smtzcn81/muhasebe/assets/urunler/png/123456.png

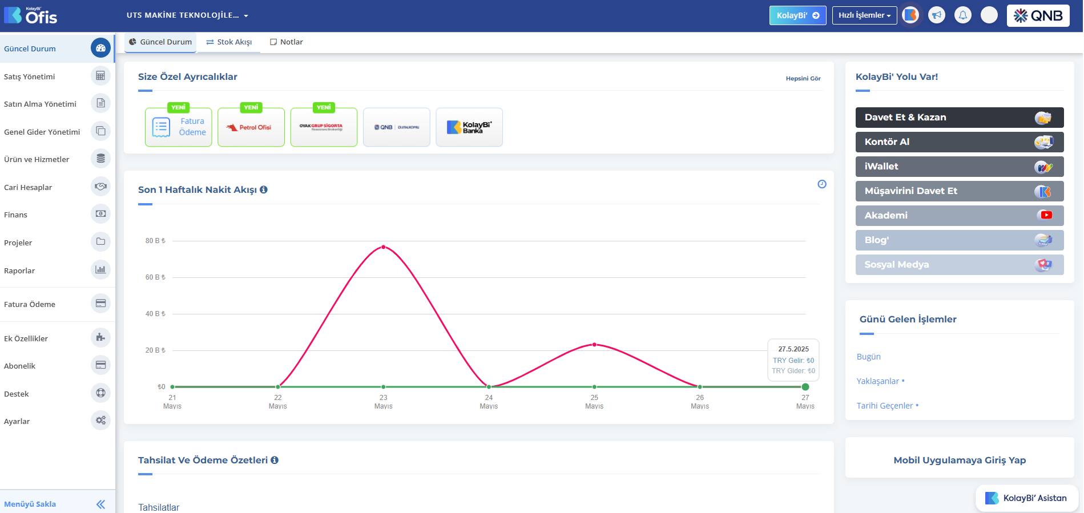
assets/urunler/png/123456.png
