smtzcn81/muhasebe/assets/urunler/xlsx/26092021_Bloklar_isleme.xlsx

KOD | TANIM | ADET | TEDARİKÇİ | BİRİM FİYAT | TOPLAM FİYAT | Termin Tarihi | Termin süresi
1196005001 | DIZME SASE | 1 | alsancak makına
1187003001 | USTTEN DIZME UST SABIT PLAKA | 1 | alsancak makına
1195006001 | FORMLAMA ALT SABİT BLOK | 1 | alsancak makına
1195012001 | FORMLAMA HAREKETLİ BLOK | 1 | alsancak makına
1195004001 | FORMLAMA ÜST SABİT BLOK | 1 | Alsancak makına
1193017001 | KESME ALT SABİT BLOK | 1 | Alsancak makına
1193014001 | KESME HAREKETLİ ALT-ÜST BLOK | 2 | alsancak makına
1193005001 | KESME UST SABİT BLOK | 1 | alsancak makına
