smtzcn81/muhasebe/assets/urunler/dxf/Kesme_2.dxf

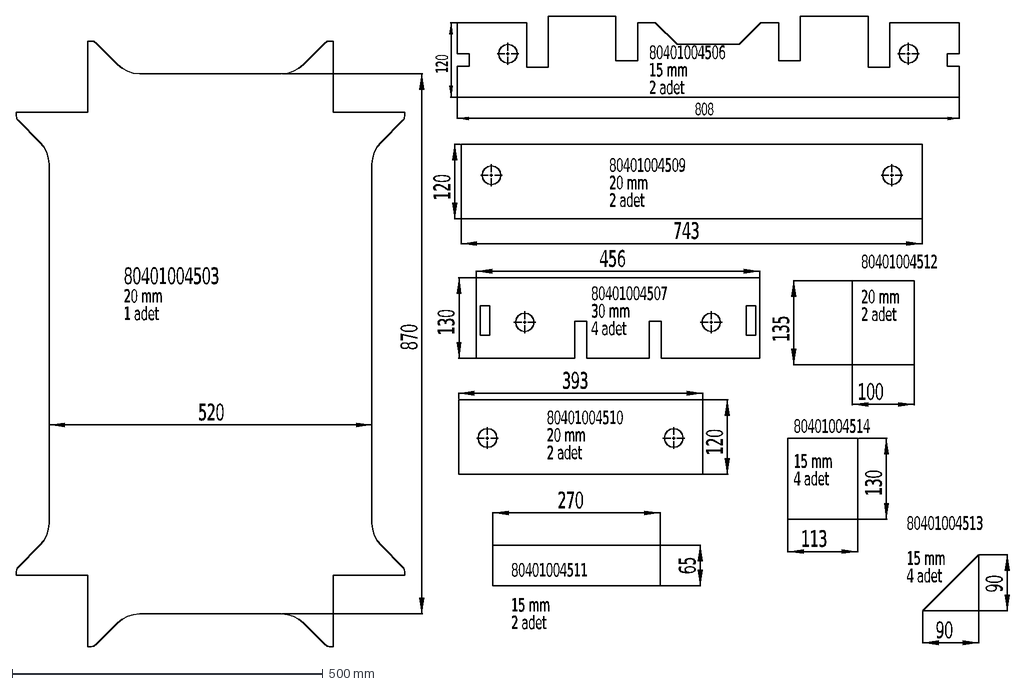
[picture p2: CAD file, 2025-06-05]
assets/urunler/dxf/Kesme_2.dxf
80401004503
20 mm
1 adet
520
870
808
120
80401004506
15 mm
2 adet
130
456
80401004507
30 mm
4 adet
743
80401004509
393
80401004510
65
270
80401004511
135
100
80401004512
90
80401004513
113
80401004514
