smtzcn81/muhasebe/assets/urunler/dxf/U6KA001003A.dxf

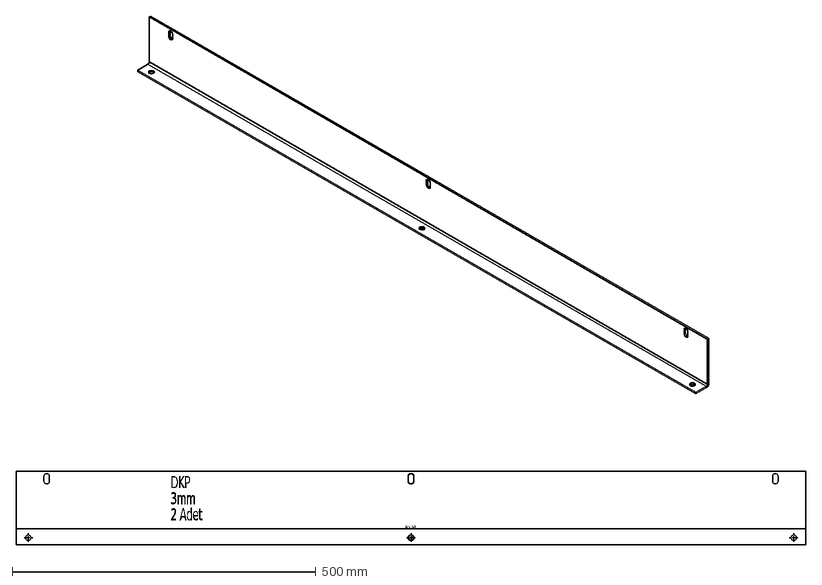
[picture p3: CAD file, 2025-06-05]
assets/urunler/dxf/U6KA001003A.dxf
UP 90° R 3
DKP
3mm
2 Adet
