smtzcn81/muhasebe/assets/urunler/dxf/Konveyor_Braket.dxf

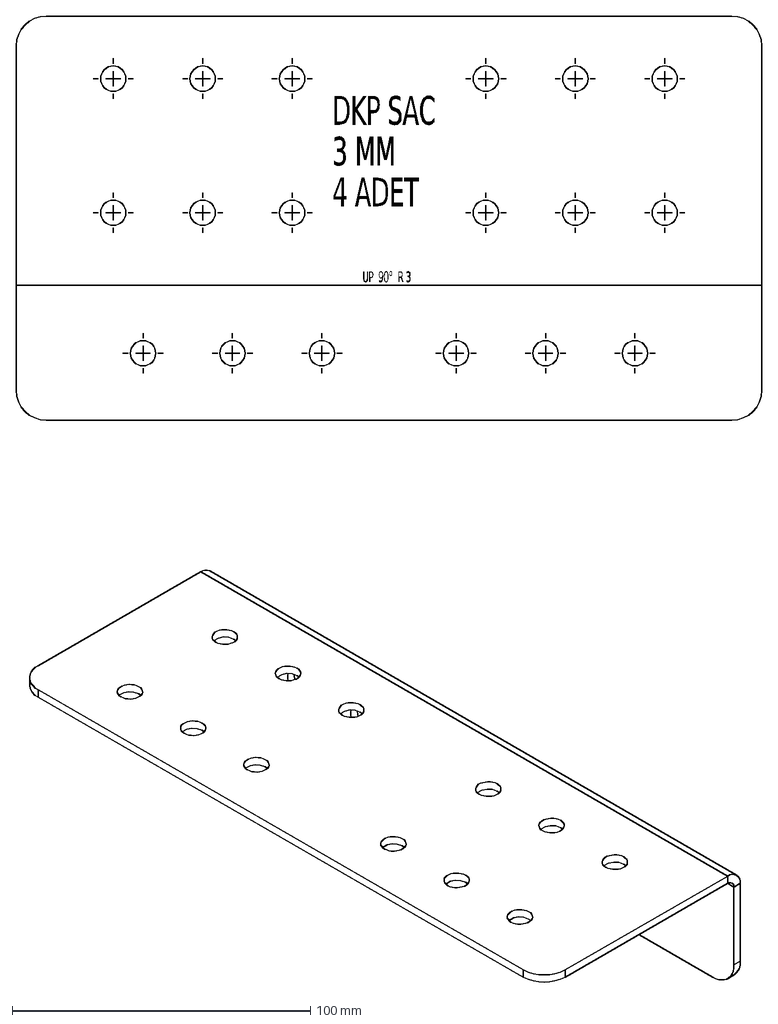
[picture p4: CAD file, 2025-06-05]
assets/urunler/dxf/Konveyor_Braket.dxf
DKP SAC
3 MM
4 ADET
UP 90° R 3
