smtzcn81/muhasebe/assets/urunler/dxf/US94-1104-015002.dxf

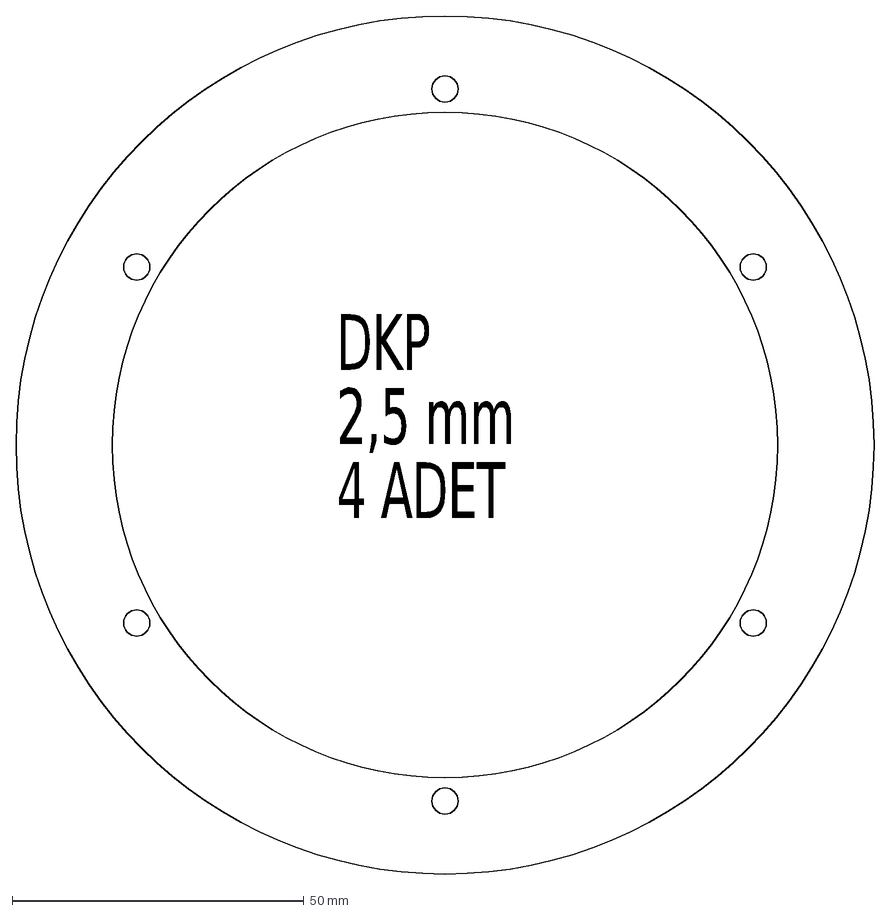
[picture p5: CAD file, 2025-06-05]
assets/urunler/dxf/US94-1104-015002.dxf
DKP
2,5 mm
4 ADET
