smtzcn81/muhasebe/assets/urunler/dxf/Form_3.dxf

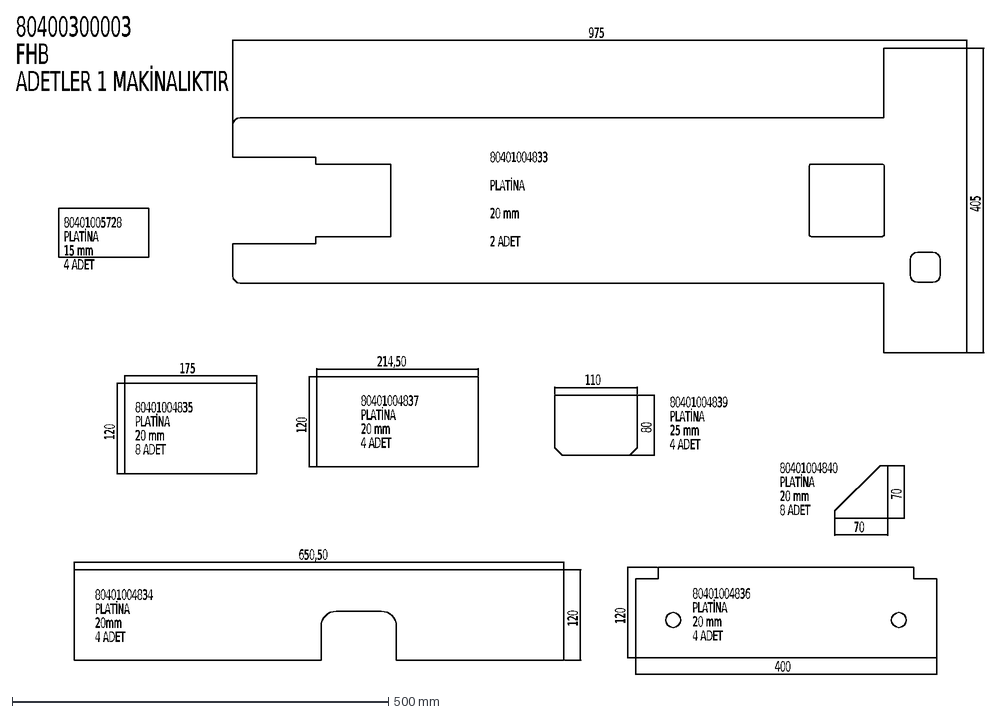
[picture p6: CAD file, 2025-06-05]
assets/urunler/dxf/Form_3.dxf
80401004837
PLATİNA
20 mm
4 ADET
80401004836
80400300003
FHB
ADETLER 1 MAKİNALIKTIR
405
975
80401004833
2 ADET
650,50
120
80401004834
20mm
175
80401004835
8 ADET
400
214,50
110
80
80401004839
25 mm
70
80401004840
80401005728
15 mm
