smtzcn81/muhasebe/assets/urunler/dxf/U6BS001004B.dxf

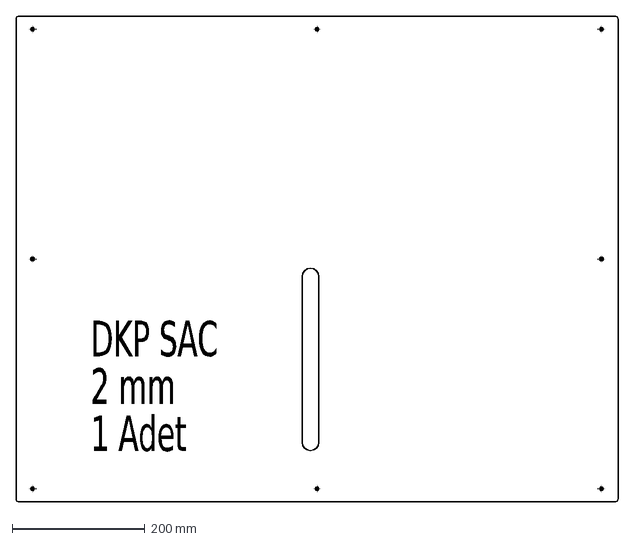
[picture p7: CAD file, 2025-06-05]
assets/urunler/dxf/U6BS001004B.dxf
DKP SAC
2 mm
1 Adet
