smtzcn81/muhasebe/assets/urunler/dxf/Kesme_3.dxf

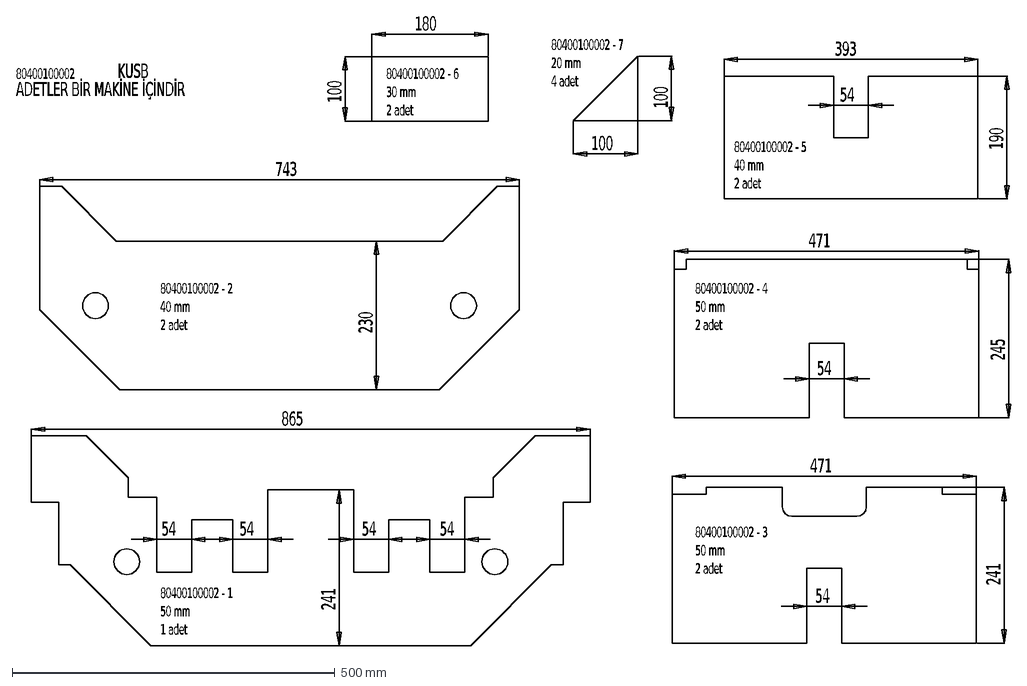
[picture p8: CAD file, 2025-06-05]
assets/urunler/dxf/Kesme_3.dxf
80400100002
KUSB
ADETLER BİR MAKİNE İÇİNDİR
80400100002 - 1
50 mm
1 adet
80400100002 - 2
40 mm
2 adet
80400100002 - 3
80400100002 - 4
80400100002 - 5
80400100002 - 6
30 mm
80400100002 - 7
20 mm
4 adet
230
743
865
241
54
471
245
190
393
180
100
