smtzcn81/muhasebe/assets/urunler/dxf/Panel_On_Sac.dxf

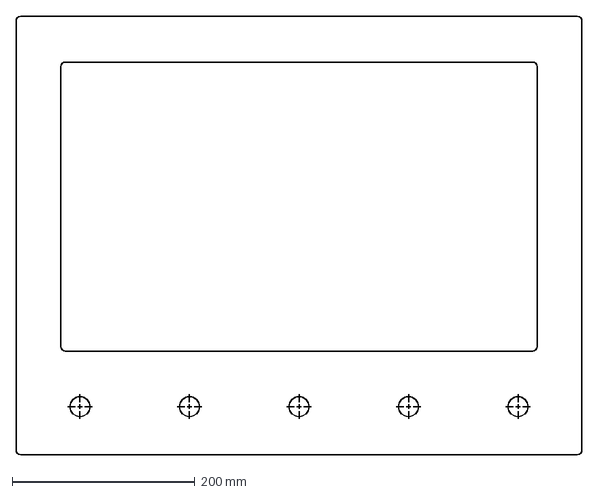
[picture p9: CAD file, 2025-06-05]
assets/urunler/dxf/Panel_On_Sac.dxf
620.0 x 480.0 mm
