smtzcn81/muhasebe/assets/urunler/dxf/Form_1.dxf

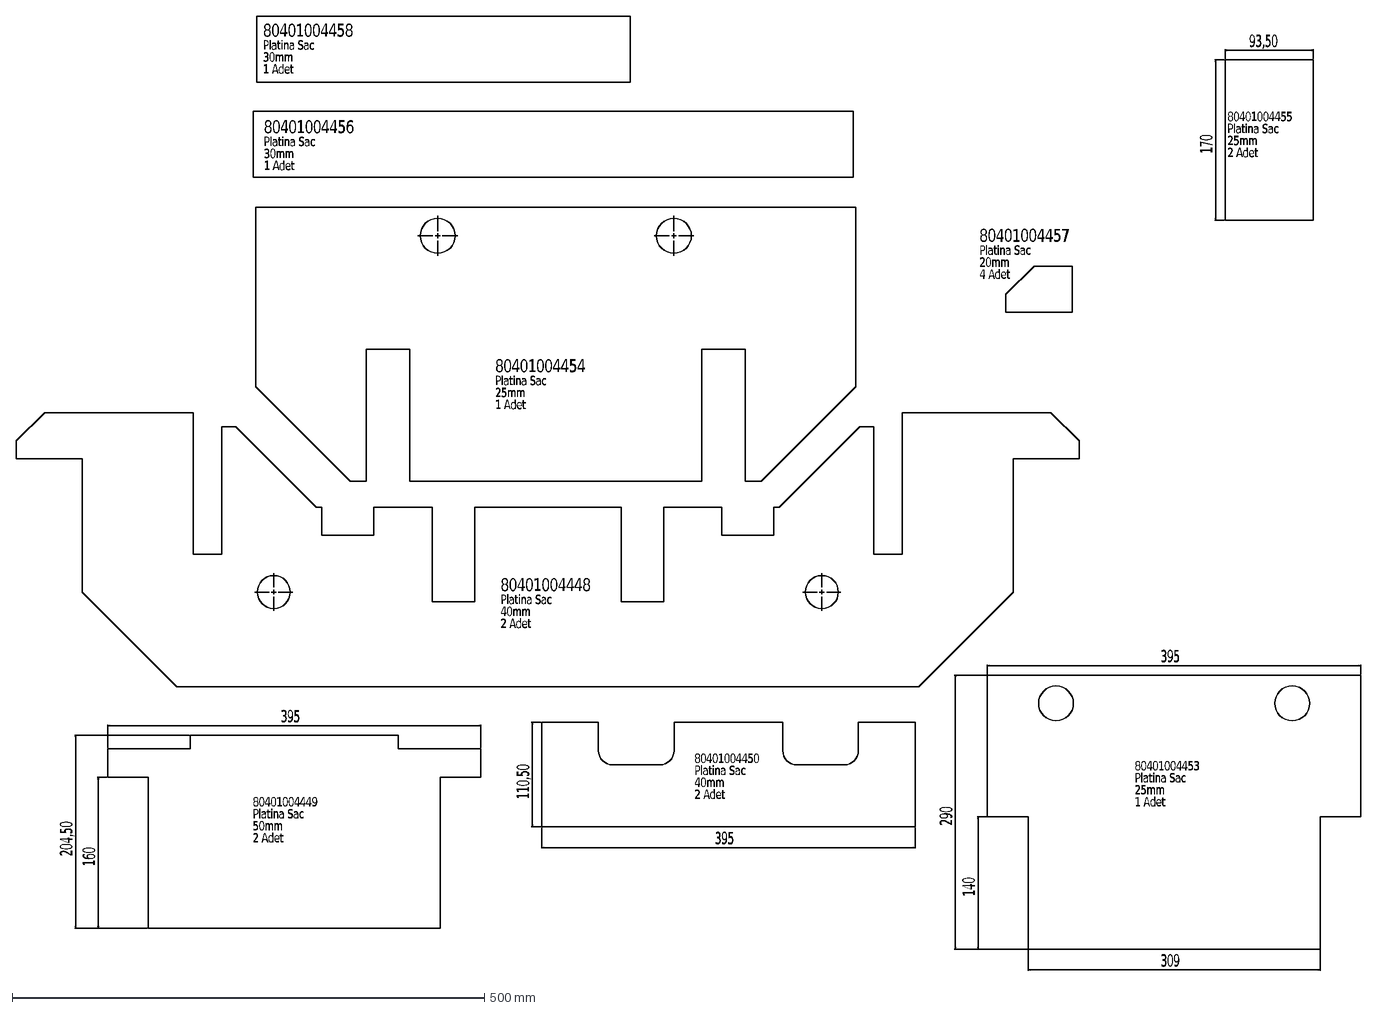
[picture p10: CAD file, 2025-06-05]
assets/urunler/dxf/Form_1.dxf
80401004448
Platina Sac
40mm
2 Adet
395
140
290
309
80401004453
25mm
1 Adet
204,50
160
80401004449
50mm
110,50
80401004450
93,50
170
80401004455
80401004454
80401004456
30mm
80401004457
20mm
4 Adet
80401004458
