smtzcn81/muhasebe/assets/urunler/dxf/Besleme_6545_U6_0105.dxf

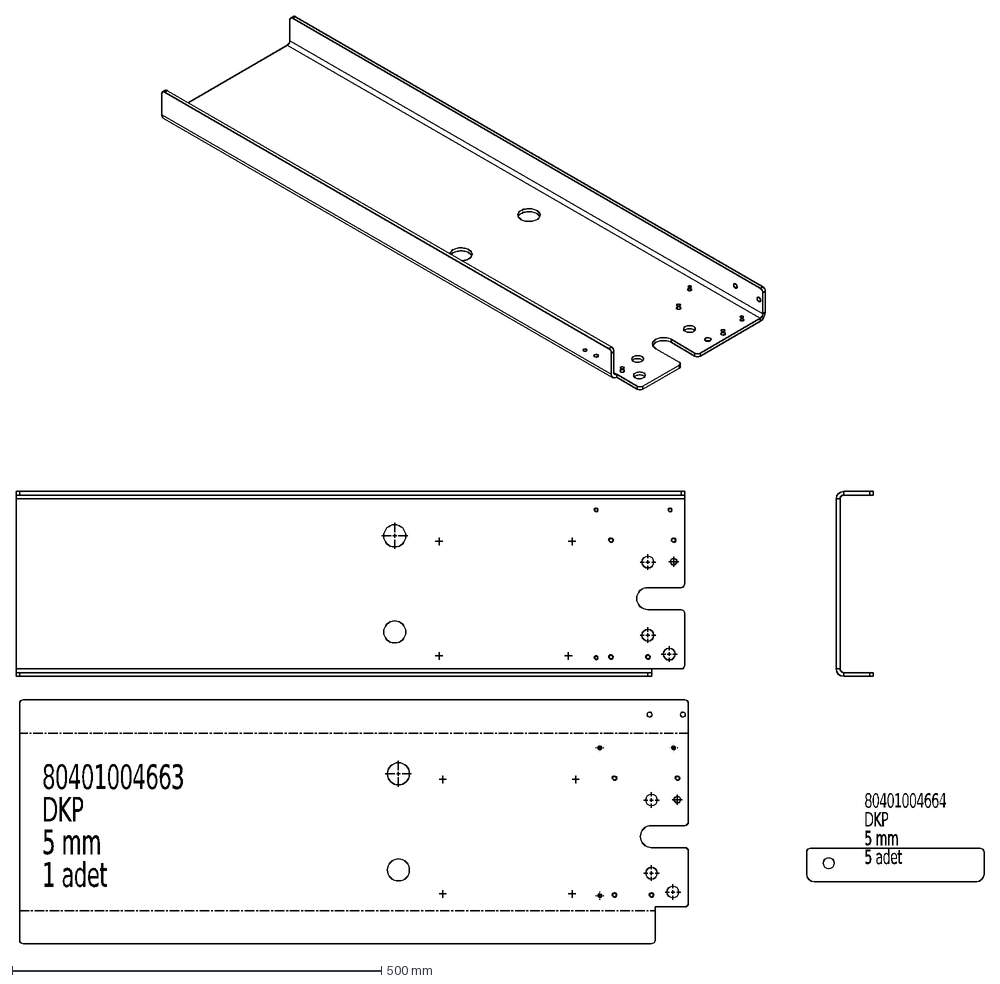
[picture p11: CAD file, 2025-06-05]
assets/urunler/dxf/Besleme_6545_U6_0105.dxf
80401004663
DKP
5 mm
1 adet
80401004664
5 adet
