smtzcn81/muhasebe/assets/urunler/dxf/U6KA004002A.dxf

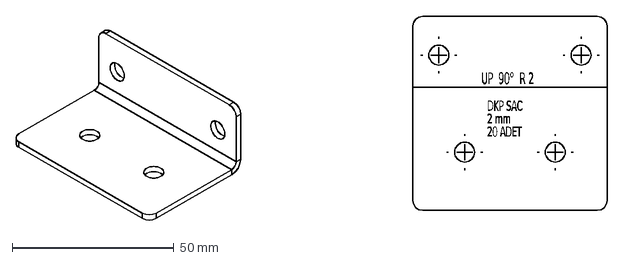
[picture p12: CAD file, 2025-06-05]
assets/urunler/dxf/U6KA004002A.dxf
DKP SAC
2 mm
20 ADET
UP 90° R 2
