smtzcn81/muhasebe/assets/urunler/dxf/U6KA001007A.dxf

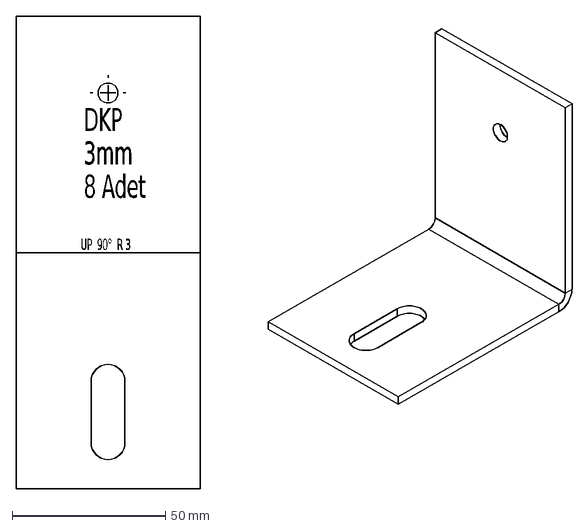
[picture p13: CAD file, 2025-06-05]
assets/urunler/dxf/U6KA001007A.dxf
DKP
3mm
8 Adet
UP 90° R 3
