smtzcn81/muhasebe/assets/urunler/dxf/U6KA001004A.dxf

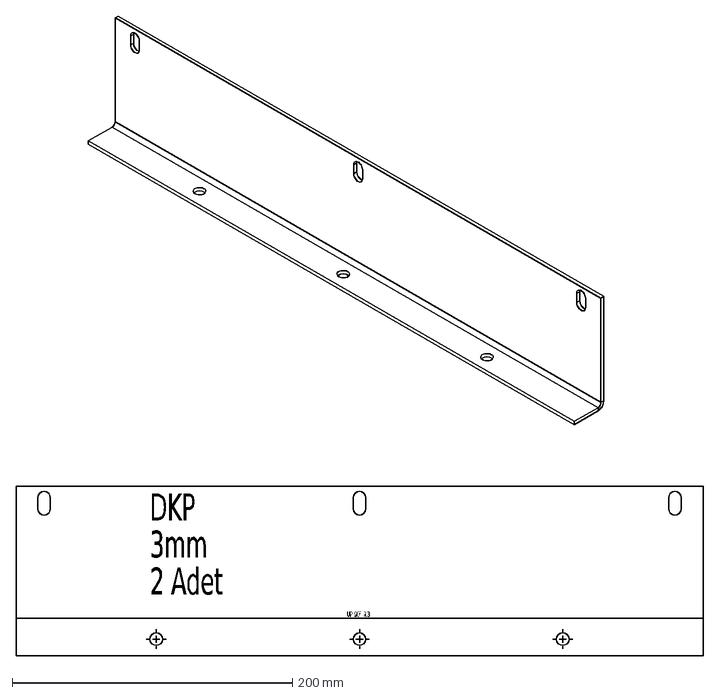
[picture p14: CAD file, 2025-06-05]
assets/urunler/dxf/U6KA001004A.dxf
UP 90° R 3
DKP
3mm
2 Adet
