smtzcn81/muhasebe/assets/urunler/dxf/U6KA001006A.dxf

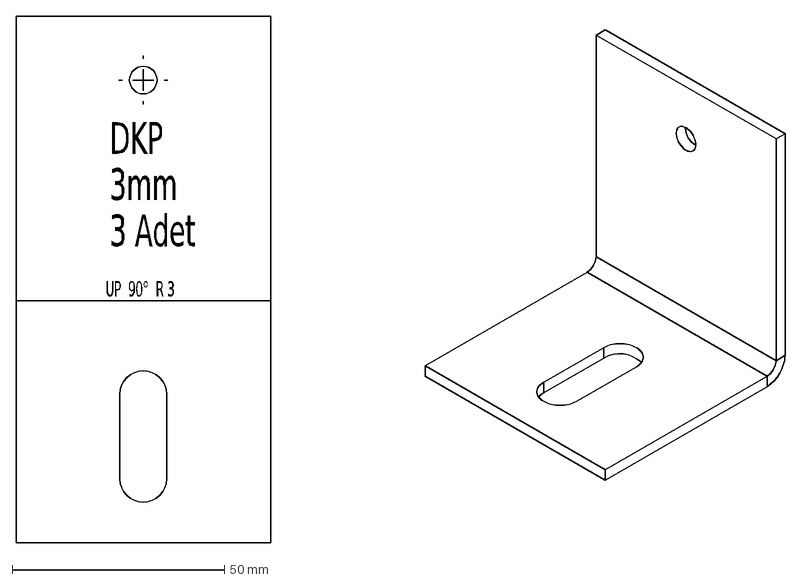
[picture p15: CAD file, 2025-06-05]
assets/urunler/dxf/U6KA001006A.dxf
DKP
3mm
3 Adet
UP 90° R 3
