smtzcn81/muhasebe/assets/urunler/dxf/U6KA001005A.dxf

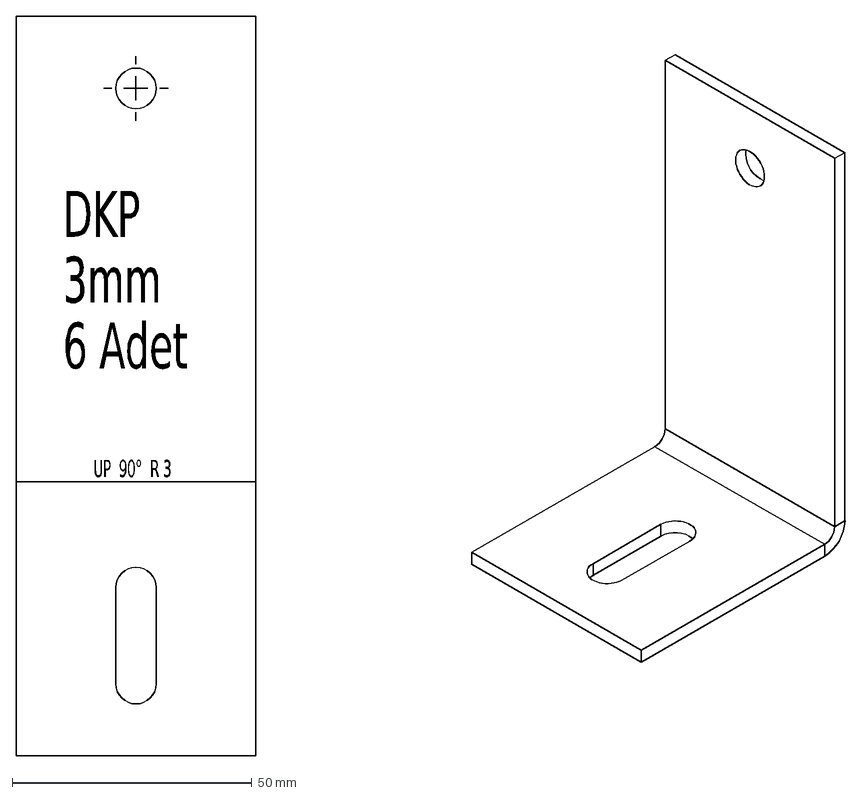
[picture p16: CAD file, 2025-06-05]
assets/urunler/dxf/U6KA001005A.dxf
DKP
3mm
6 Adet
UP 90° R 3
