smtzcn81/muhasebe/assets/urunler/dxf/Delme_Parcasi.dxf

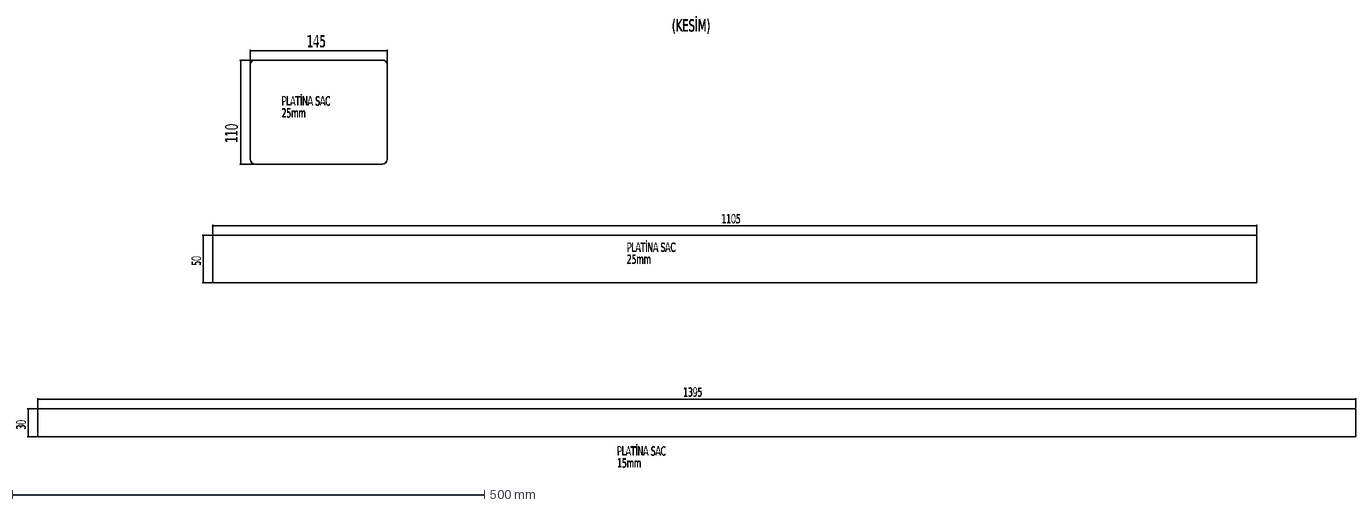
[picture p17: CAD file, 2025-06-05]
assets/urunler/dxf/Delme_Parcasi.dxf
1105
50
PLATİNA SAC
25mm
(KESİM)
30
1395
15mm
145
110
