smtzcn81/muhasebe/assets/urunler/dxf/Tava_Mal_ERidi_002.dxf

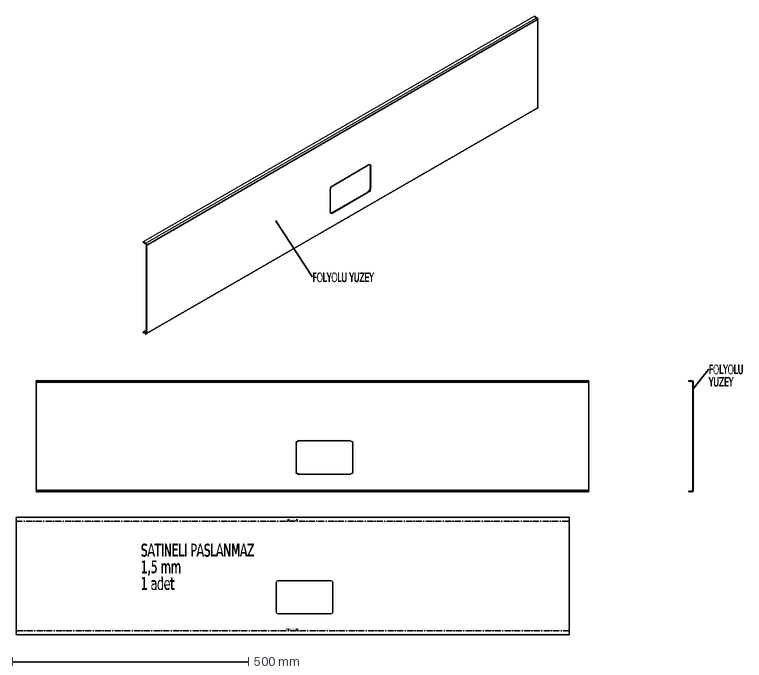
[picture p18: CAD file, 2025-06-05]
assets/urunler/dxf/Tava_Mal_ERidi_002.dxf
SATINELI PASLANMAZ
1,5 mm
1 adet
DOWN 90.00° R 1.50
FOLYOLU
YUZEY
FOLYOLU YUZEY
