smtzcn81/muhasebe/assets/urunler/dxf/U6KA001008A.dxf

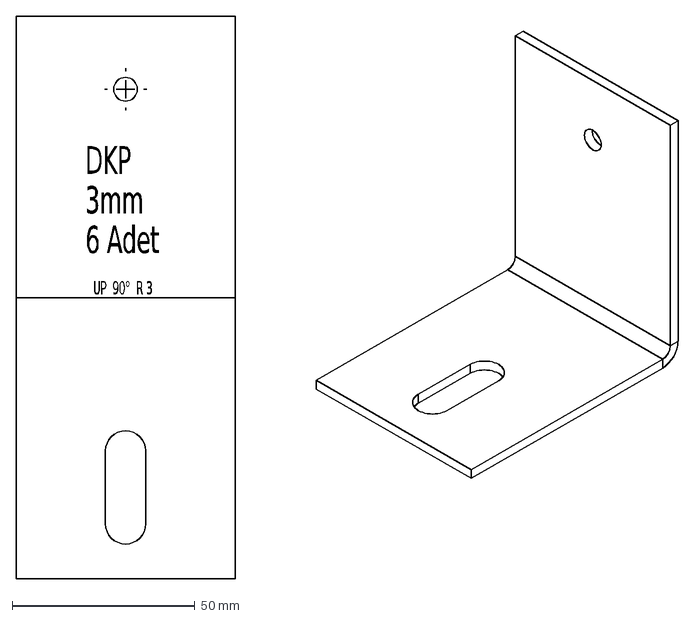
[picture p19: CAD file, 2025-06-05]
assets/urunler/dxf/U6KA001008A.dxf
DKP
3mm
6 Adet
UP 90° R 3
