smtzcn81/muhasebe/assets/urunler/dxf/Kesme_1.dxf

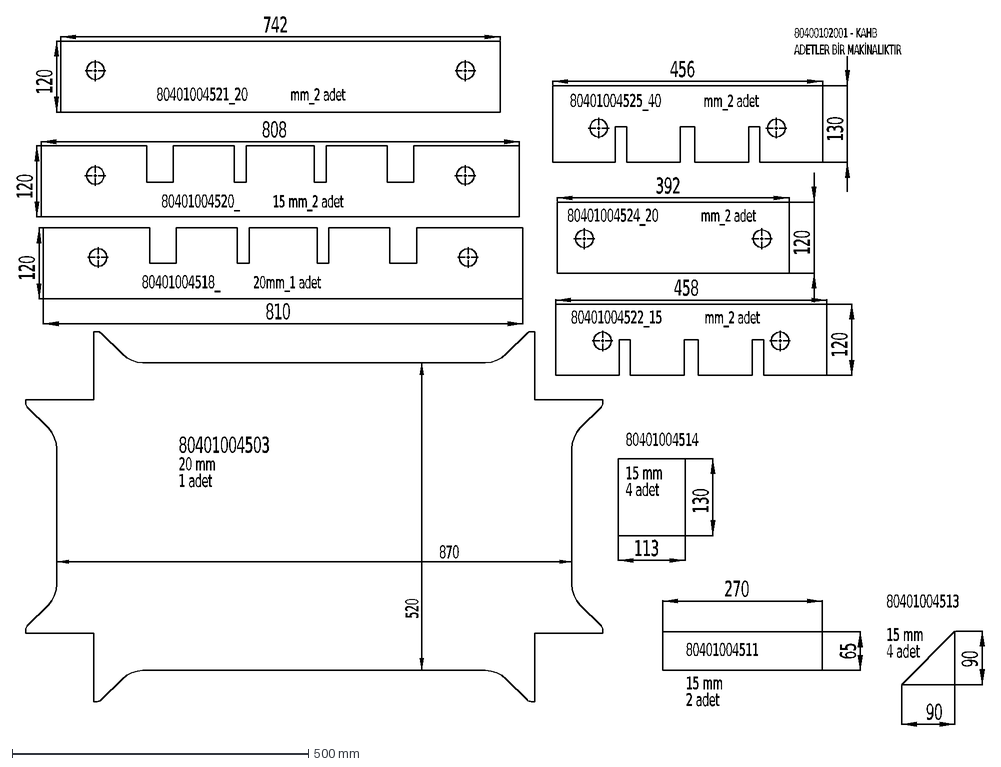
[picture p20: CAD file, 2025-06-05]
assets/urunler/dxf/Kesme_1.dxf
80401004518_
20mm_1 adet
520
870
80400102001 - KAHB
ADETLER BİR MAKİNALIKTIR
80401004503
20 mm
1 adet
90
80401004513
15 mm
4 adet
130
113
80401004514
65
270
80401004511
2 adet
810
120
808
80401004520_
15 mm_2 adet
742
80401004521_20
mm_2 adet
458
80401004522_15
392
80401004524_20
456
80401004525_40
