smtzcn81/muhasebe/assets/urunler/dxf/U6KA001001A.dxf

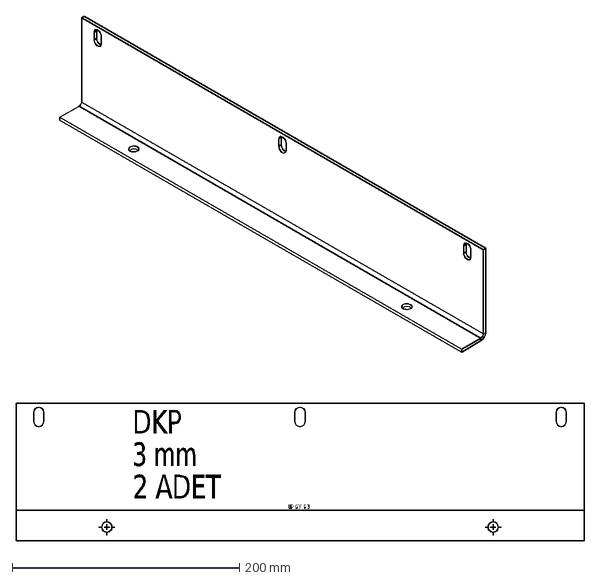
[picture p21: CAD file, 2025-06-05]
assets/urunler/dxf/U6KA001001A.dxf
DKP
3 mm
2 ADET
UP 90° R 3
