smtzcn81/muhasebe/assets/urunler/dxf/Besleme_6545_U6_0104.dxf

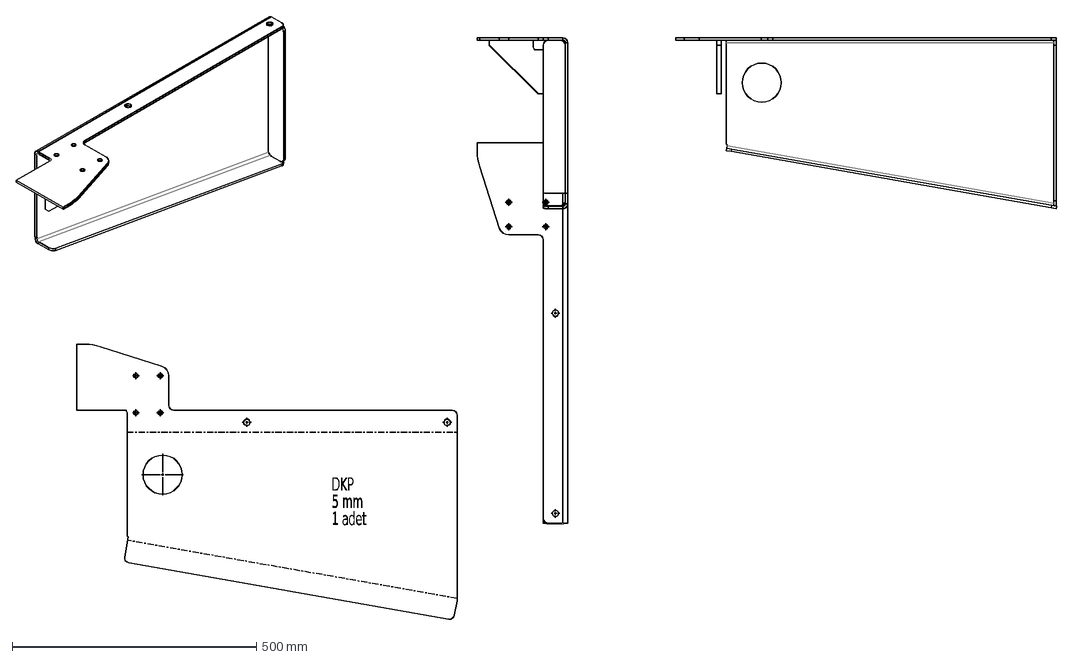
[picture p22: CAD file, 2025-06-05]
assets/urunler/dxf/Besleme_6545_U6_0104.dxf
DKP
5 mm
1 adet
