smtzcn81/muhasebe/assets/urunler/dxf/Kesme_4.dxf

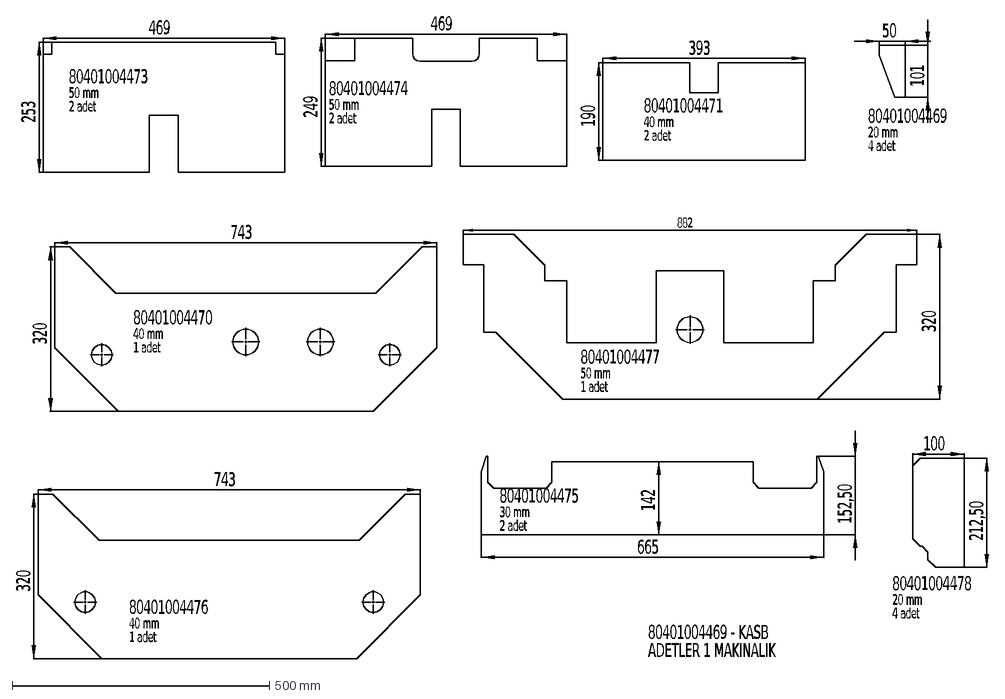
[picture p23: CAD file, 2025-06-05]
assets/urunler/dxf/Kesme_4.dxf
80401004476
40 mm
1 adet
80401004470
80401004473
50 mm
2 adet
80401004469 - KASB
ADETLER 1 MAKINALIK
50
101
80401004469
20 mm
4 adet
743
320
393
190
80401004471
469
253
249
80401004474
882
80401004477
212,50
100
80401004478
142
152,50
665
80401004475
30 mm
