smtzcn81/muhasebe/assets/urunler/dxf/Form_2.dxf

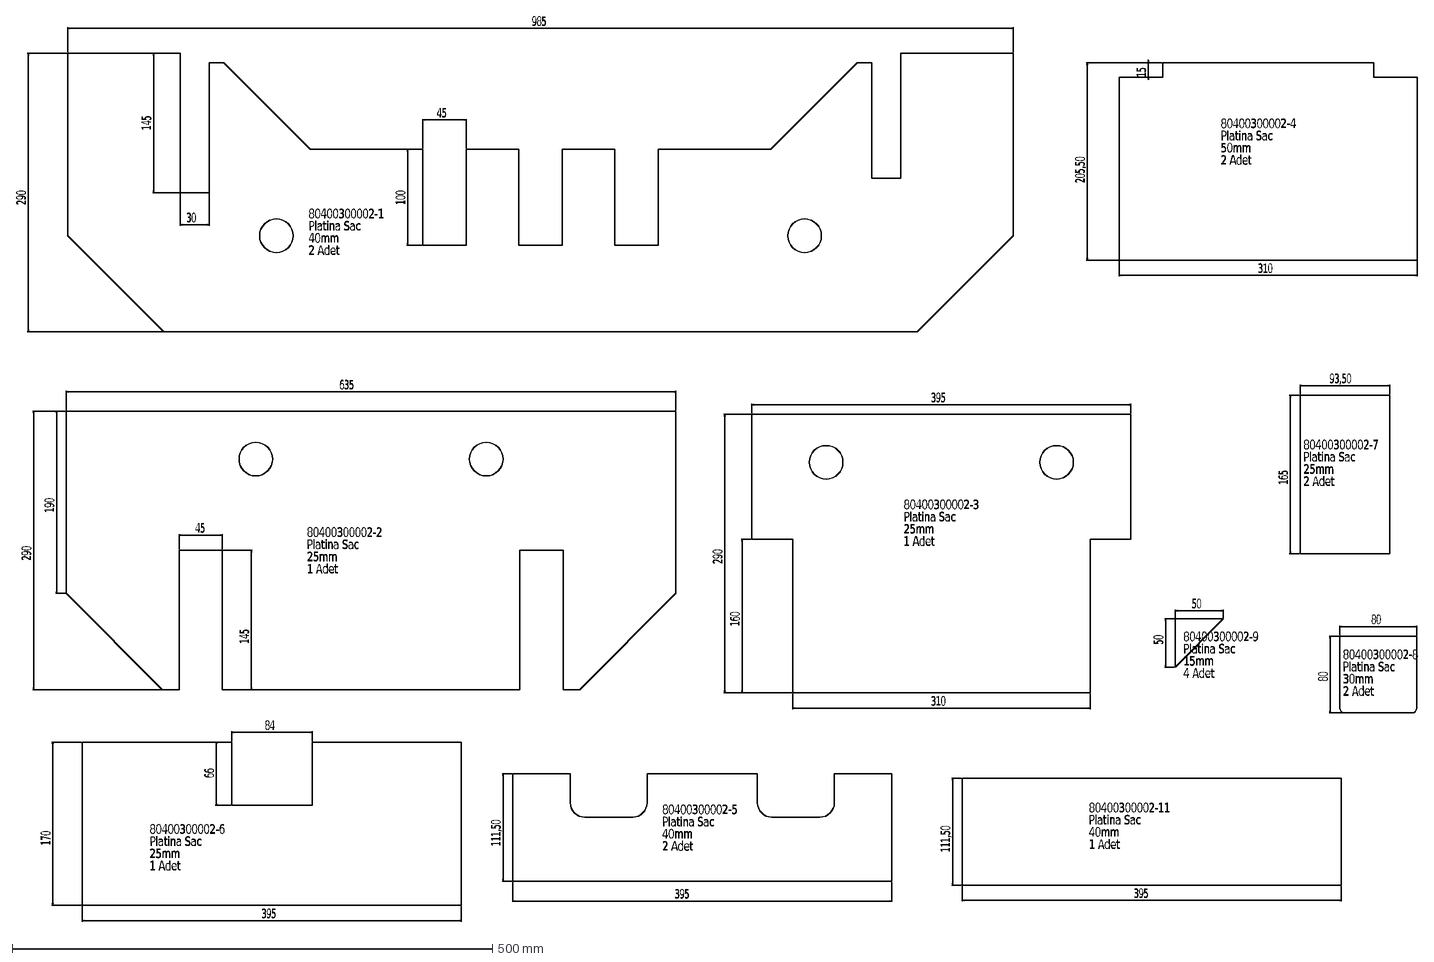
[picture p24: CAD file, 2025-06-05]
assets/urunler/dxf/Form_2.dxf
985
290
45
100
145
30
80400300002-1
Platina Sac
40mm
2 Adet
635
190
80400300002-2
25mm
1 Adet
395
160
310
80400300002-3
205,50
15
80400300002-4
50mm
111,50
80400300002-5
80400300002-11
170
84
66
80400300002-6
93,50
165
80400300002-7
80
80400300002-8
30mm
50
80400300002-9
15mm
4 Adet
