smtzcn81/muhasebe/assets/urunler/dxf/Besleme_6545_U6_0106.dxf

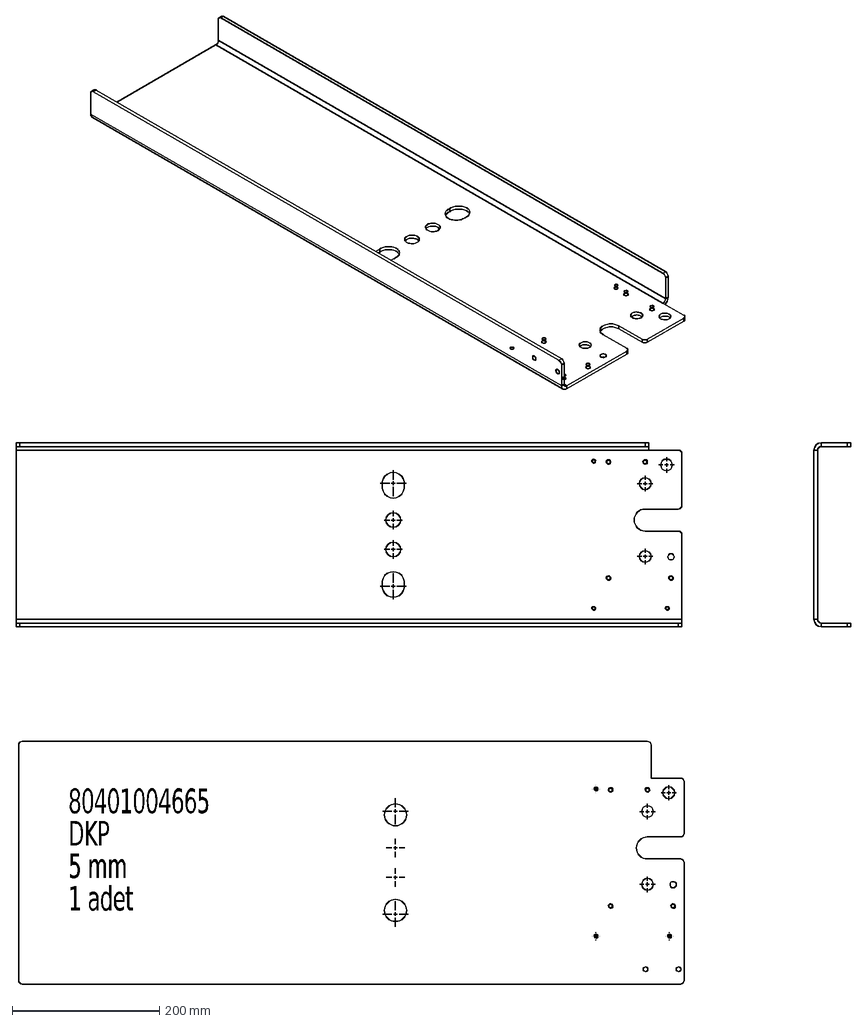
[picture p25: CAD file, 2025-06-05]
assets/urunler/dxf/Besleme_6545_U6_0106.dxf
80401004665
DKP
5 mm
1 adet
