smtzcn81/muhasebe/assets/urunler/dxf/Sac_Kesim_Parcalar.dxf

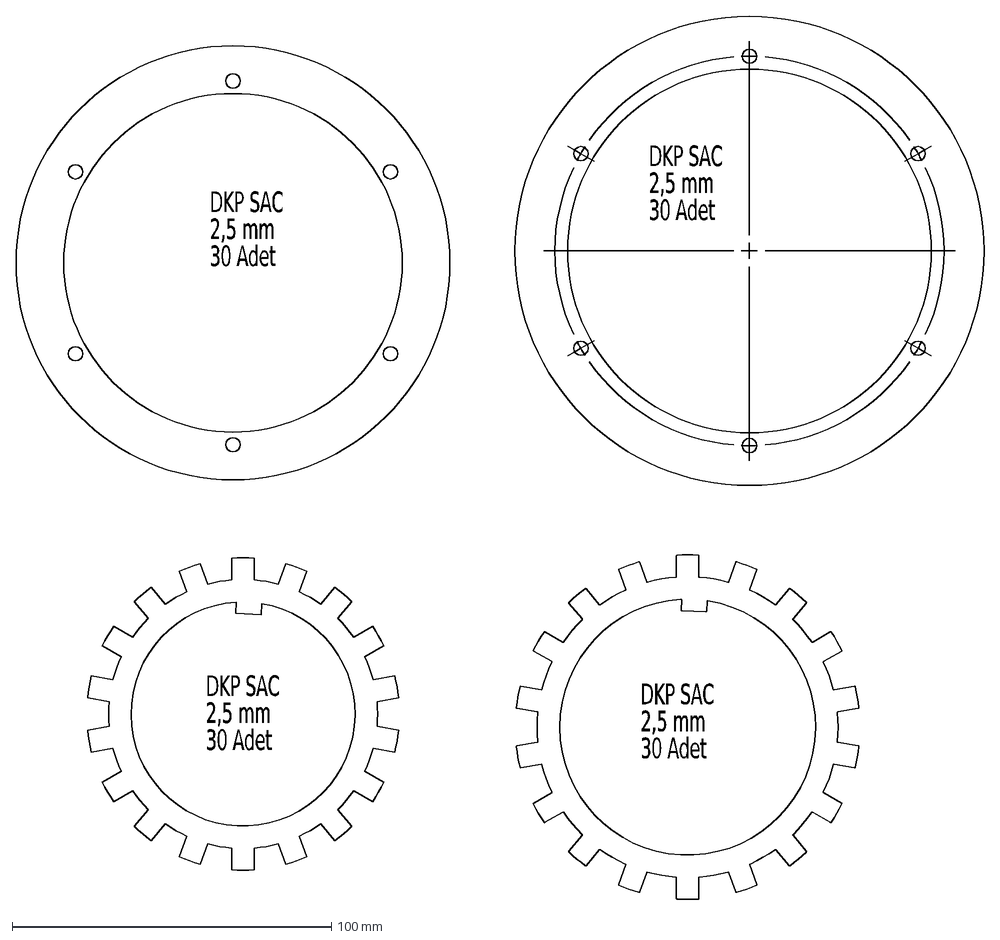
[picture p26: CAD file, 2025-06-05]
assets/urunler/dxf/Sac_Kesim_Parcalar.dxf
DKP SAC
2,5 mm
30 Adet
