smtzcn81/muhasebe/assets/urunler/dxf/U6KA006002A.dxf

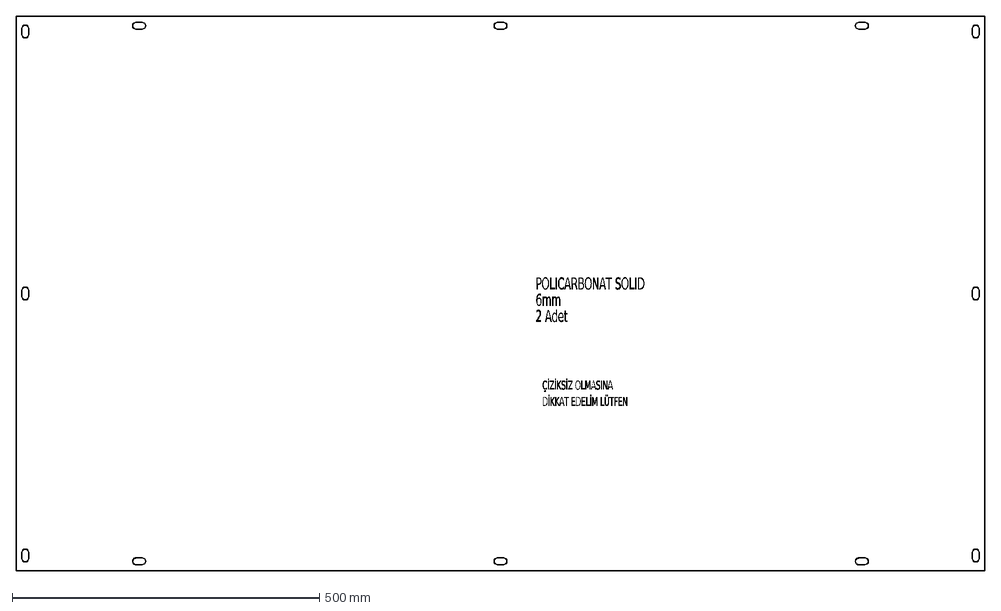
[picture p27: CAD file, 2025-06-05]
assets/urunler/dxf/U6KA006002A.dxf
POLICARBONAT SOLID
6mm
2 Adet
ÇİZİKSİZ OLMASINA
DİKKAT EDELİM LÜTFEN
