smtzcn81/muhasebe/assets/urunler/dxf/U6KA002001A.dxf

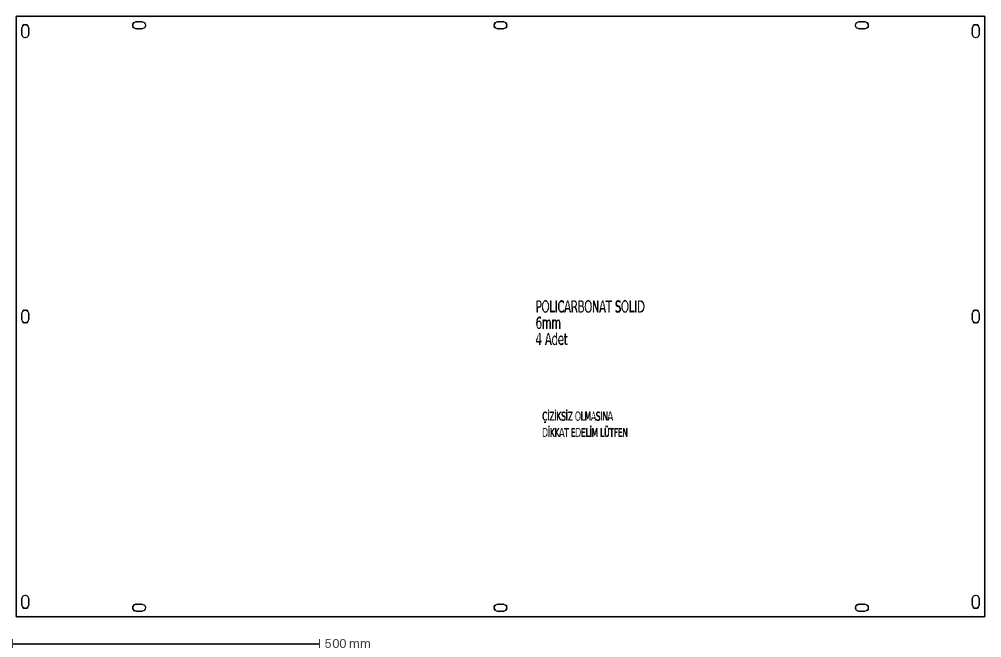
[picture p28: CAD file, 2025-06-05]
assets/urunler/dxf/U6KA002001A.dxf
POLICARBONAT SOLID
6mm
4 Adet
ÇİZİKSİZ OLMASINA
DİKKAT EDELİM LÜTFEN
