smtzcn81/muhasebe/assets/urunler/dxf/U6OP001004A.dxf

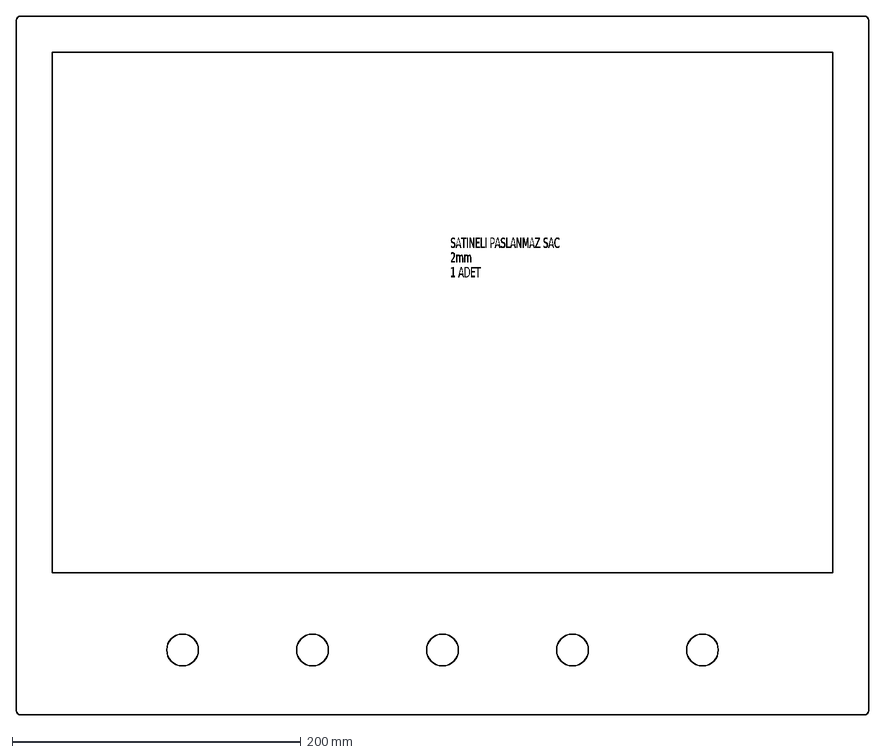
[picture p29: CAD file, 2025-06-05]
assets/urunler/dxf/U6OP001004A.dxf
SATINELI PASLANMAZ SAC
2mm
1 ADET
