smtzcn81/muhasebe/assets/urunler/dxf/Besleme_6545_U6_0103.dxf

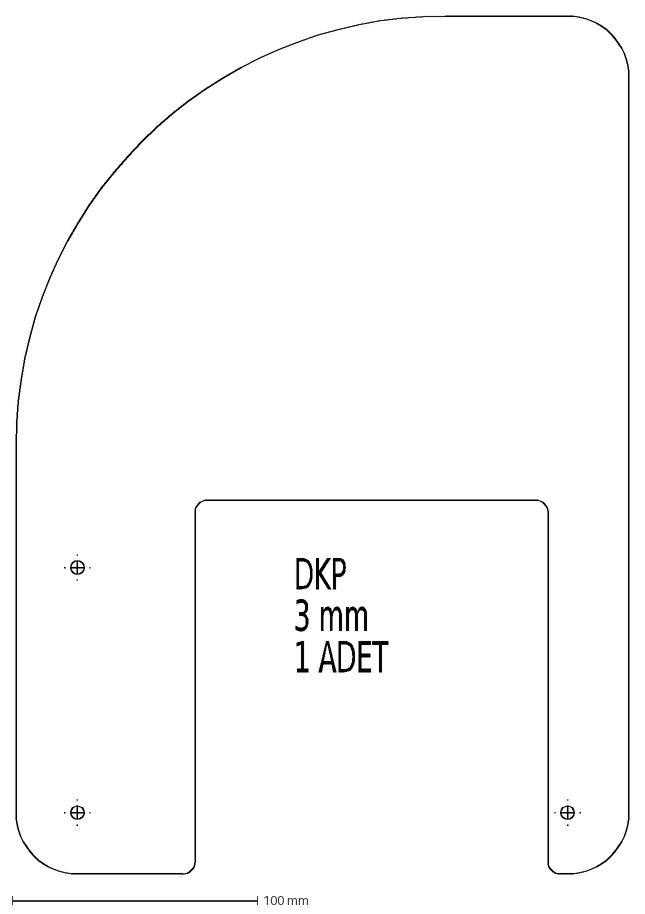
[picture p30: CAD file, 2025-06-05]
assets/urunler/dxf/Besleme_6545_U6_0103.dxf
DKP
3 mm
1 ADET
