smtzcn81/muhasebe/assets/urunler/dxf/SolKapamaS.dxf

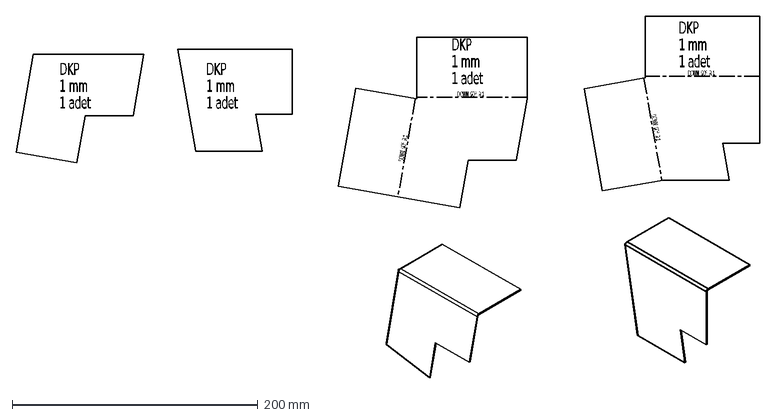
[picture p31: CAD file, 2025-06-05]
assets/urunler/dxf/SolKapamaS.dxf
DKP
1 mm
1 adet
DOWN 90° R 1
