smtzcn81/muhasebe/assets/urunler/dxf/U6KA001002A.dxf

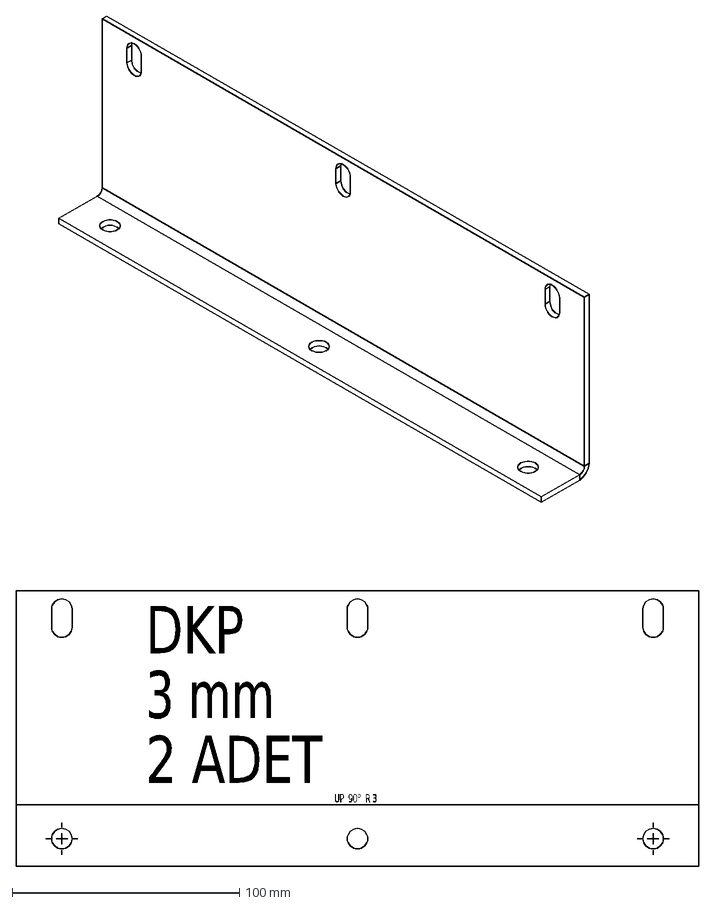
[picture p32: CAD file, 2025-06-05]
assets/urunler/dxf/U6KA001002A.dxf
DKP
3 mm
2 ADET
UP 90° R 3
