smtzcn81/muhasebe/assets/urunler/dxf/arkabaglamasaci2.dxf

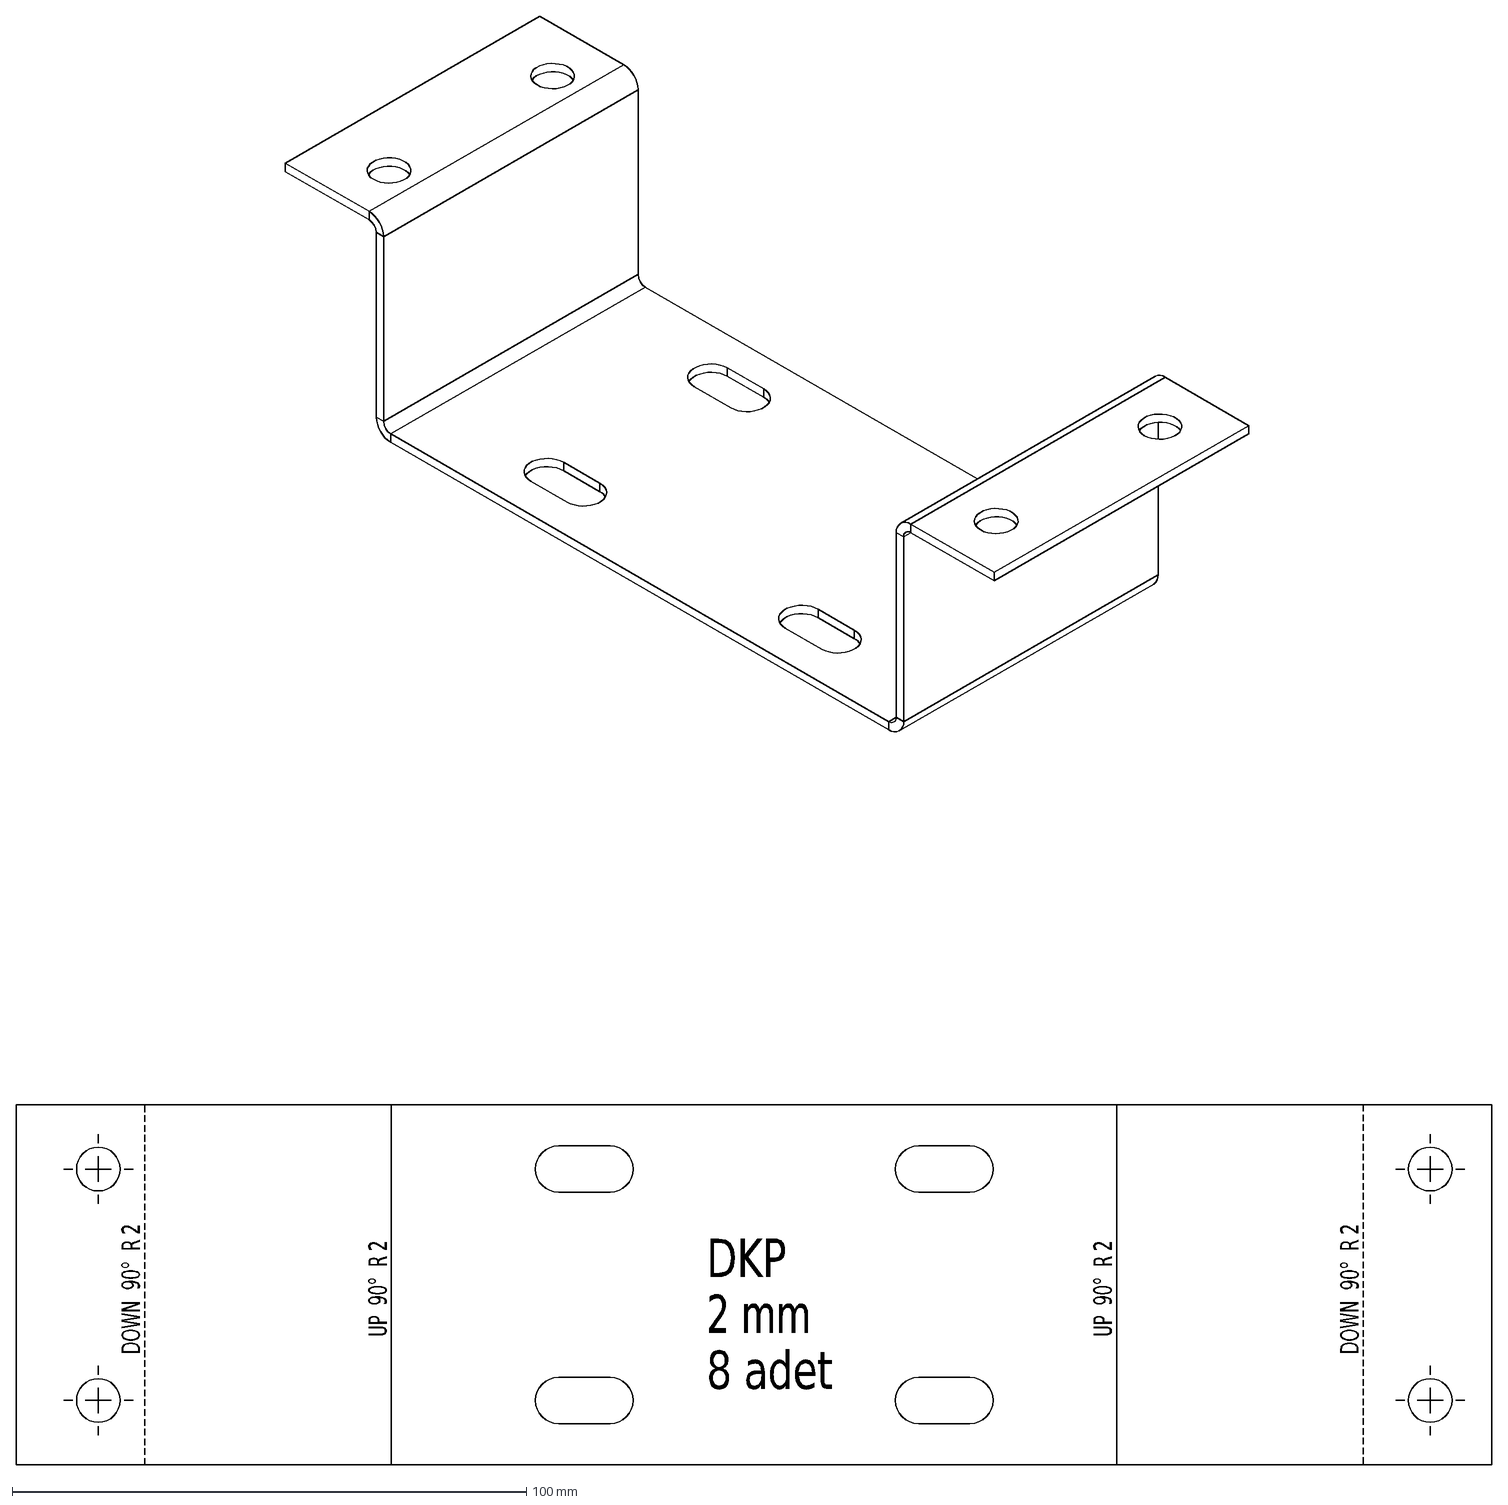
[picture p33: CAD file, 2025-06-05]
assets/urunler/dxf/arkabaglamasaci2.dxf
DKP
2 mm
8 adet
DOWN 90° R 2
UP 90° R 2
