smtzcn81/muhasebe/(list of files, cad)

Other CAD files:
assets/urunler/dxf/Tava_Mal_ERidi_001.dxf
assets/urunler/dxf/U6KA005001A.dxf
assets/urunler/dxf/Angular_sheet_rev2.dxf
assets/urunler/dxf/U6BS001002.dxf
assets/urunler/dxf/Besleme_6545_U6_0102.dxf
assets/urunler/dxf/U6BS001003A.dxf
assets/urunler/dxf/frontsheetrev2.dxf
assets/urunler/dxf/Alt_Giydirme_Sac_Montaj.dxf
assets/urunler/dxf/SAC_MONTAJ_LAZER.dxf
assets/urunler/dxf/Angular_sheet_door_Rev2.dxf
assets/urunler/dxf/U6KA006001A.dxf
assets/urunler/dxf/1183004002.dxf
assets/urunler/dxf/1185013011_9SDS.dxf
assets/urunler/dxf/1185013012_9SDS.dxf
assets/urunler/dxf/1185025002_7XLD.dxf
assets/urunler/dxf/1186000013.dxf
assets/urunler/dxf/1186000013_6545A.dxf
assets/urunler/dxf/1186000013_7XLD.dxf
assets/urunler/dxf/1186000013_TM900.dxf
assets/urunler/dxf/1186000016_6545A.dxf
assets/urunler/dxf/1186000016_7XLD.dxf
assets/urunler/dxf/1186000016_TM900.dxf
assets/urunler/dxf/1186001001_6545A.dxf
assets/urunler/dxf/1186001001_7XLD.dxf
assets/urunler/dxf/1186001001_TM900.dxf
assets/urunler/dxf/1187003001_9SDS.dxf
assets/urunler/dxf/1188005002_9SDS.dxf
assets/urunler/dxf/1188005017_9SDS.dxf
assets/urunler/dxf/1188006005_7XLD.dxf
assets/urunler/dxf/1188044001_9SDS.dxf
assets/urunler/dxf/1188044003_9SDS.dxf
assets/urunler/dxf/1188048001_9SDS.dxf
assets/urunler/dxf/1188049001_9SDS.dxf
assets/urunler/dxf/1188050001_9SDS.dxf
assets/urunler/dxf/1189001025.dxf
assets/urunler/dxf/1192000003.dxf
assets/urunler/dxf/1192000003_6545A.dxf
assets/urunler/dxf/1192000003_7XLD.dxf
assets/urunler/dxf/1192000003_TM900.dxf
assets/urunler/dxf/1192000004.dxf
assets/urunler/dxf/1192000004_6545A.dxf
assets/urunler/dxf/1192000004_7XLD.dxf
assets/urunler/dxf/1192000004_TM900.dxf
assets/urunler/dxf/1193005001_9SDS.dxf
assets/urunler/dxf/1193012001B.dxf
assets/urunler/dxf/1193012001_9SDS.dxf
assets/urunler/dxf/1193012006B.dxf
assets/urunler/dxf/1193013001_9SDS.dxf
assets/urunler/dxf/1193013002_9SDS.dxf
assets/urunler/dxf/1193013005_9SDS.dxf
assets/urunler/dxf/1193014001_9SDS.dxf
assets/urunler/dxf/1193017001_9SDS.dxf
assets/urunler/dxf/1193018006_9SDS.dxf
assets/urunler/dxf/1193057001_9SDS.dxf
assets/urunler/dxf/1193059001.dxf
assets/urunler/dxf/1194000005_U6.dxf
assets/urunler/dxf/1194000015_U6.dxf
assets/urunler/dxf/1194000016_U6.dxf
assets/urunler/dxf/1194000036.dxf
assets/urunler/dxf/1194000037.dxf
assets/urunler/dxf/1194000040_U6.dxf
assets/urunler/dxf/1194000041_U6.dxf
assets/urunler/dxf/1194000042_U6.dxf
assets/urunler/dxf/1194000043_U6.dxf
assets/urunler/dxf/1194000046_U6.dxf
assets/urunler/dxf/1194000047_U6.dxf
assets/urunler/dxf/1194000051_U6.dxf
assets/urunler/dxf/1194000052_U6.dxf
assets/urunler/dxf/1194000059_U6.dxf
assets/urunler/dxf/1194000060_U6.dxf
assets/urunler/dxf/1194000061_U6.dxf
assets/urunler/dxf/1194000071_U6.dxf
assets/urunler/dxf/1194000080_U6.dxf
assets/urunler/dxf/1194000099_U6.dxf
assets/urunler/dxf/1194018013_7XLD.dxf
assets/urunler/dxf/1195004001_9SDS.dxf
assets/urunler/dxf/1195006001_9SDS.dxf
assets/urunler/dxf/1195012001_9SDS.dxf
assets/urunler/dxf/1195013005.dxf
assets/urunler/dxf/1195013005_7XLD.dxf
assets/urunler/dxf/1195013025.dxf
assets/urunler/dxf/1195013027_9SDS.dxf
assets/urunler/dxf/1195013028_9SDS.dxf
assets/urunler/dxf/1195026001_9SDS.dxf
assets/urunler/dxf/1195026007_9SDS.dxf
assets/urunler/dxf/1195071002.dxf
assets/urunler/dxf/1196005001_9SDS.dxf
assets/urunler/dxf/1197000001.dxf
assets/urunler/dxf/1197000001_9SDS.dxf
assets/urunler/dxf/1197000015_9SDS.dxf
assets/urunler/dxf/1197001001_9SDS.dxf
assets/urunler/dxf/1197002006_9SDS.dxf
assets/urunler/dxf/1197005001.dxf
assets/urunler/dxf/1198001003_6545A.dxf
assets/urunler/dxf/1198001003_7XLD.dxf
assets/urunler/dxf/1198001003_TM900.dxf
assets/urunler/dxf/1198001004_6545A.dxf
assets/urunler/dxf/1198001004_7XLD.dxf
assets/urunler/dxf/1198001004_TM900.dxf
assets/urunler/dxf/1198002005.dxf
assets/urunler/dxf/1198002005_6545A.dxf
assets/urunler/dxf/1198002005_7XLD.dxf
assets/urunler/dxf/1198002005_TM900.dxf
assets/urunler/dxf/1198003003_6545A.dxf
assets/urunler/dxf/1198003003_7XLD.dxf
assets/urunler/dxf/1198003003_TM900.dxf
assets/urunler/dxf/1198004002.dxf
assets/urunler/dxf/1198005002.dxf
assets/urunler/dxf/1198005002_6545A.dxf
assets/urunler/dxf/1198005002_7XLD.dxf
assets/urunler/dxf/1198005002_TM900.dxf
assets/urunler/dxf/1198005003.dxf
assets/urunler/dxf/1198005003_6545A.dxf
assets/urunler/dxf/1198005003_7XLD.dxf
assets/urunler/dxf/1198005003_TM900.dxf
assets/urunler/dxf/1198005004.dxf
assets/urunler/dxf/1198005004_6545A.dxf
assets/urunler/dxf/1198005004_7XLD.dxf
assets/urunler/dxf/1198005004_TM900.dxf
assets/urunler/dxf/1198005005.dxf
assets/urunler/dxf/1198005005_6545A.dxf
assets/urunler/dxf/1198005005_7XLD.dxf
assets/urunler/dxf/1198005005_TM900.dxf
assets/urunler/dxf/1198005019.dxf
assets/urunler/dxf/1198005019_6545A.dxf
assets/urunler/dxf/1198005019_7XLD.dxf
assets/urunler/dxf/1198005019_TM900.dxf
assets/urunler/dxf/1198005020.dxf
assets/urunler/dxf/1198005020_6545A.dxf
assets/urunler/dxf/1198005020_7XLD.dxf
assets/urunler/dxf/1198005020_TM900.dxf
assets/urunler/dxf/1198005021.dxf
assets/urunler/dxf/1198005021_6545A.dxf
assets/urunler/dxf/1198005021_7XLD.dxf
assets/urunler/dxf/1198005021_TM900.dxf
assets/urunler/dxf/1198005025.dxf
assets/urunler/dxf/1198005025B_6545A-1.dxf
assets/urunler/dxf/1198005025B_6545A.dxf
assets/urunler/dxf/1198005025_6545A.dxf
assets/urunler/dxf/1198005025_7XLD.dxf
assets/urunler/dxf/1198005025_TM900.dxf
assets/urunler/dxf/1198005026.dxf
assets/urunler/dxf/1198005026_6545A.dxf
assets/urunler/dxf/1198005026_7XLD.dxf
assets/urunler/dxf/1198005026_TM900.dxf
assets/urunler/dxf/1198005027.dxf
assets/urunler/dxf/1198005027_6545A.dxf
assets/urunler/dxf/1198005027_7XLD.dxf
assets/urunler/dxf/1198005027_TM900.dxf
assets/urunler/dxf/1198005028.dxf
assets/urunler/dxf/1198005028_6545A.dxf
assets/urunler/dxf/1198005028_7XLD.dxf
assets/urunler/dxf/1198005028_TM900.dxf
assets/urunler/dxf/1198005029.dxf
assets/urunler/dxf/1198005029_6545A.dxf
assets/urunler/dxf/1198005029_7XLD.dxf
assets/urunler/dxf/1198005029_TM900.dxf
assets/urunler/dxf/1198005030.dxf
assets/urunler/dxf/1198005030_6545A.dxf
assets/urunler/dxf/1198005030_7XLD.dxf
assets/urunler/dxf/1198005030_TM900.dxf
assets/urunler/dxf/1199003001.dxf
assets/urunler/dxf/1199004005.dxf
assets/urunler/dxf/1199004020.dxf
assets/urunler/dxf/1199006001.dxf
assets/urunler/dxf/1199007001.dxf
assets/urunler/dxf/1199009017_9SDS.dxf
assets/urunler/dxf/1199009023.dxf
assets/urunler/dxf/1199009023_9SDS.dxf
assets/urunler/dxf/1199012002.dxf
assets/urunler/dxf/1199012002_9SDS.dxf
assets/urunler/dxf/1222002001.dxf
assets/urunler/dxf/1256002001.dxf
assets/urunler/dxf/1256002010.dxf
assets/urunler/dxf/1256002011.dxf
assets/urunler/dxf/1256011001.dxf
assets/urunler/dxf/1256011003.dxf
assets/urunler/dxf/1256011004.dxf
assets/urunler/dxf/1256016001.dxf
assets/urunler/dxf/1256017001.dxf
assets/urunler/dxf/1256022001.dxf
assets/urunler/dxf/1256023001.dxf
assets/urunler/dxf/1275008001.dxf
assets/urunler/dxf/1279010006.dxf
assets/urunler/dxf/1281001001_U6.dxf
assets/urunler/dxf/1282000032_U6.dxf
assets/urunler/dxf/1285009010.dxf
assets/urunler/dxf/1285011003.dxf
assets/urunler/dxf/1286000004.dxf
assets/urunler/dxf/1286000004_6545A.dxf
assets/urunler/dxf/1286000004_7XLD.dxf
assets/urunler/dxf/1286000004_TM900.dxf
assets/urunler/dxf/1288012005_7XLD.dxf
assets/urunler/dxf/1288012008_7XLD.dxf
assets/urunler/dxf/1288012011_7XLD.dxf
assets/urunler/dxf/1288012012_7XLD.dxf
assets/urunler/dxf/1288021010.dxf
assets/urunler/dxf/1288035001.dxf
assets/urunler/dxf/1289001008.dxf
assets/urunler/dxf/1289001017.dxf
assets/urunler/dxf/1289001022.dxf
assets/urunler/dxf/1289004002.dxf
assets/urunler/dxf/1292000003_6545A.dxf
assets/urunler/dxf/1292000003_7XLD.dxf
assets/urunler/dxf/1292000003_TM900.dxf
assets/urunler/dxf/1292005001_7XLD.dxf
assets/urunler/dxf/1293010002.dxf
assets/urunler/dxf/1293022006_1.dxf
assets/urunler/dxf/1293035002.dxf
assets/urunler/dxf/1293035002_7XLD.dxf
assets/urunler/dxf/1294000001_U6.dxf
assets/urunler/dxf/1294000003_U6.dxf
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
