smtzcn81/muhasebe/assets/urunler/pdf/1183001008.pdf

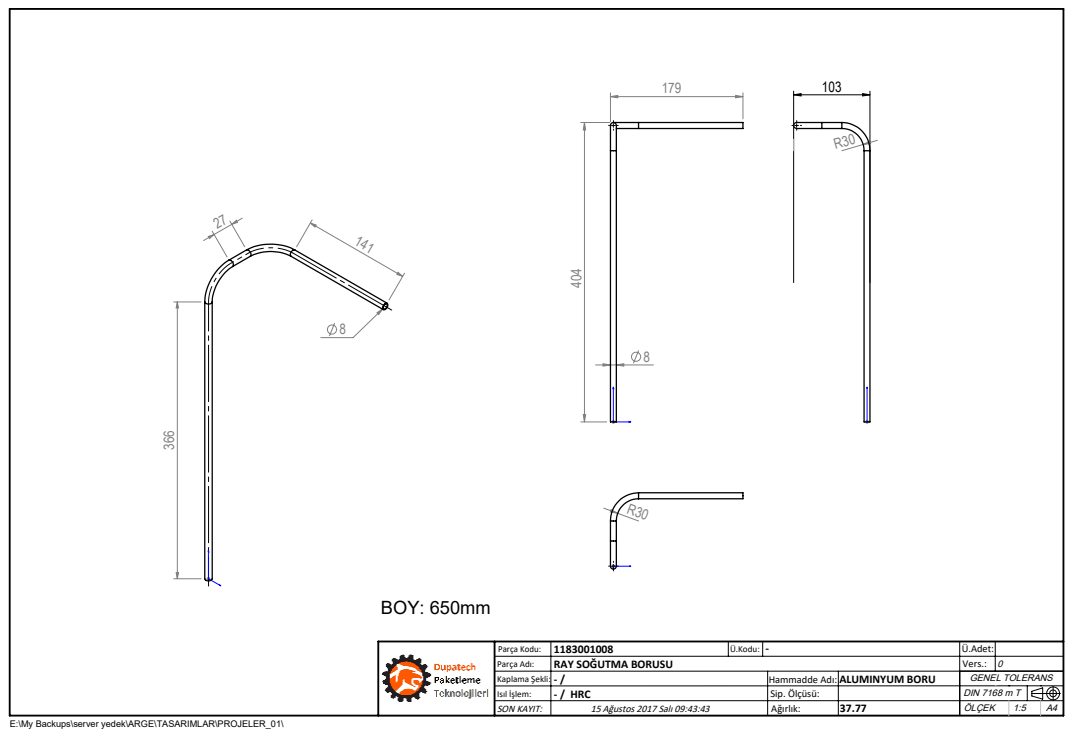
[picture p34: page 1]
BOY: 650mm

Parça Kodu: | 1183001008 | Ü.Kodu: | - | Ü.Adet:
Parça Adı: | RAY SOĞUTMA BORUSU | | | Vers.: | 0
Kaplama Şekli: - / | | Hammadde Adı: ALUMINYUM BORU | | GENEL TOLERANS
Isıl İşlem: | - / HRC | Sip. Ölçüsü: | | DIN 7168 m T
SON KAYIT: | 15 Ağustos 2017 Salı 09:43:43 | Ağırlık: | 37.77 | ÖLÇEK | 1:5 | A4

E:\My Backups\server yedek\ARGE\TASARIMLAR\PROJELER_01\
