smtzcn81/muhasebe/assets/urunler/pdf/1183001010.pdf

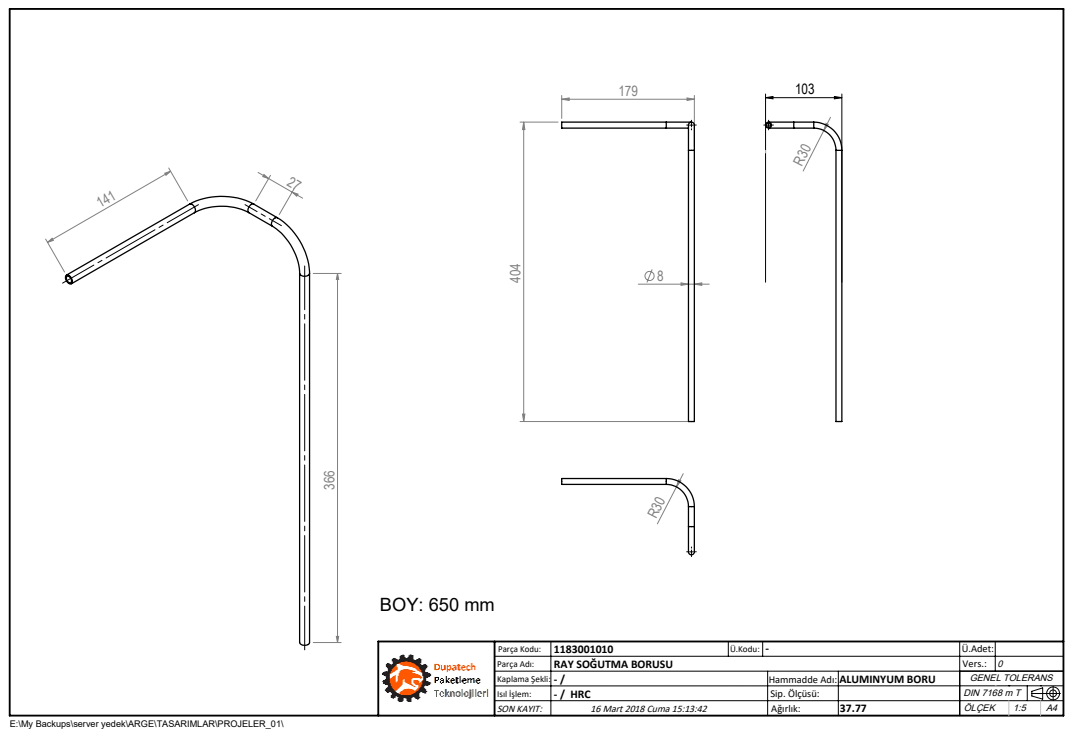
[picture p36: page 1]
BOY: 650 mm

Parça Kodu: | 1183001010 | Ü.Kodu: | - | Ü.Adet:
Parça Adı: | RAY SOĞUTMA BORUSU | | | Vers.: | 0
Kaplama Şekli: - / | | Hammadde Adı: ALUMINYUM BORU | | GENEL TOLERANS
Isıl İşlem: | - / HRC | Sip. Ölçüsü: | | DIN 7168 m T
SON KAYIT: | 16 Mart 2018 Cuma 15:13:42 | Ağırlık: | 37.77 | ÖLÇEK | 1:5 | A4

E:\My Backups\server yedek\ARGE\TASARIMLAR\PROJELER_01\
