smtzcn81/muhasebe/assets/urunler/pdf/1185003013.pdf

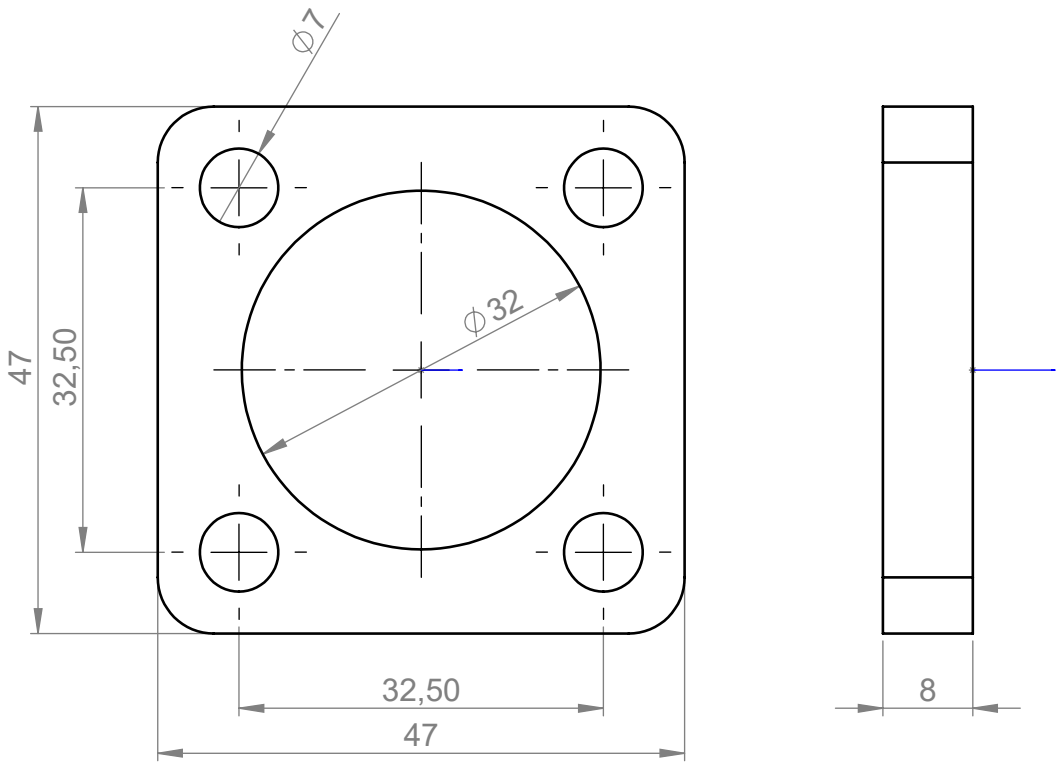
[picture p37: page 1]
Parça Kodu:; Parça Adı:; PISTON YUKSELTME SACI; SON KAYIT:; 12 Mayıs 2021 Çarşamba 18:32:26; Kaplama Şekli: FOSFAT /; Hammadde Adı: DKP SAC; Sip. Ölçüsü:; GENEL TOLERANS; DIN 7168 m T; Ü.Kodu: -; Isıl İşlem:; YOK / HRC
