smtzcn81/muhasebe/assets/urunler/pdf/1185005003.pdf

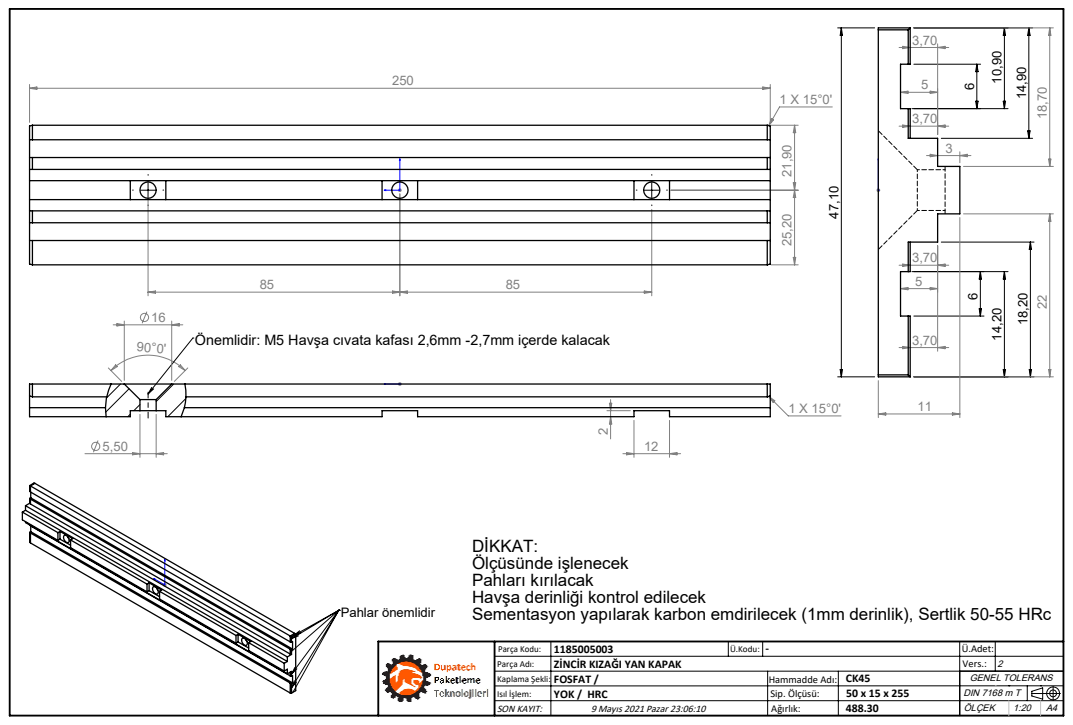
[picture p38: page 1]
Pahlar önemlidir

Önemlidir: M5 Havşa cıvata kafası 2,6mm -2,7mm içerde kalacak

DİKKAT:
Ölçüsünde işlenecek
Pahları kırılacak
Havşa derinliği kontrol edilecek
Sementasyon yapılarak karbon emdirilecek (1mm derinlik), Sertlik 50-55 HRc

Parça Kodu: | 1185005003 | Ü.Kodu: | - | Ü.Adet:
Parça Adı: | ZİNCİR KIZAĞI YAN KAPAK | | | Vers.: | 2
Kaplama Şekli: FOSFAT / | | Hammadde Adı: | CK45 | GENEL TOLERANS
Isıl İşlem: | YOK / HRC | Sip. Ölçüsü: | 50 x 15 x 255 | DIN 7168 m T
SON KAYIT: | 9 Mayıs 2021 Pazar 23:06:10 | Ağırlık: | 488.30 A4 | ÖLÇEK | 1:20
