smtzcn81/muhasebe/assets/urunler/pdf/1185005003_9SDS.pdf

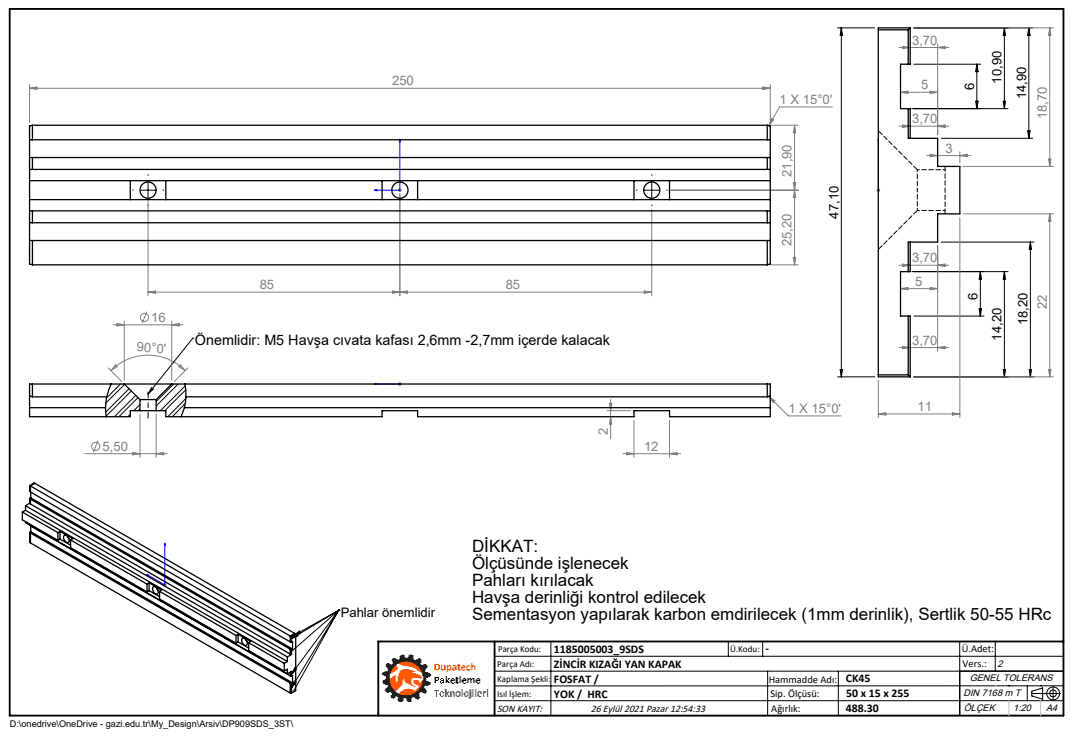
[picture p39: page 1]
Pahlar önemlidir

Önemlidir: M5 Havşa cıvata kafası 2,6mm -2,7mm içerde kalacak

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

Parça Kodu: | 1185005003_9SDS | Ü.Kodu: | - | Ü.Adet:
Parça Adı: | ZİNCİR KIZAĞI YAN KAPAK | | | Vers.: | 2
Kaplama Şekli: FOSFAT / | | Hammadde Adı: | CK45 | GENEL TOLERANS
Isıl İşlem: | YOK / HRC | Sip. Ölçüsü: | 50 x 15 x 255 | DIN 7168 m T
SON KAYIT: | 26 Eylül 2021 Pazar 12:54:33 | Ağırlık: | 488.30 A4 | ÖLÇEK | 1:20

D:\onedrive\OneDrive - gazi.edu.tr\My_Design\Arsiv\DP909SDS_3ST\
