smtzcn81/muhasebe/assets/urunler/pdf/Alt_Giydirme_Sac_Montaj.pdf

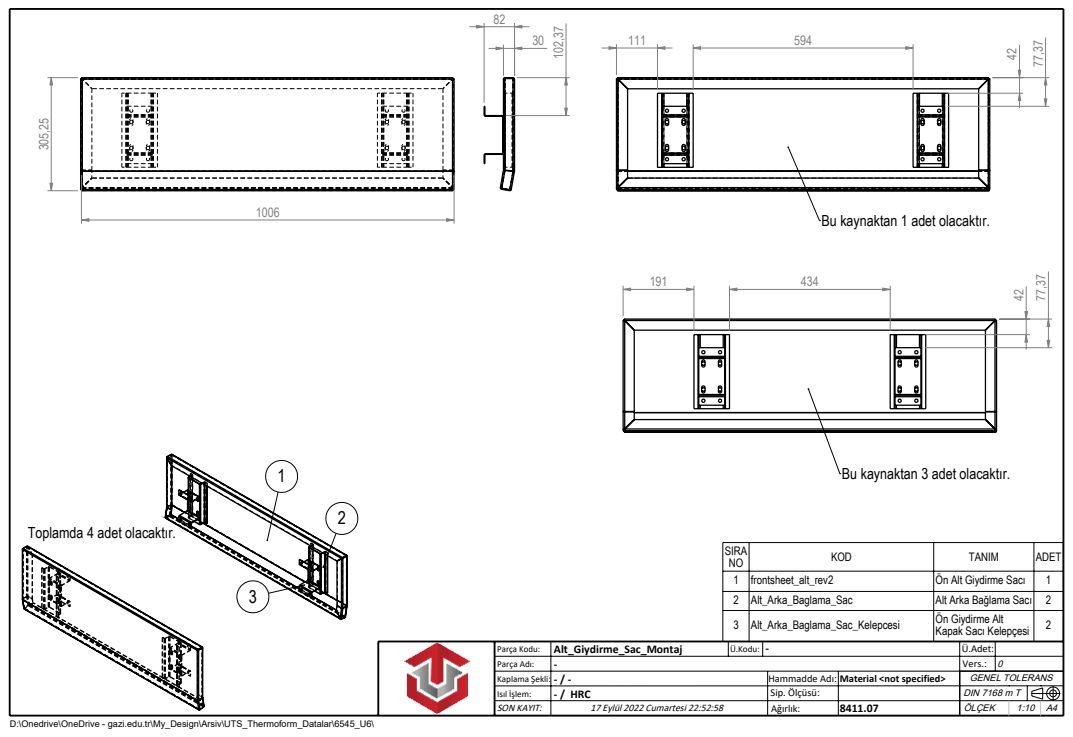
[picture p41: page 1]
SON KAYIT:; 17 Eylül 2022 Cumartesi 22:52:58; Kaplama Şekli: - / -; Hammadde Adı: Material <not specified>; Sip. Ölçüsü:; GENEL TOLERANS DIN 7168 m T; Isıl İşlem:; - / HRC

Bu kaynaktan 1 adet olacaktır.

Bu kaynaktan 3 adet olacaktır.

Toplamda 4 adet olacaktır.

SIRA NO | KOD | TANIM | ADET
1 | frontsheet_alt_rev2 | Ön Alt Giydirme Sacı | 1
2 | Alt_Arka_Baglama_Sac | Alt Arka Bağlama Sacı | 2
3 | Alt_Arka_Baglama_Sac_Kelepcesi | Ön Giydirme Alt Kapak Sacı Kelepçesi | 2

Alt_Giydirme_Sac_Montaj Ü.Kodu: -Parça Kodu: Ü.Adet: Parça Adı: -Vers.: 0

D:\Onedrive\OneDrive - gazi.edu.tr\My_Design\Arsiv\UTS_Thermoform_Datalar\6545_U6\
