smtzcn81/muhasebe/assets/urunler/pdf/1161003002.pdf

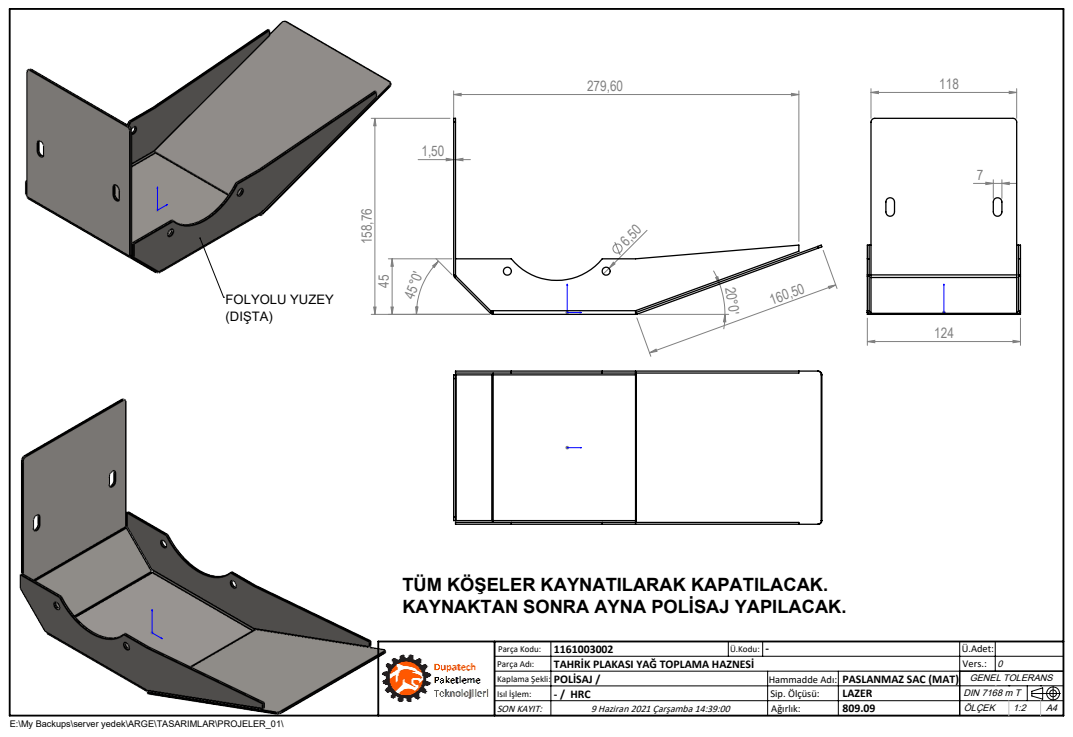
[picture p42: page 1]
FOLYOLU YUZEY

TÜM KÖŞELER KAYNATILARAK KAPATILACAK.
KAYNAKTAN SONRA AYNA POLİSAJ YAPILACAK.

Parça Kodu: | 1161003002 | Ü.Kodu: | - | Ü.Adet:
Parça Adı: | TAHRİK PLAKASI YAĞ TOPLAMA HAZNESİ | | | Vers.: | 0
Kaplama Şekli: POLİSAJ / | | Hammadde Adı: | PASLANMAZ SAC (MAT) | GENEL TOLERANS
Isıl İşlem: | - / HRC | Sip. Ölçüsü: | LAZER | DIN 7168 m T
SON KAYIT: | 9 Haziran 2021 Çarşamba 14:39:00 | Ağırlık: | 809.09 A4 | ÖLÇEK | 1:2

E:\My Backups\server yedek\ARGE\TASARIMLAR\PROJELER_01\
