smtzcn81/muhasebe/assets/urunler/pdf/1182022002.pdf

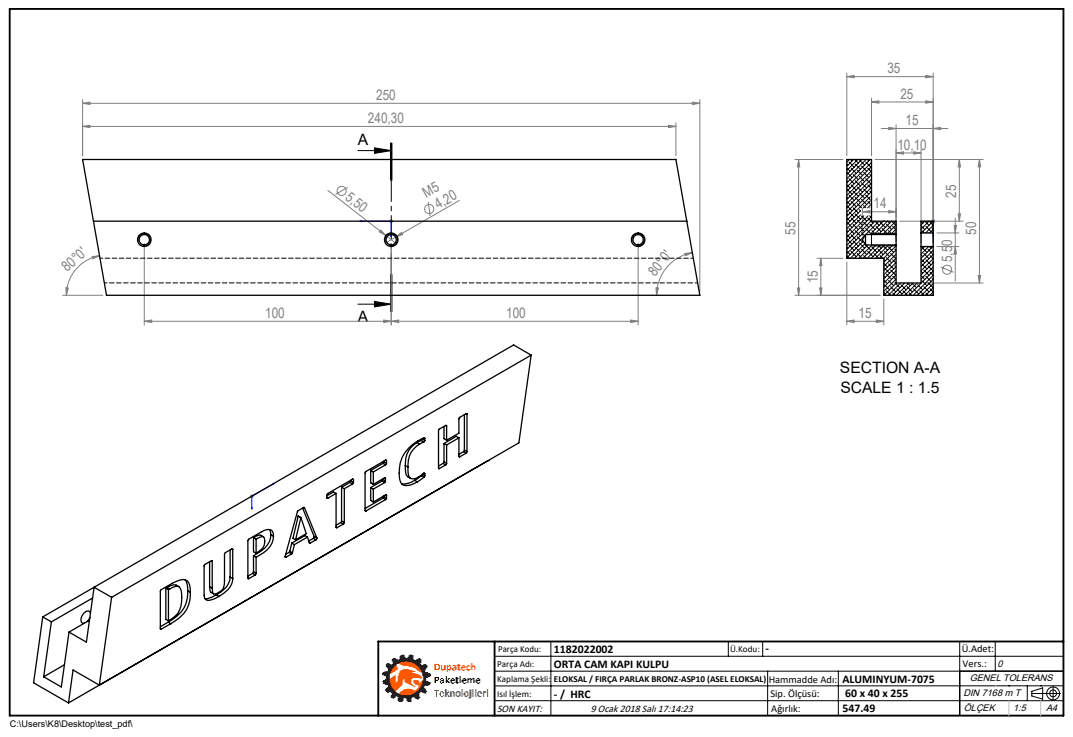
[picture p43: page 1]
SECTION A-A SCALE 1 : 1.5

Parça Kodu: | 1182022002 | Ü.Kodu: | - | Ü.Adet:
Parça Adı: | ORTA CAM KAPI KULPU | | | Vers.: | 0
Kaplama Şekli: ELOKSAL / FIRÇA PARLAK BRONZ-ASP10 (ASEL ELOKSAL) Hammadde Adı: | | | ALUMINYUM-7075 | GENEL TOLERANS
Isıl İşlem: | - / HRC | Sip. Ölçüsü: | 60 x 40 x 255 | DIN 7168 m T
SON KAYIT: | 9 Ocak 2018 Salı 17:14:23 | Ağırlık: | 547.49 A4 | ÖLÇEK | 1:5
