smtzcn81/muhasebe/assets/urunler/pdf/1183004001.pdf

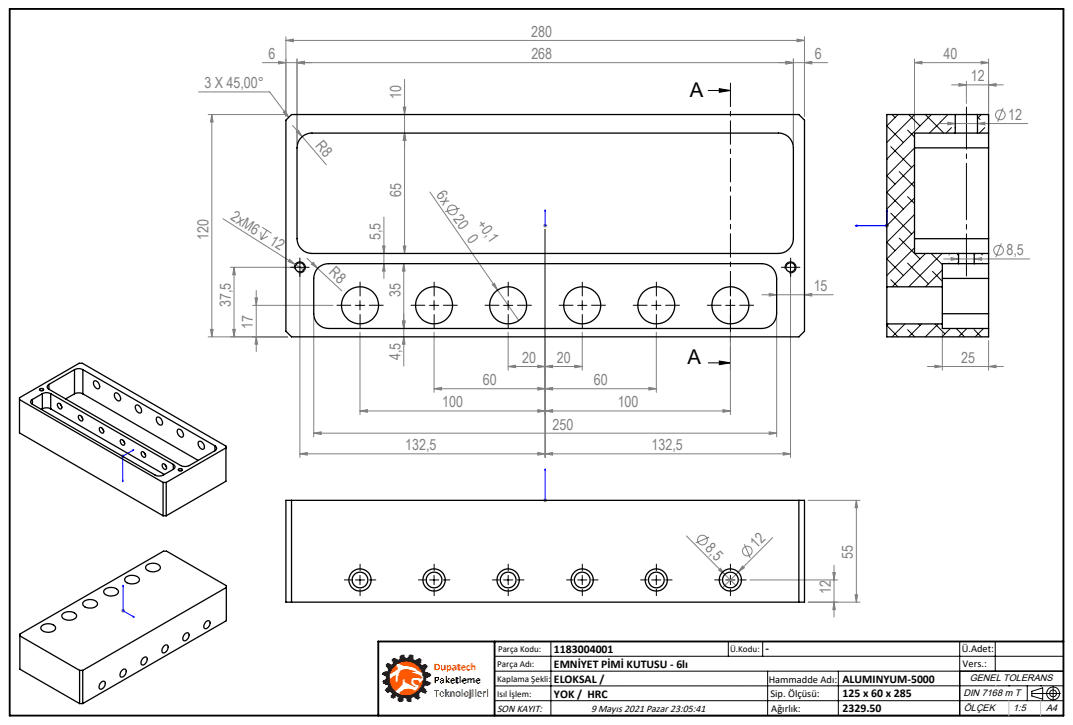
[picture p44: page 1]
Parça Kodu:; Parça Adı:; EMNİYET PİMİ KUTUSU - 6lı; SON KAYIT:; 9 Mayıs 2021 Pazar 23:05:41; Kaplama Şekli: ELOKSAL /; Hammadde Adı: ALUMINYUM-5000; Sip. Ölçüsü:; GENEL TOLERANS; DIN 7168 m T; Ü.Kodu: -; Isıl İşlem:; YOK / HRC
