smtzcn81/muhasebe/assets/urunler/pdf/1183004002.pdf

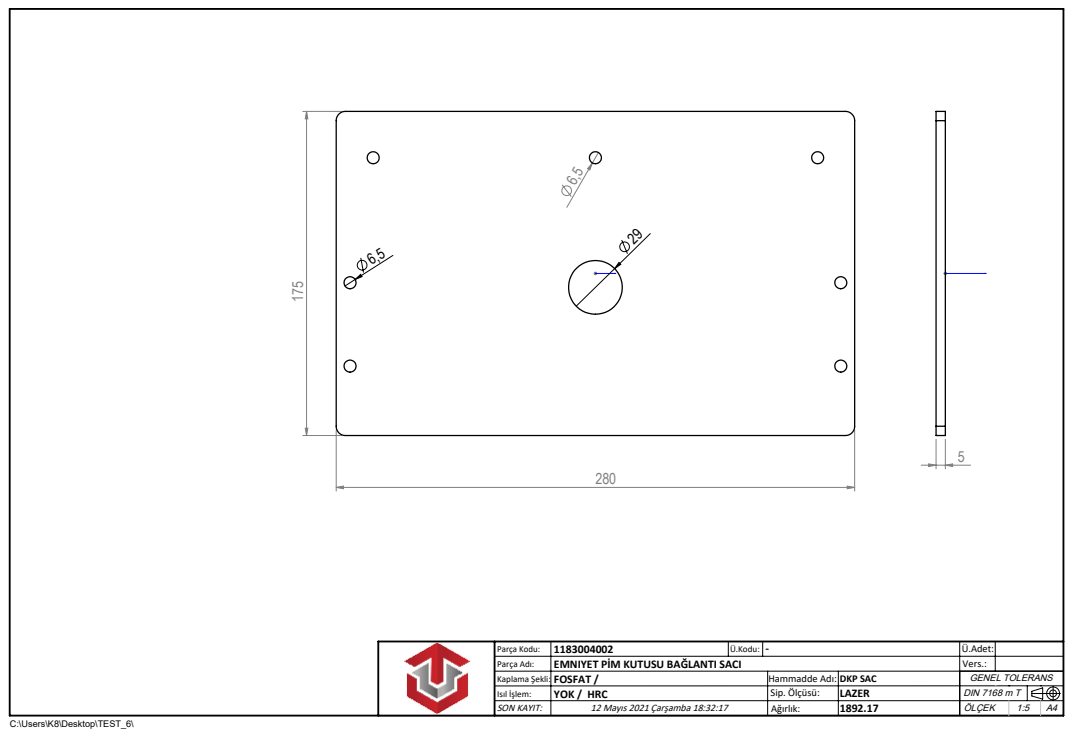
[picture p45: page 1]
Parça Kodu:; Parça Adı:; EMNIYET PİM KUTUSU BAĞLANTI SACI; SON KAYIT:; 12 Mayıs 2021 Çarşamba 18:32:17; Kaplama Şekli: FOSFAT /; Hammadde Adı: DKP SAC; Sip. Ölçüsü:; GENEL TOLERANS; DIN 7168 m T; Ü.Kodu: -; Isıl İşlem:; YOK / HRC
