smtzcn81/muhasebe/assets/urunler/pdf/1184001003.pdf

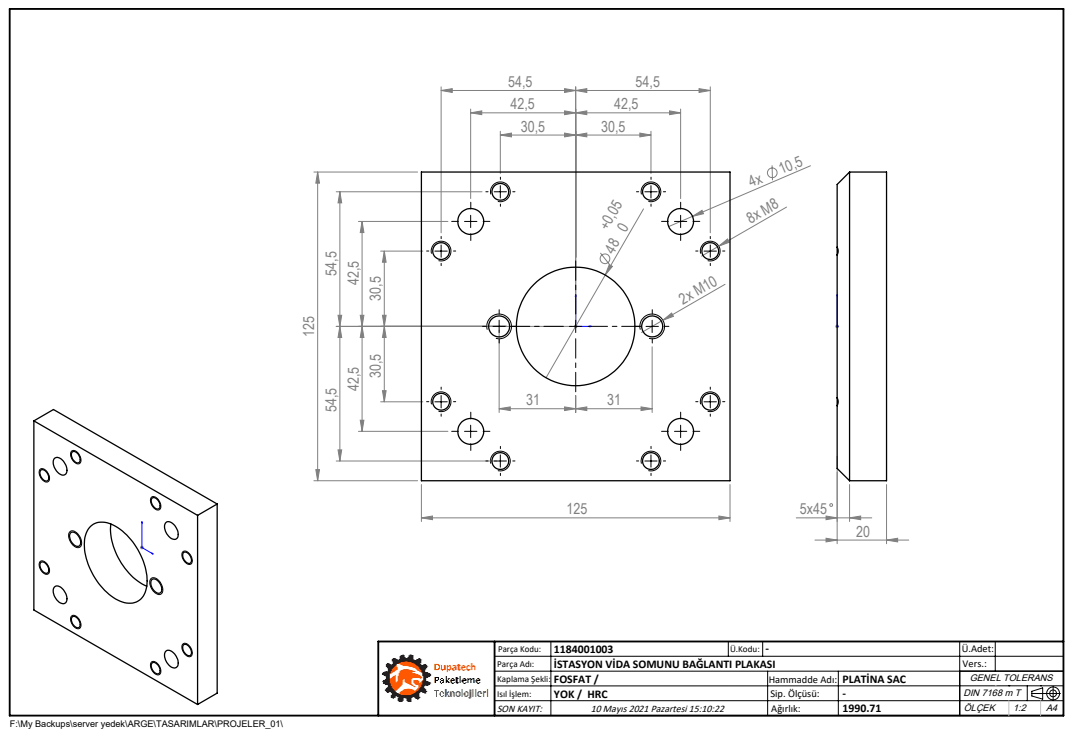
[picture p46: page 1]
Parça Kodu:; Parça Adı:; İSTASYON VİDA SOMUNU BAĞLANTI PLAKASI; SON KAYIT:; 10 Mayıs 2021 Pazartesi 15:10:22; Kaplama Şekli: FOSFAT /; Hammadde Adı: PLATİNA SAC; Sip. Ölçüsü:; GENEL TOLERANS; DIN 7168 m T; Ü.Kodu: -; Isıl İşlem:; YOK / HRC

42,5 | 42,5
30,5 | 30,5

F:\My Backups\server yedek\ARGE\TASARIMLAR\PROJELER_01\
