smtzcn81/muhasebe/assets/urunler/pdf/1185001003.pdf

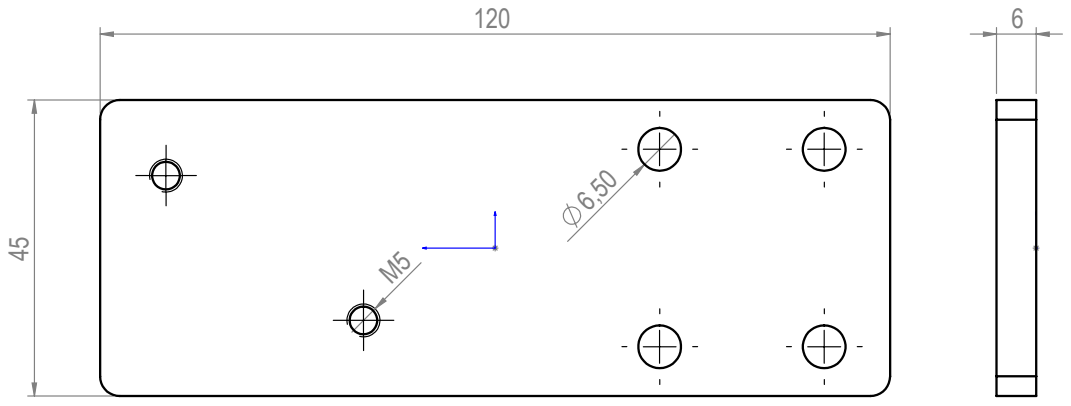
[picture p47: page 1]
Parça Kodu:; Parça Adı:; TAVA HAREKET VALFİ BAĞLAMA SACI; SON KAYIT:; 12 Mayıs 2021 Çarşamba 18:32:23; Kaplama Şekli: FOSFAT / -; Hammadde Adı: DKP SAC; Sip. Ölçüsü:; GENEL TOLERANS; DIN 7168 m T; Ü.Kodu: -; Vers.: 0; Isıl İşlem:; - / HRC
