smtzcn81/muhasebe/assets/urunler/pdf/1185003001.pdf

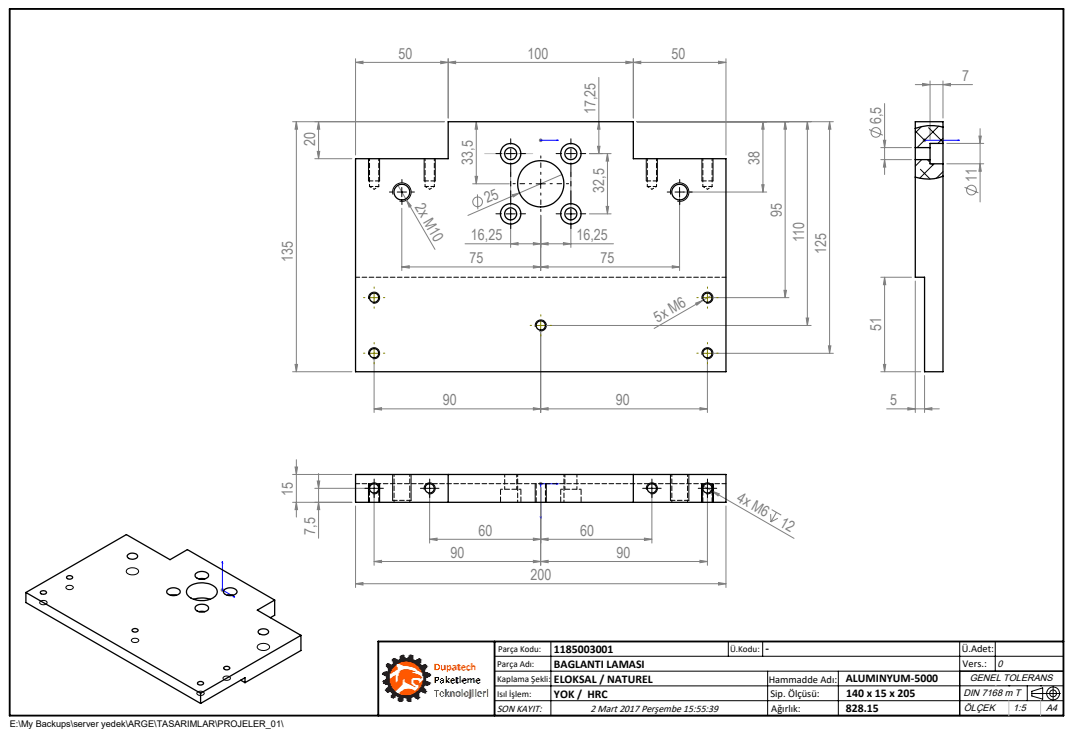
[picture p48: page 1]
Parça Kodu:; Parça Adı:; BAGLANTI LAMASI; SON KAYIT:; 2 Mart 2017 Perşembe 15:55:39; Kaplama Şekli: ELOKSAL / NATUREL; Hammadde Adı: ALUMINYUM-5000; Sip. Ölçüsü:; GENEL TOLERANS; DIN 7168 m T; Ü.Kodu: -; Vers.: 0; Isıl İşlem:; YOK / HRC

E:\My Backups\server yedek\ARGE\TASARIMLAR\PROJELER_01\
