smtzcn81/muhasebe/assets/urunler/pdf/1185003001_9SDS.pdf

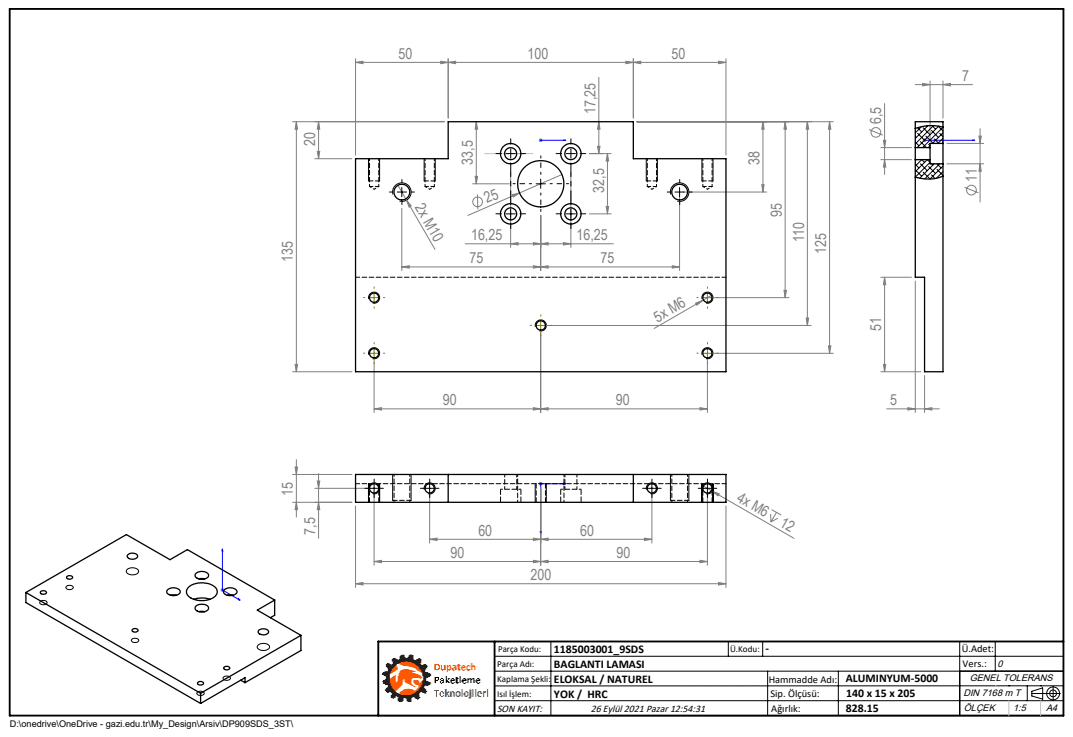
[picture p49: page 1]
Parça Kodu:; Parça Adı:; BAGLANTI LAMASI; SON KAYIT:; 26 Eylül 2021 Pazar 12:54:31; Kaplama Şekli: ELOKSAL / NATUREL; Hammadde Adı: ALUMINYUM-5000; Sip. Ölçüsü:; GENEL TOLERANS; DIN 7168 m T; 1185003001_9SDS; Ü.Kodu: -; Vers.: 0; Isıl İşlem:; YOK / HRC

D:\onedrive\OneDrive - gazi.edu.tr\My_Design\Arsiv\DP909SDS_3ST\
