smtzcn81/muhasebe/assets/urunler/pdf/1185003002.pdf

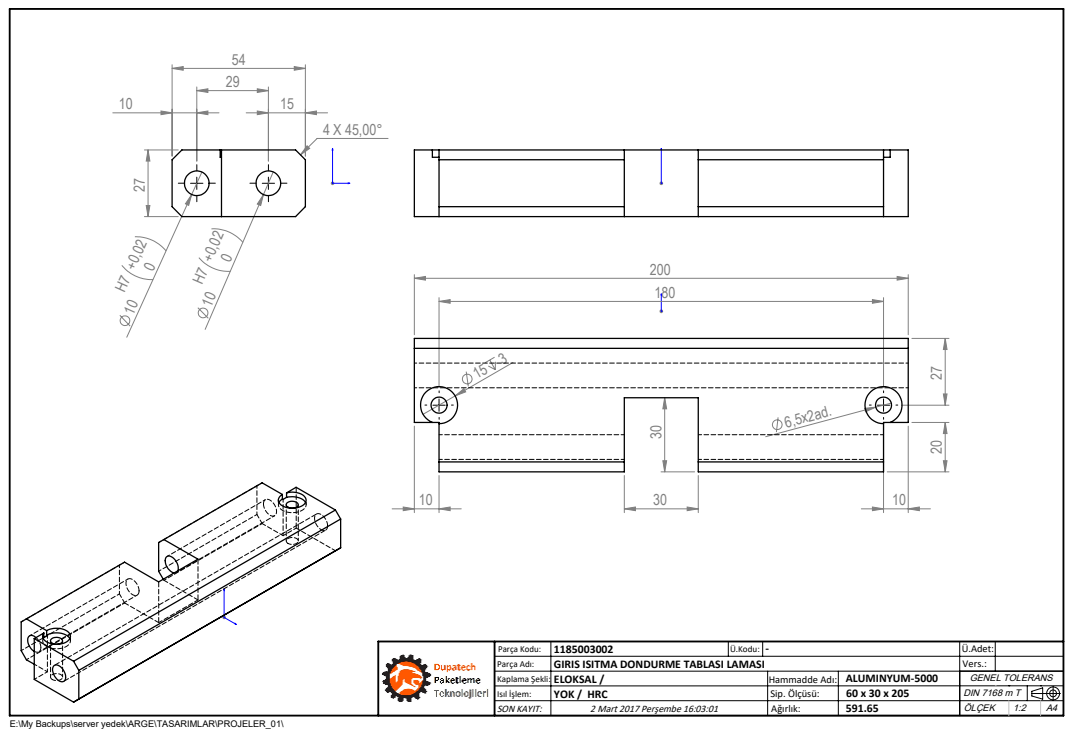
[picture p50: page 1]
Parça Kodu:; Parça Adı:; GIRIS ISITMA DONDURME TABLASI LAMASI; SON KAYIT:; 2 Mart 2017 Perşembe 16:03:01; Kaplama Şekli: ELOKSAL /; Hammadde Adı: ALUMINYUM-5000; Sip. Ölçüsü:; GENEL TOLERANS; DIN 7168 m T; Ü.Kodu: -; Isıl İşlem:; YOK / HRC

E:\My Backups\server yedek\ARGE\TASARIMLAR\PROJELER_01\
