smtzcn81/muhasebe/assets/urunler/pdf/1185003003.pdf

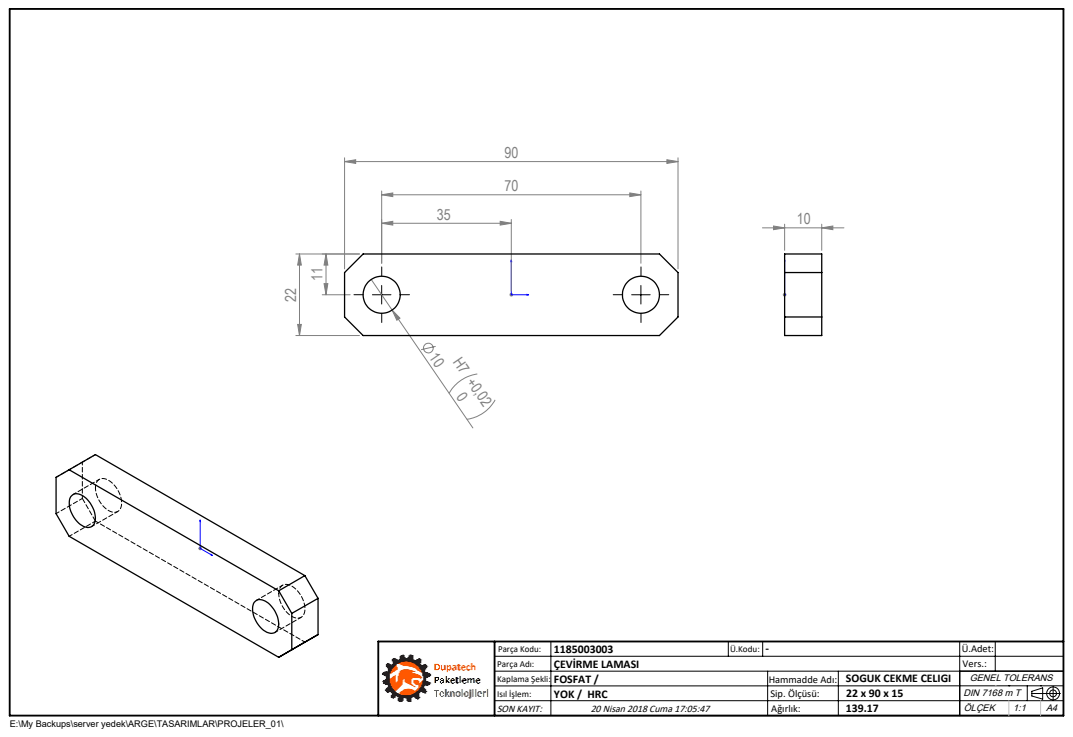
[picture p52: page 1]
Parça Kodu:; Parça Adı:; ÇEVİRME LAMASI; SON KAYIT:; 20 Nisan 2018 Cuma 17:05:47; Kaplama Şekli: FOSFAT /; Hammadde Adı: SOGUK CEKME CELIGI; Sip. Ölçüsü:; GENEL TOLERANS; DIN 7168 m T; Ü.Kodu: -; Isıl İşlem:; YOK / HRC

E:\My Backups\server yedek\ARGE\TASARIMLAR\PROJELER_01\
