smtzcn81/muhasebe/assets/urunler/pdf/1185003003_9SDS.pdf

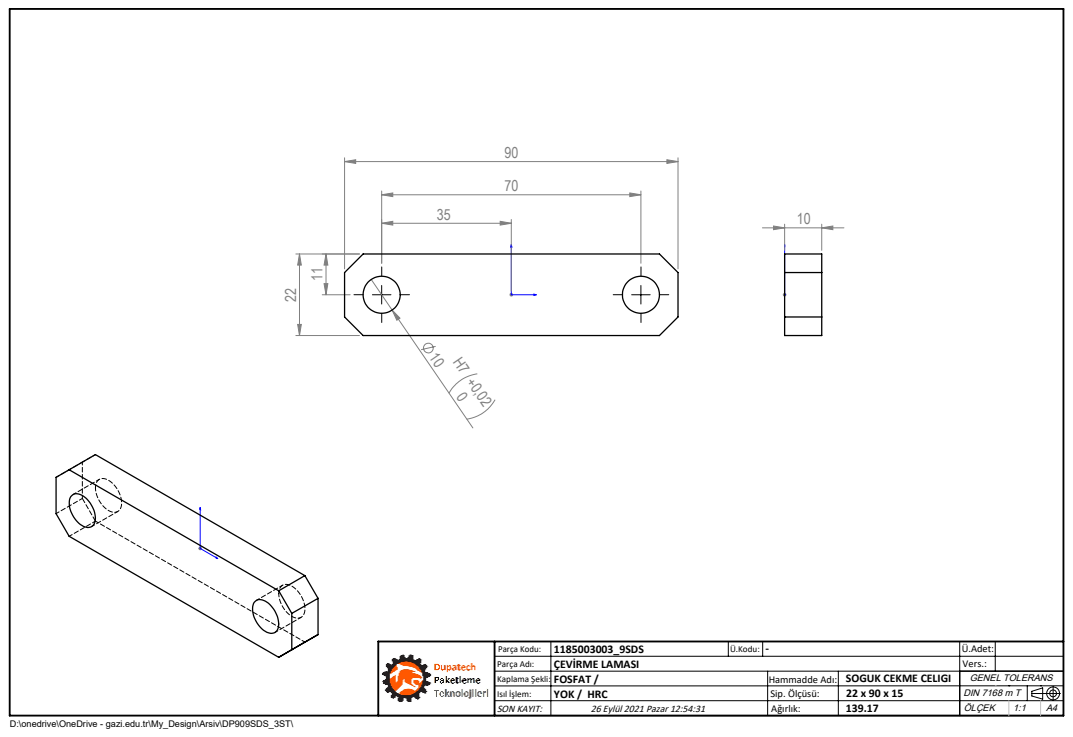
[picture p53: page 1]
Parça Kodu:; Parça Adı:; ÇEVİRME LAMASI; SON KAYIT:; 26 Eylül 2021 Pazar 12:54:31; Kaplama Şekli: FOSFAT /; Hammadde Adı: SOGUK CEKME CELIGI; Sip. Ölçüsü:; GENEL TOLERANS; DIN 7168 m T; 1185003003_9SDS; Ü.Kodu: -; Isıl İşlem:; YOK / HRC

D:\onedrive\OneDrive - gazi.edu.tr\My_Design\Arsiv\DP909SDS_3ST\
