smtzcn81/muhasebe/assets/urunler/pdf/1185003004.pdf

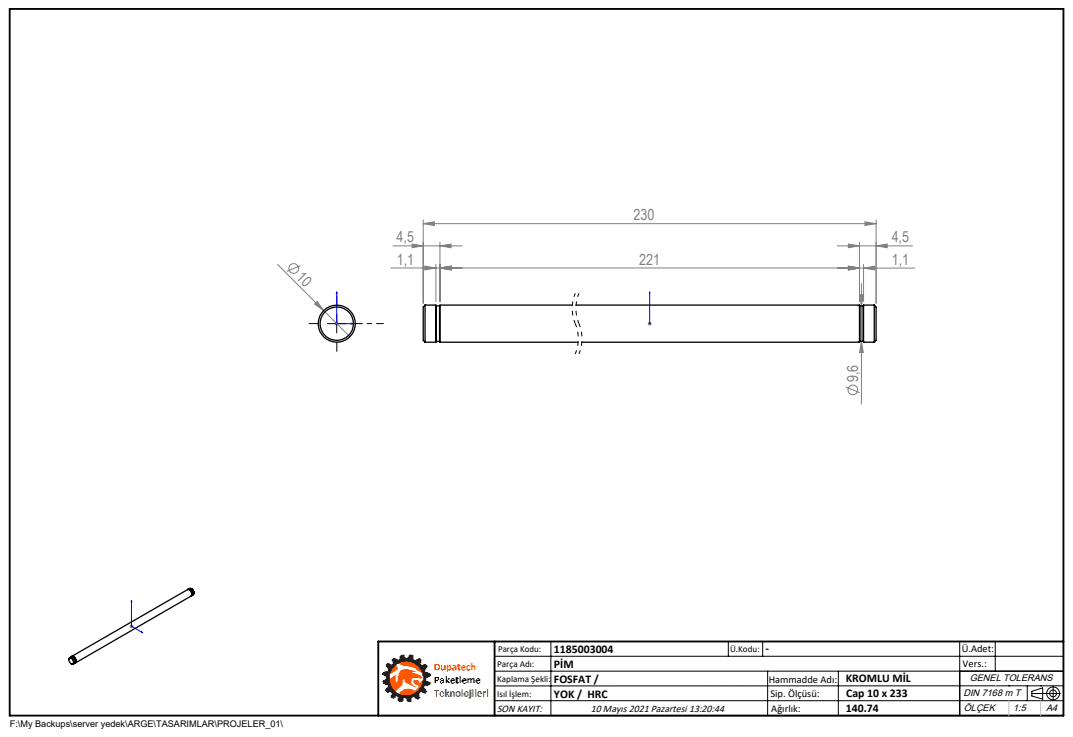
[picture p54: page 1]
Parça Kodu:; Parça Adı:; PİM; SON KAYIT:; 10 Mayıs 2021 Pazartesi 13:20:44; Kaplama Şekli: FOSFAT /; Hammadde Adı: KROMLU MİL; Sip. Ölçüsü:; GENEL TOLERANS; Cap 10 x 233 140.74 A4; DIN 7168 m T; Ü.Kodu: -; Isıl İşlem:; YOK / HRC

F:\My Backups\server yedek\ARGE\TASARIMLAR\PROJELER_01\
