smtzcn81/muhasebe/assets/urunler/pdf/1185003005.pdf

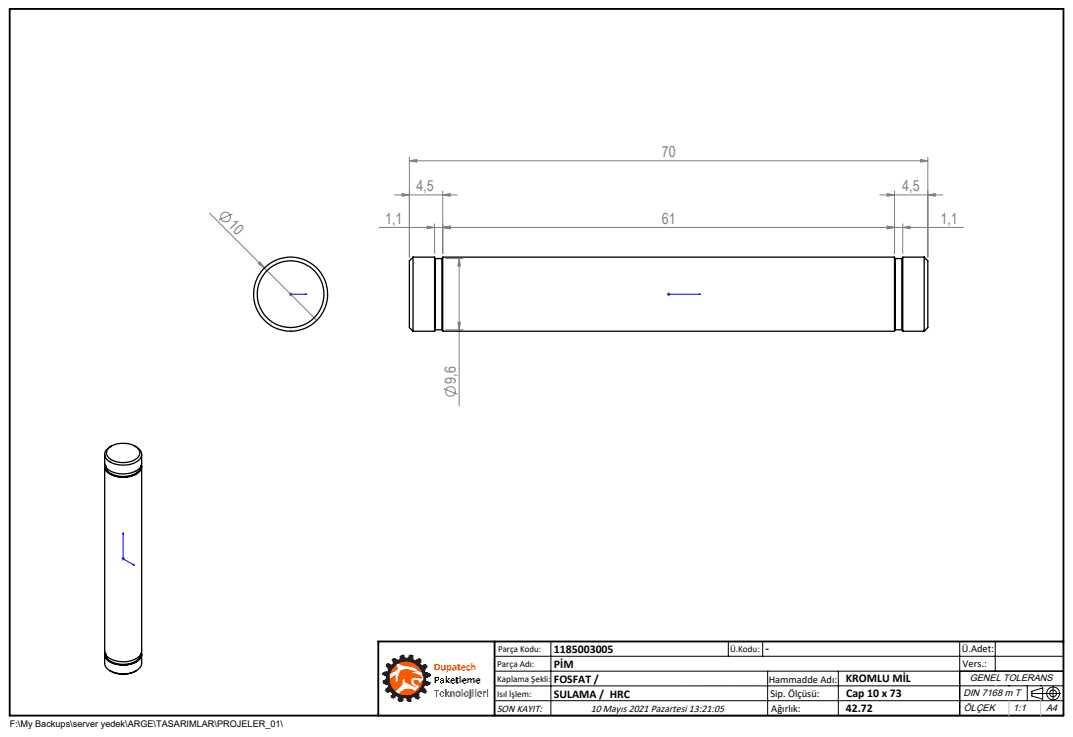
[picture p55: page 1]
Parça Kodu:; Parça Adı:; PİM; SON KAYIT:; 10 Mayıs 2021 Pazartesi 13:21:05; Kaplama Şekli: FOSFAT /; Hammadde Adı: KROMLU MİL; Sip. Ölçüsü:; GENEL TOLERANS; Cap 10 x 73 42.72 A4; DIN 7168 m T; Ü.Kodu: -; Isıl İşlem:; SULAMA / HRC

F:\My Backups\server yedek\ARGE\TASARIMLAR\PROJELER_01\

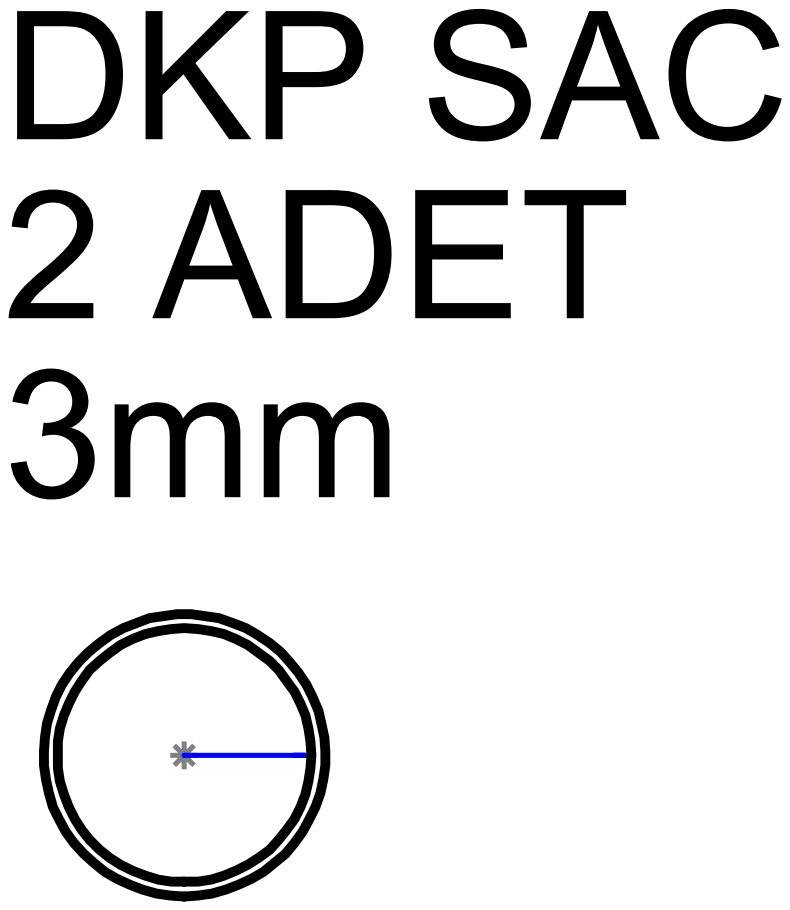
[picture p56: page 2]
DKP SAC 2 ADET
