smtzcn81/muhasebe/assets/urunler/pdf/1185003006.pdf

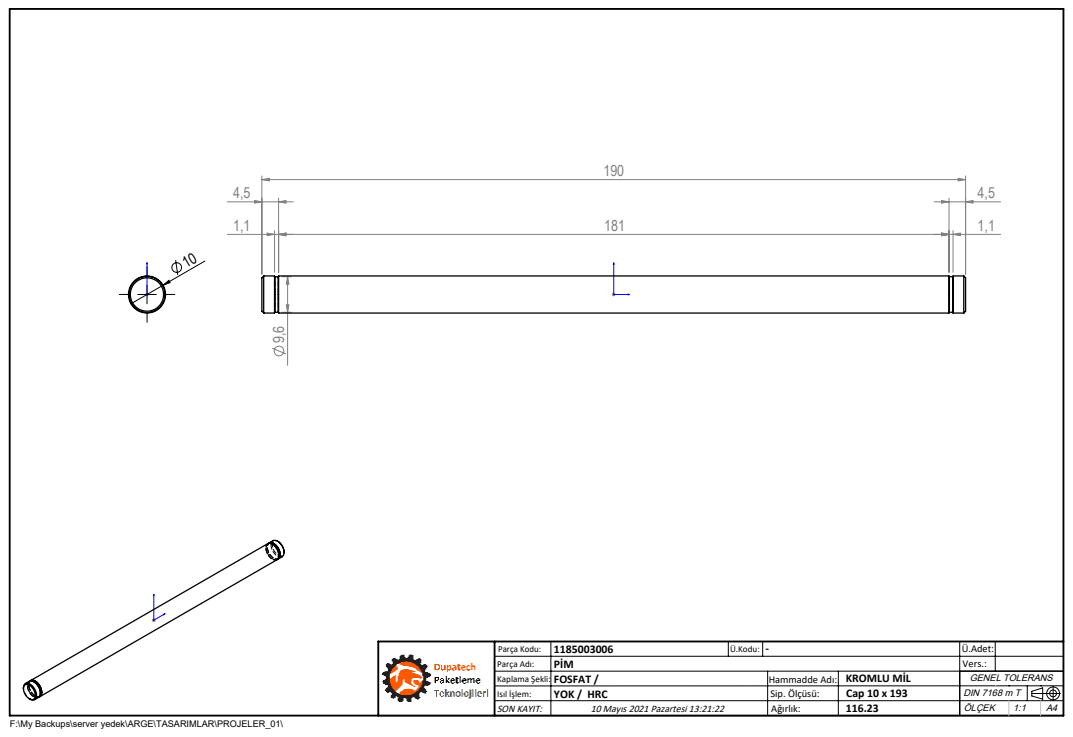
[picture p57: page 1]
Parça Kodu:; Parça Adı:; PİM; SON KAYIT:; 10 Mayıs 2021 Pazartesi 13:21:22; Kaplama Şekli: FOSFAT /; Hammadde Adı: KROMLU MİL; Sip. Ölçüsü:; GENEL TOLERANS; Cap 10 x 193 116.23 A4; DIN 7168 m T; Ü.Kodu: -; Isıl İşlem:; YOK / HRC

F:\My Backups\server yedek\ARGE\TASARIMLAR\PROJELER_01\
