smtzcn81/muhasebe/assets/urunler/pdf/1185003007.pdf

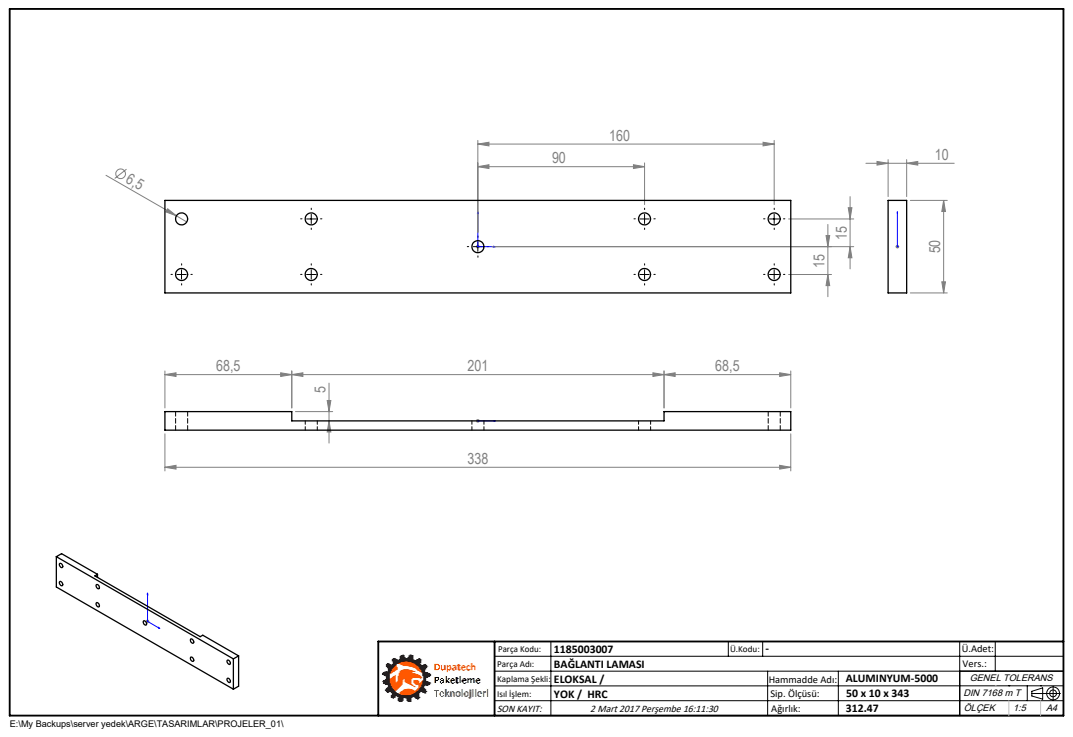
[picture p58: page 1]
Parça Kodu:; Parça Adı:; BAĞLANTI LAMASI; SON KAYIT:; 2 Mart 2017 Perşembe 16:11:30; Kaplama Şekli: ELOKSAL /; Hammadde Adı: ALUMINYUM-5000; Sip. Ölçüsü:; GENEL TOLERANS; DIN 7168 m T; Ü.Kodu: -; Isıl İşlem:; YOK / HRC

E:\My Backups\server yedek\ARGE\TASARIMLAR\PROJELER_01\
