smtzcn81/muhasebe/assets/urunler/pdf/1185003008.pdf

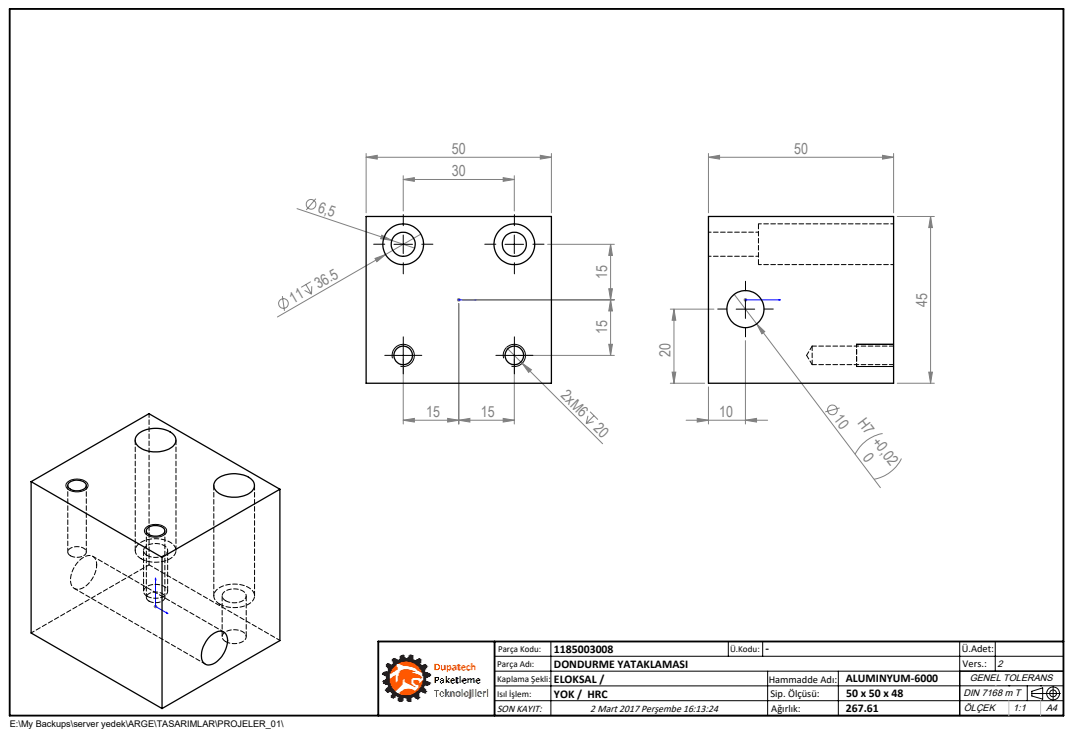
[picture p59: page 1]
Parça Kodu:; Parça Adı:; DONDURME YATAKLAMASI; SON KAYIT:; 2 Mart 2017 Perşembe 16:13:24; Kaplama Şekli: ELOKSAL /; Hammadde Adı: ALUMINYUM-6000; Sip. Ölçüsü:; GENEL TOLERANS; DIN 7168 m T; Ü.Kodu: -; Vers.: 2; Isıl İşlem:; YOK / HRC

E:\My Backups\server yedek\ARGE\TASARIMLAR\PROJELER_01\
