smtzcn81/muhasebe/assets/urunler/pdf/1185003009.pdf

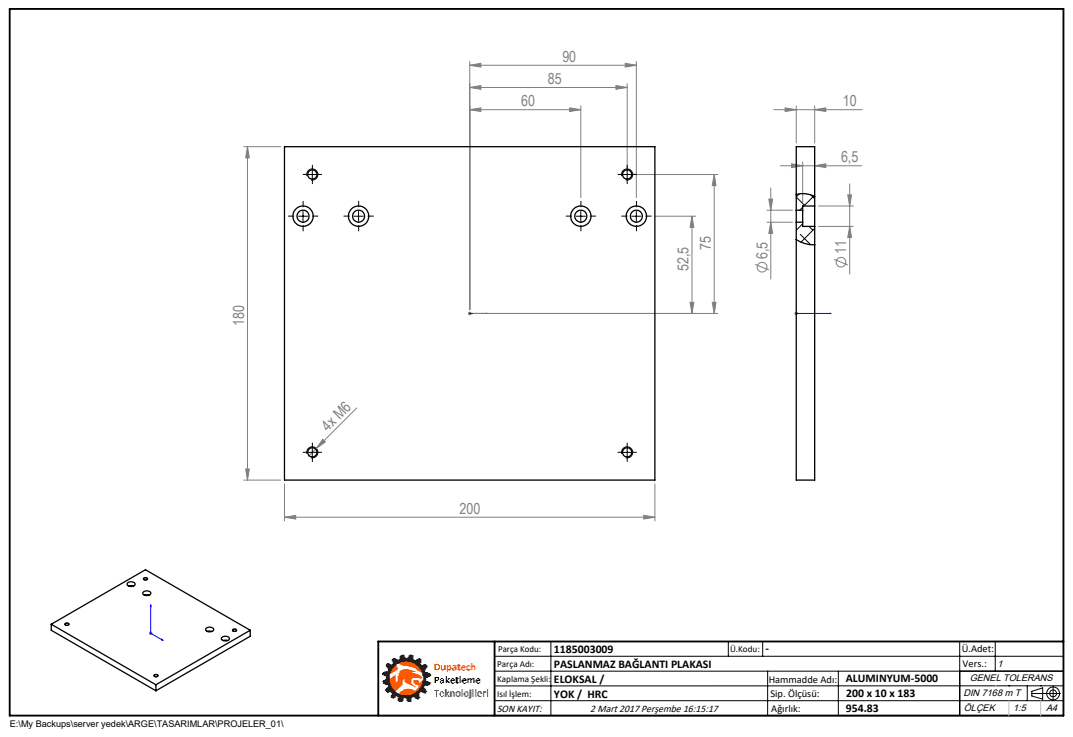
[picture p60: page 1]
Parça Kodu:; Parça Adı:; PASLANMAZ BAĞLANTI PLAKASI; SON KAYIT:; 2 Mart 2017 Perşembe 16:15:17; Kaplama Şekli: ELOKSAL /; Hammadde Adı: ALUMINYUM-5000; Sip. Ölçüsü:; GENEL TOLERANS; DIN 7168 m T; Ü.Kodu: -; Vers.: 1; Isıl İşlem:; YOK / HRC

E:\My Backups\server yedek\ARGE\TASARIMLAR\PROJELER_01\
