smtzcn81/muhasebe/assets/urunler/pdf/1185004007.pdf

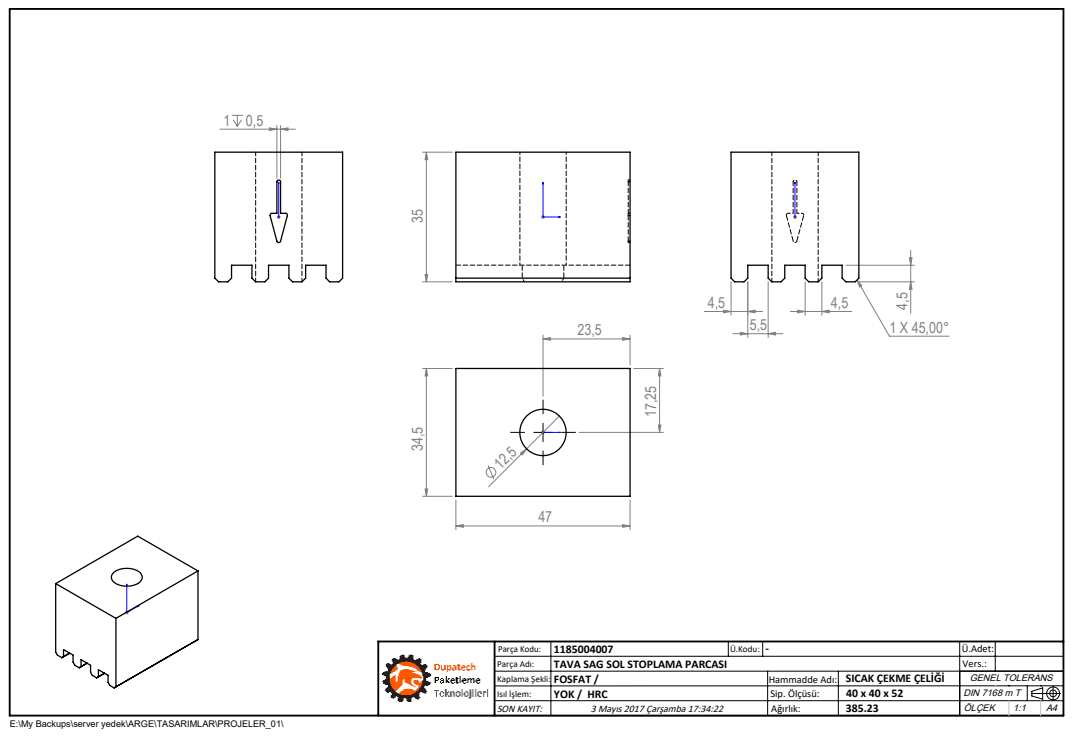
[picture p61: page 1]
Parça Kodu:; Parça Adı:; TAVA SAG SOL STOPLAMA PARCASI; SON KAYIT:; 3 Mayıs 2017 Çarşamba 17:34:22; Kaplama Şekli: FOSFAT /; Hammadde Adı: SICAK ÇEKME ÇELİĞİ; Sip. Ölçüsü:; GENEL TOLERANS; DIN 7168 m T; Ü.Kodu: -; Isıl İşlem:; YOK / HRC

E:\My Backups\server yedek\ARGE\TASARIMLAR\PROJELER_01\
