smtzcn81/muhasebe/assets/urunler/pdf/1185004008.pdf

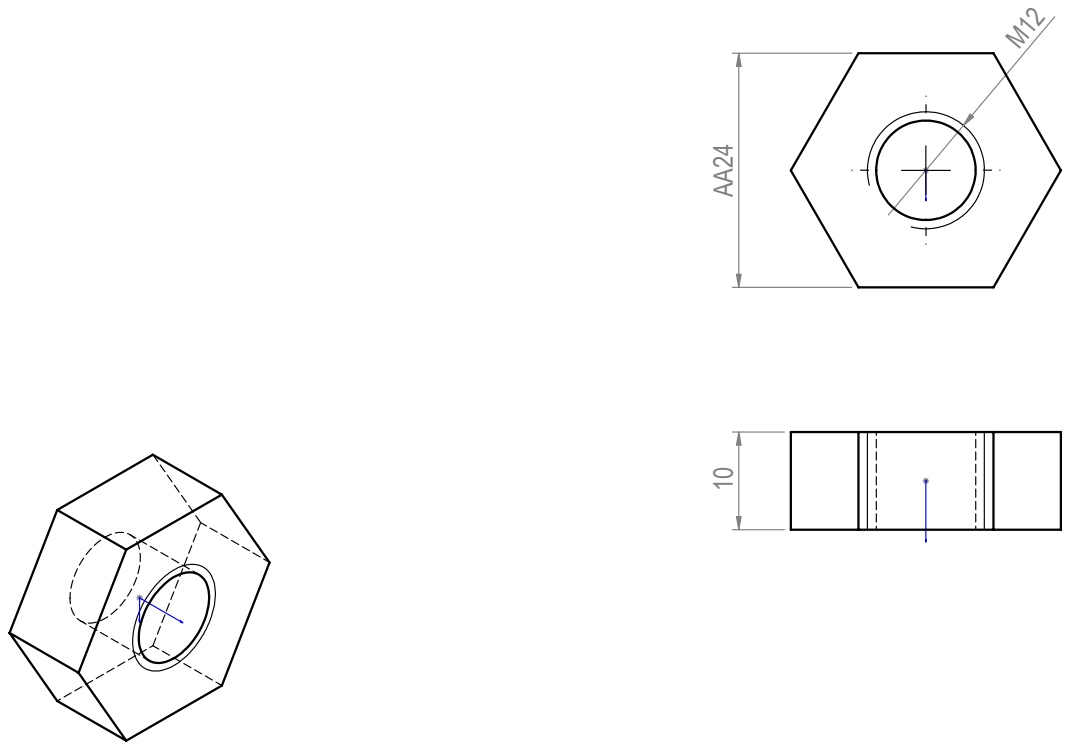
[picture p62: page 1]
Parça Kodu:; Parça Adı:; TAVA SAĞ SOL STOPLAMA SOMUNU; SON KAYIT:; 2 Mart 2017 Perşembe 10:04:26; Kaplama Şekli: FOSFAT /; Hammadde Adı: OTOMAT ÇELİĞİ; Sip. Ölçüsü:; GENEL TOLERANS; DIN 7168 m T; Ü.Kodu: -; Isıl İşlem:; YOK / HRC

E:\My Backups\server yedek\ARGE\TASARIMLAR\PROJELER_01\
