smtzcn81/muhasebe/assets/urunler/pdf/1185005004.pdf

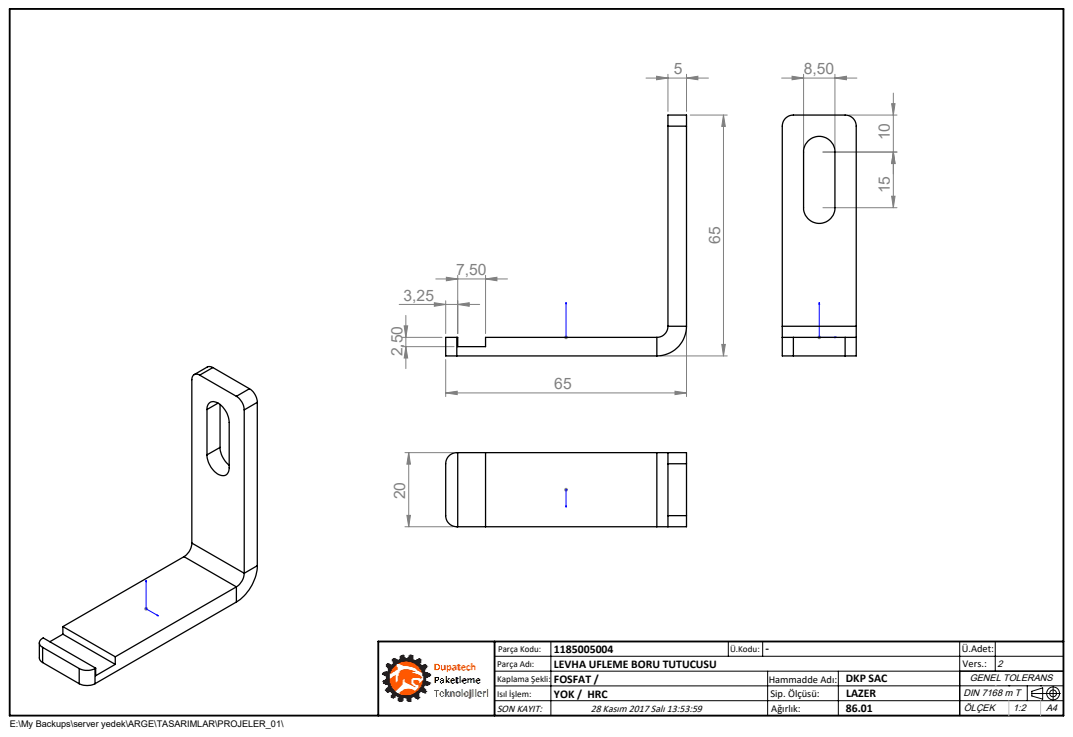
[picture p63: page 1]
Parça Kodu:; Parça Adı:; LEVHA UFLEME BORU TUTUCUSU; SON KAYIT:; 28 Kasım 2017 Salı 13:53:59; Kaplama Şekli: FOSFAT /; Hammadde Adı: DKP SAC; Sip. Ölçüsü:; GENEL TOLERANS; DIN 7168 m T; Ü.Kodu: -; Vers.: 2; Isıl İşlem:; YOK / HRC

E:\My Backups\server yedek\ARGE\TASARIMLAR\PROJELER_01\
