smtzcn81/muhasebe/assets/urunler/pdf/1185005009.pdf

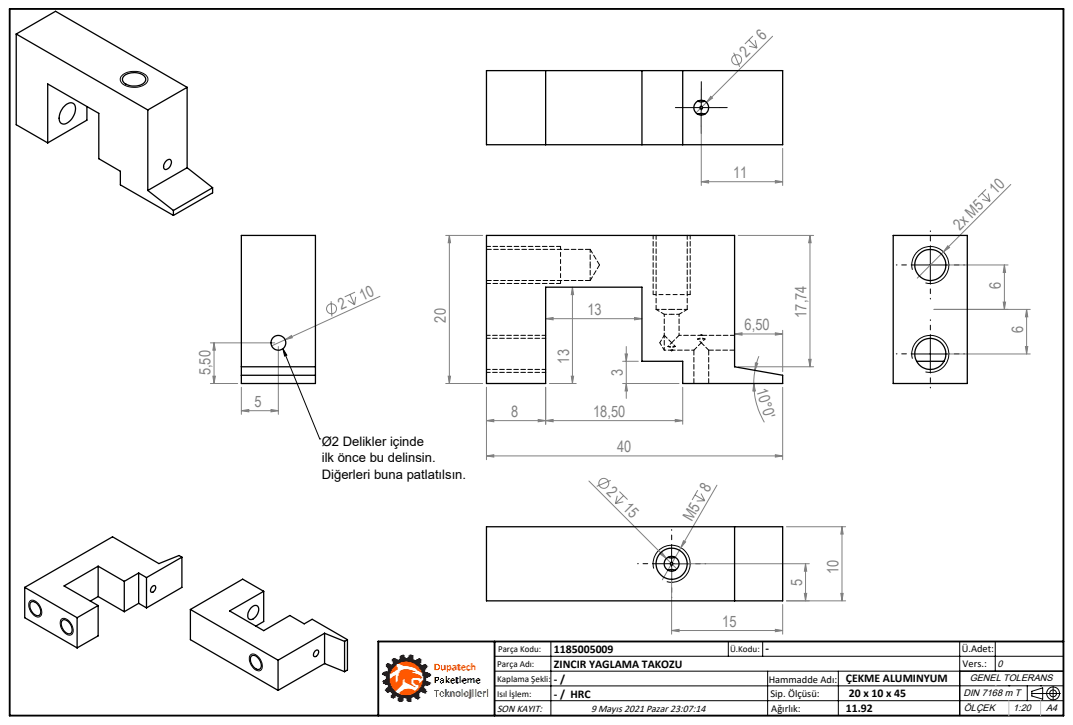
[picture p64: page 1]

Ø2 Delikler içinde
ilk önce bu delinsin.
Diğerleri buna patlatılsın.

Parça Kodu: | 1185005009 | Ü.Kodu: | - | Ü.Adet:
Parça Adı: | ZINCIR YAGLAMA TAKOZU | | | Vers.: | 0
Kaplama Şekli: - / | | Hammadde Adı: | ÇEKME ALUMINYUM | GENEL TOLERANS
Isıl İşlem: | - / HRC | Sip. Ölçüsü: | 20 x 10 x 45 | DIN 7168 m T
SON KAYIT: | 9 Mayıs 2021 Pazar 23:07:14 | Ağırlık: | 11.92 A4 | ÖLÇEK | 1:20
