smtzcn81/muhasebe/assets/urunler/pdf/1185005009_9SDS.pdf

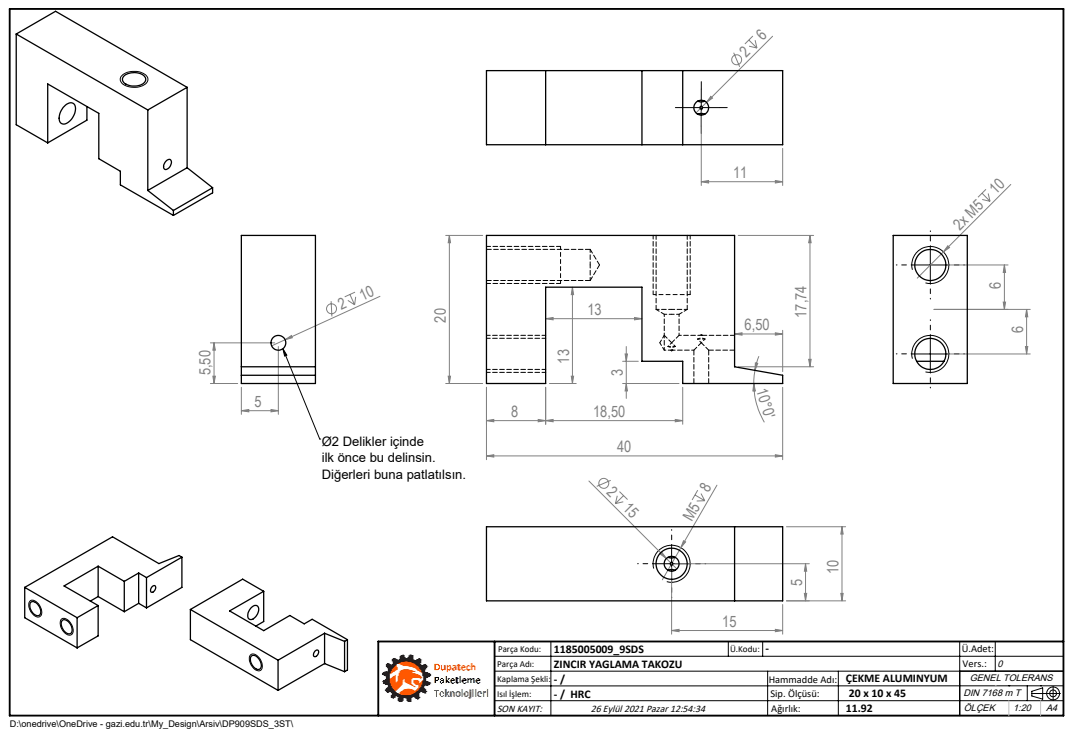
[picture p65: page 1]

Ø2 Delikler içinde
ilk önce bu delinsin.
Diğerleri buna patlatılsın.

Parça Kodu: | 1185005009_9SDS | Ü.Kodu: | - | Ü.Adet:
Parça Adı: | ZINCIR YAGLAMA TAKOZU | | | Vers.: | 0
Kaplama Şekli: - / | | Hammadde Adı: | ÇEKME ALUMINYUM | GENEL TOLERANS
Isıl İşlem: | - / HRC | Sip. Ölçüsü: | 20 x 10 x 45 | DIN 7168 m T
SON KAYIT: | 26 Eylül 2021 Pazar 12:54:34 | Ağırlık: | 11.92 A4 | ÖLÇEK | 1:20

D:\onedrive\OneDrive - gazi.edu.tr\My_Design\Arsiv\DP909SDS_3ST\
