smtzcn81/muhasebe/assets/urunler/pdf/1185005012.pdf

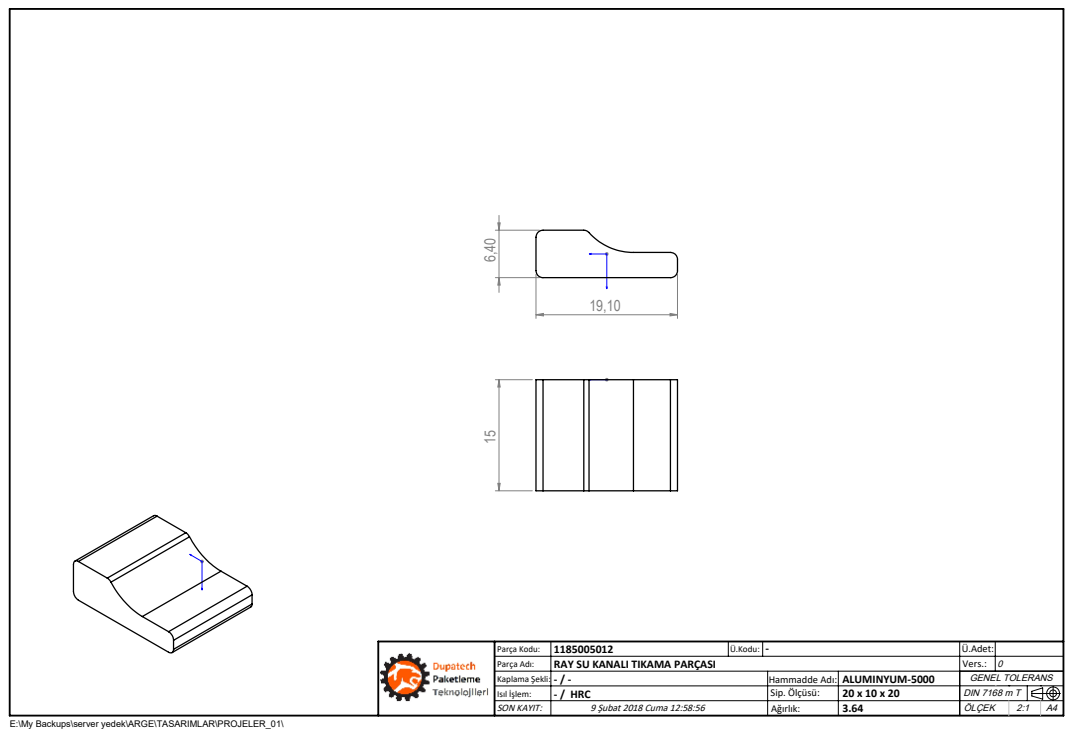
[picture p66: page 1]
Parça Kodu:; Parça Adı:; RAY SU KANALI TIKAMA PARÇASI; SON KAYIT:; 9 Şubat 2018 Cuma 12:58:56; Kaplama Şekli: - / -; Hammadde Adı: ALUMINYUM-5000; Sip. Ölçüsü:; GENEL TOLERANS; DIN 7168 m T; Ü.Kodu: -; Vers.: 0; Isıl İşlem:; - / HRC

E:\My Backups\server yedek\ARGE\TASARIMLAR\PROJELER_01\
