smtzcn81/muhasebe/assets/urunler/pdf/1185009001_9SDS.pdf

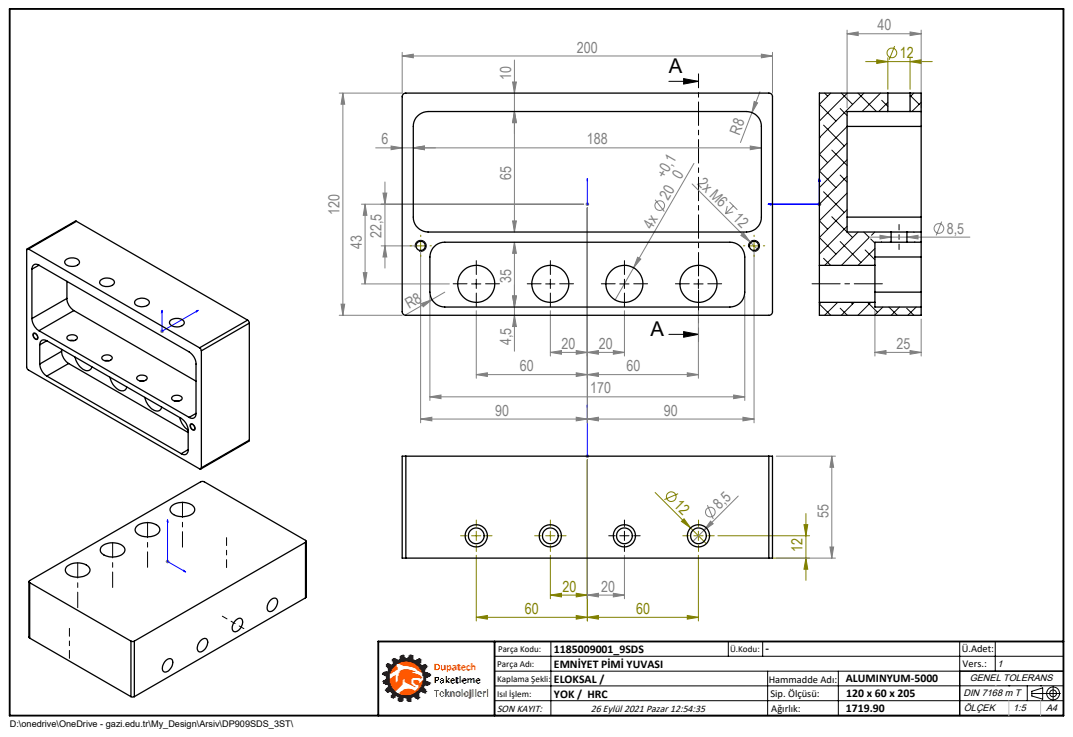
[picture p67: page 1]
Parça Kodu:; Parça Adı:; EMNİYET PİMİ YUVASI; SON KAYIT:; 26 Eylül 2021 Pazar 12:54:35; Kaplama Şekli: ELOKSAL /; Hammadde Adı: ALUMINYUM-5000; Sip. Ölçüsü:; GENEL TOLERANS; DIN 7168 m T; 1185009001_9SDS; Ü.Kodu: -; Vers.: 1; Isıl İşlem:; YOK / HRC

D:\onedrive\OneDrive - gazi.edu.tr\My_Design\Arsiv\DP909SDS_3ST\
