smtzcn81/muhasebe/assets/urunler/pdf/1185009004.pdf

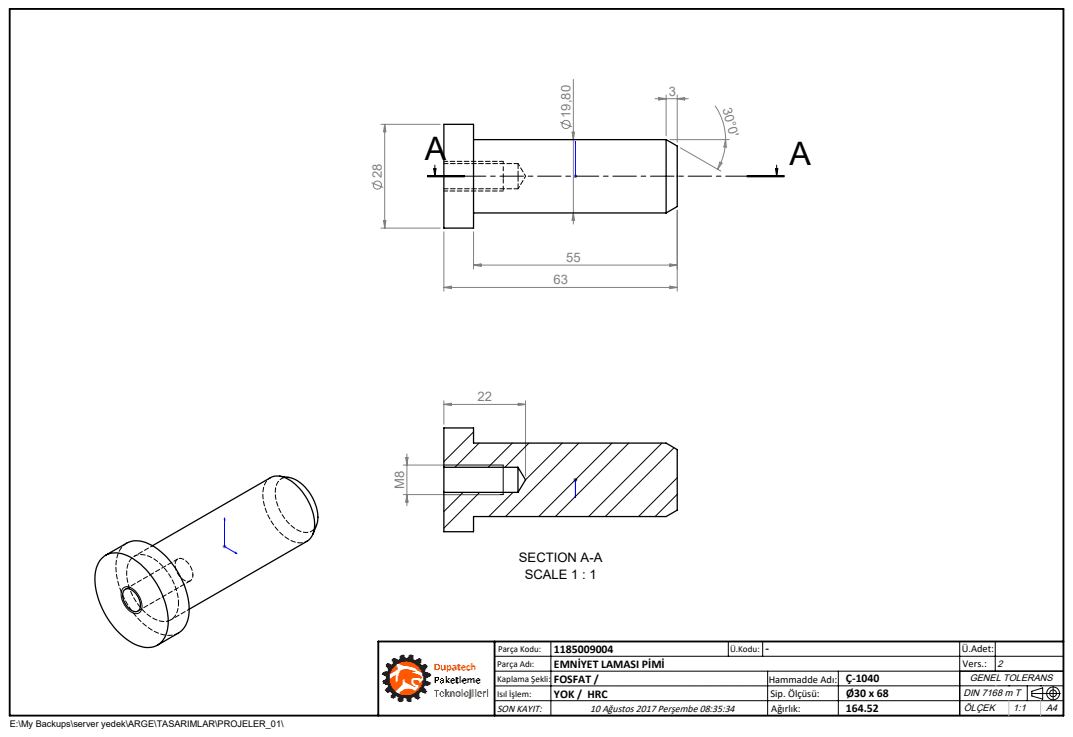
[picture p68: page 1]
SECTION A-A SCALE 1 : 1

Parça Kodu: | 1185009004 | Ü.Kodu: | - | Ü.Adet:
Parça Adı: | EMNİYET LAMASI PİMİ | | | Vers.: | 2
Kaplama Şekli: FOSFAT / | | Hammadde Adı: | Ç-1040 | GENEL TOLERANS
Isıl İşlem: | YOK / HRC | Sip. Ölçüsü: | Ø30 x 68 | DIN 7168 m T
SON KAYIT: | 10 Ağustos 2017 Perşembe 08:35:34 | Ağırlık: | 164.52 A4 | ÖLÇEK | 1:1

E:\My Backups\server yedek\ARGE\TASARIMLAR\PROJELER_01\
