smtzcn81/muhasebe/assets/urunler/pdf/1185009004_9SDS.pdf

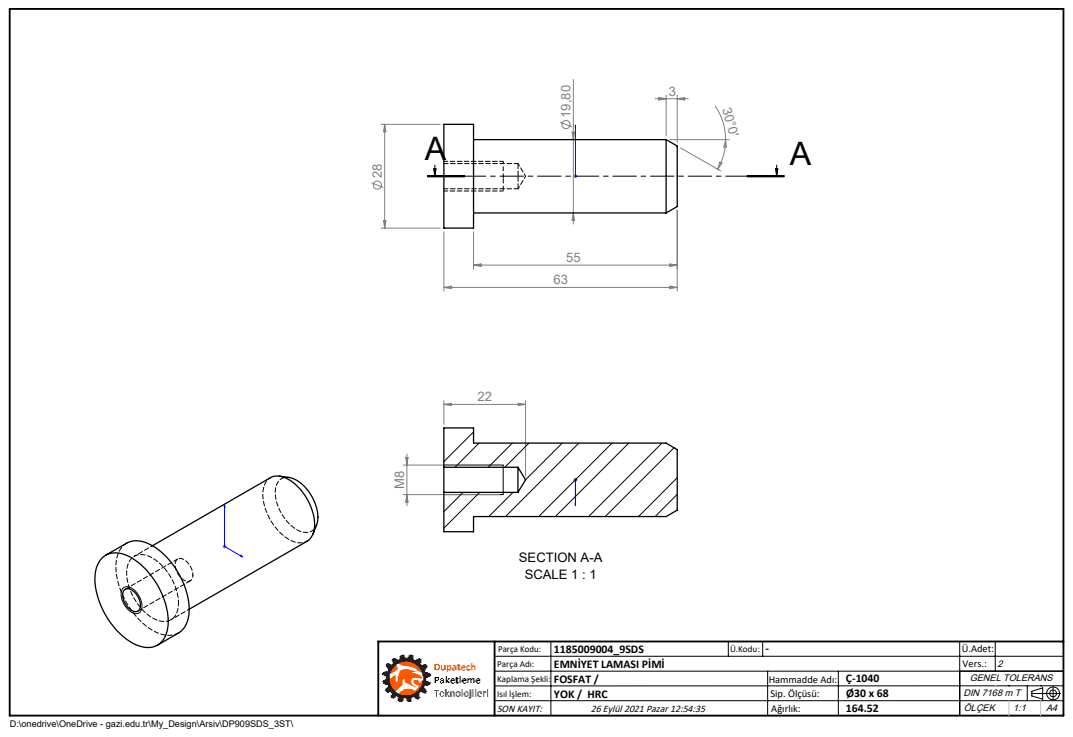
[picture p69: page 1]
SECTION A-A SCALE 1 : 1

Parça Kodu: | 1185009004_9SDS | Ü.Kodu: | - | Ü.Adet:
Parça Adı: | EMNİYET LAMASI PİMİ | | | Vers.: | 2
Kaplama Şekli: FOSFAT / | | Hammadde Adı: | Ç-1040 | GENEL TOLERANS
Isıl İşlem: | YOK / HRC | Sip. Ölçüsü: | Ø30 x 68 | DIN 7168 m T
SON KAYIT: | 26 Eylül 2021 Pazar 12:54:35 | Ağırlık: | 164.52 A4 | ÖLÇEK | 1:1

D:\onedrive\OneDrive - gazi.edu.tr\My_Design\Arsiv\DP909SDS_3ST\
