smtzcn81/muhasebe/assets/urunler/pdf/1185010005.pdf

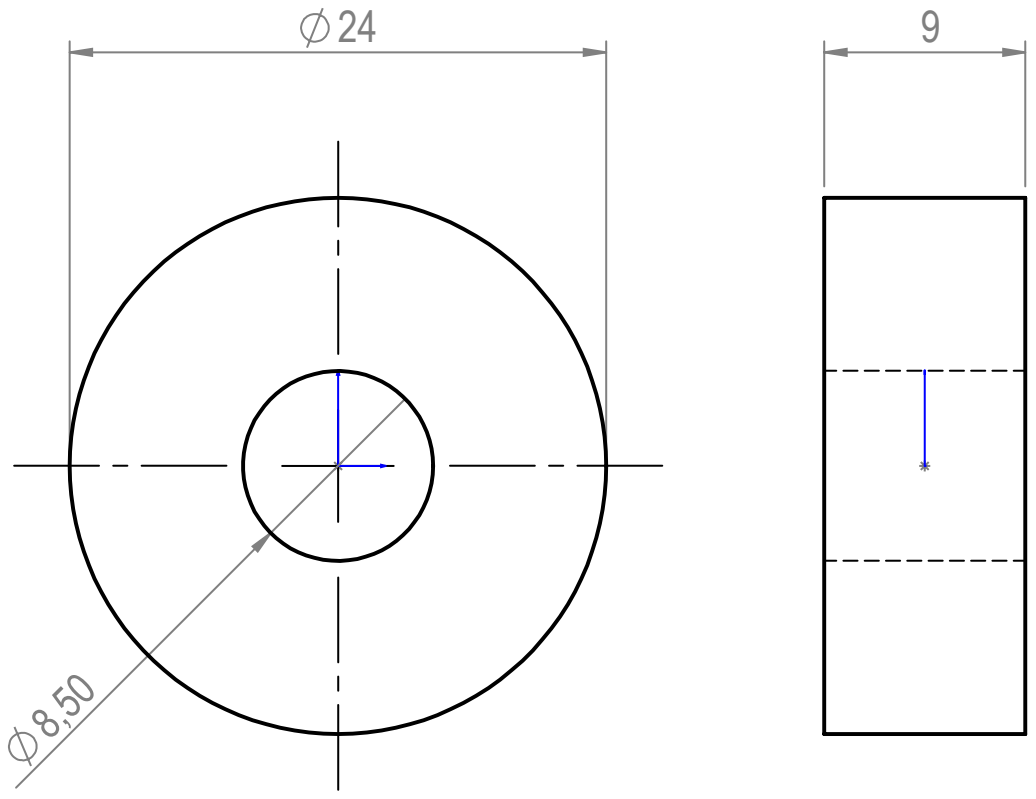
[picture p71: page 1]

Parça Kodu: | 1185010005 | Ü.Kodu: | - | Ü.Adet:
Parça Adı: | MAL GİRİŞ MERDANESİ ARA PULU | | | Vers.: | 0
Kaplama Şekli: - / | | Hammadde Adı: | SIYAH POLİAMİD | GENEL TOLERANS
Isıl İşlem: | - / HRC | Sip. Ölçüsü: | Ø25 x 14 | DIN 7168 m T
SON KAYIT: | 10 Mayıs 2021 Pazartesi 13:24:16 | Ağırlık: | 3.27 A4 | ÖLÇEK | 2:1

F:\My Backups\server yedek\ARGE\TASARIMLAR\PROJELER_01\
