smtzcn81/muhasebe/assets/urunler/pdf/1185011003.pdf

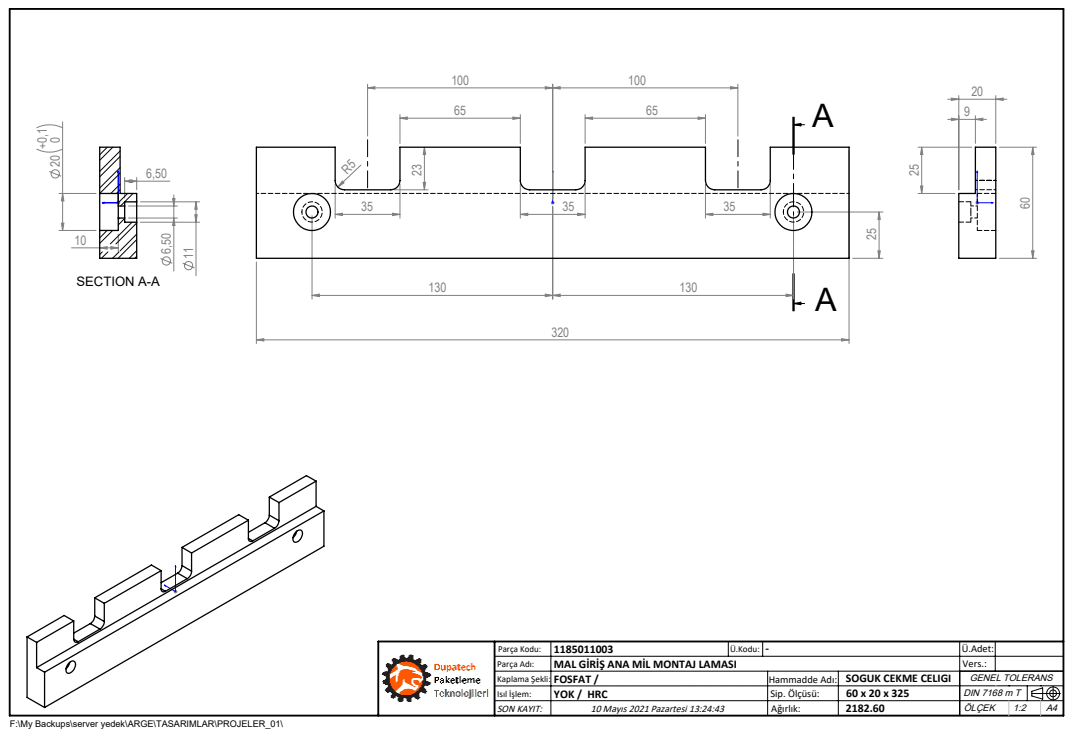
[picture p72: page 1]
SECTION A-A

Parça Kodu: | 1185011003 | Ü.Kodu: | - | Ü.Adet:
Parça Adı: | MAL GİRİŞ ANA MİL MONTAJ LAMASI | | | Vers.:
Kaplama Şekli: FOSFAT / | | Hammadde Adı: | SOGUK CEKME CELIGI | GENEL TOLERANS
Isıl İşlem: | YOK / HRC | Sip. Ölçüsü: | 60 x 20 x 325 | DIN 7168 m T
SON KAYIT: | 10 Mayıs 2021 Pazartesi 13:24:43 | Ağırlık: | 2182.60 A4 | ÖLÇEK | 1:2

F:\My Backups\server yedek\ARGE\TASARIMLAR\PROJELER_01\
