smtzcn81/muhasebe/assets/urunler/pdf/1185011006.pdf

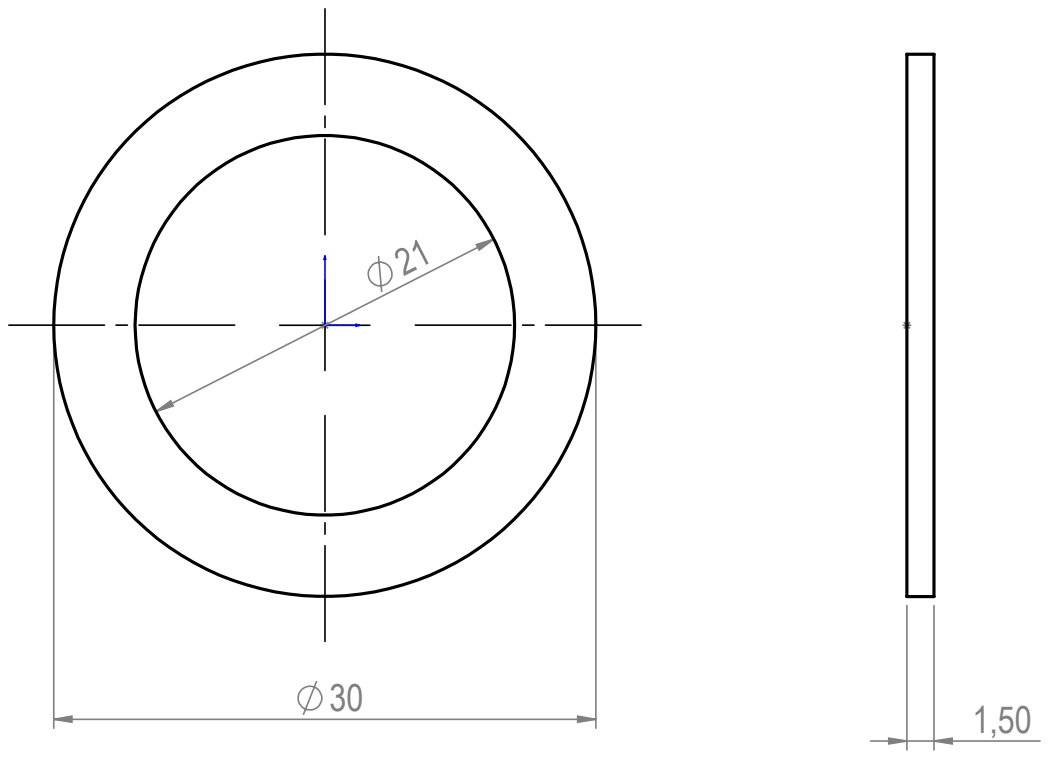
[picture p73: page 1]
Parça Kodu:; Parça Adı:; DİZGİ MİLİ YAN YATAĞI; SON KAYIT:; 22 Mayıs 2018 Salı 09:34:28; Kaplama Şekli: YOK /; Hammadde Adı: POLİAMİD; Sip. Ölçüsü:; GENEL TOLERANS; Cap 30 x 1.5 0.50 A4; DIN 7168 m T; Ü.Kodu: -; Isıl İşlem:; YOK / HRC

E:\My Backups\server yedek\ARGE\TASARIMLAR\PROJELER_01\
