smtzcn81/muhasebe/assets/urunler/pdf/1185011007.pdf

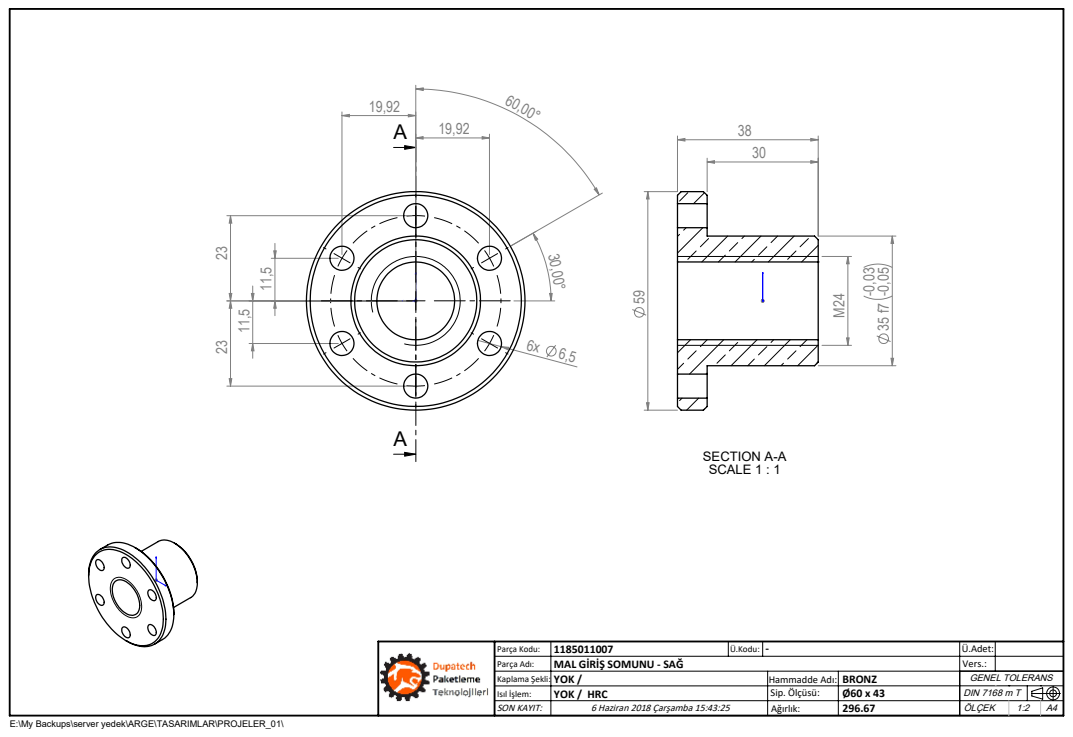
[picture p74: page 1]
SECTION A-A SCALE 1 : 1; Parça Kodu:; Parça Adı:; MAL GİRİŞ SOMUNU - SAĞ; SON KAYIT:; 6 Haziran 2018 Çarşamba 15:43:25; Kaplama Şekli: YOK /; Hammadde Adı: BRONZ; Sip. Ölçüsü:; GENEL TOLERANS; DIN 7168 m T; Ü.Kodu: -; Isıl İşlem:; YOK / HRC

E:\My Backups\server yedek\ARGE\TASARIMLAR\PROJELER_01\
