smtzcn81/muhasebe/assets/urunler/pdf/1185011010.pdf

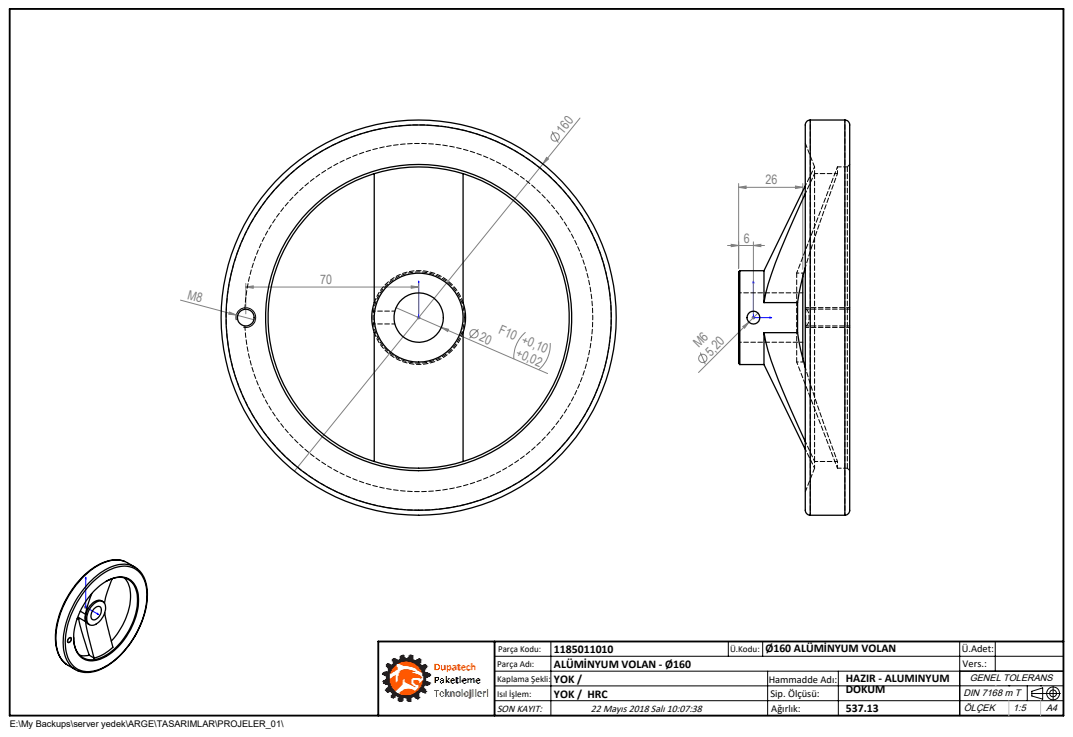
[picture p75: page 1]

Parça Kodu: | 1185011010 | Ü.Kodu: | Ø160 ALÜMİNYUM VOLAN | Ü.Adet:
Parça Adı: | ALÜMİNYUM VOLAN - Ø160 | | | Vers.:
Kaplama Şekli: YOK / | | Hammadde Adı: | HAZIR - ALUMINYUM | GENEL TOLERANS
Isıl İşlem: | YOK / HRC | Sip. Ölçüsü: | DOKUM | DIN 7168 m T
SON KAYIT: | 22 Mayıs 2018 Salı 10:07:38 | Ağırlık: | 537.13 | ÖLÇEK | 1:5 | A4

E:\My Backups\server yedek\ARGE\TASARIMLAR\PROJELER_01\
