smtzcn81/muhasebe/assets/urunler/pdf/1185011013.pdf

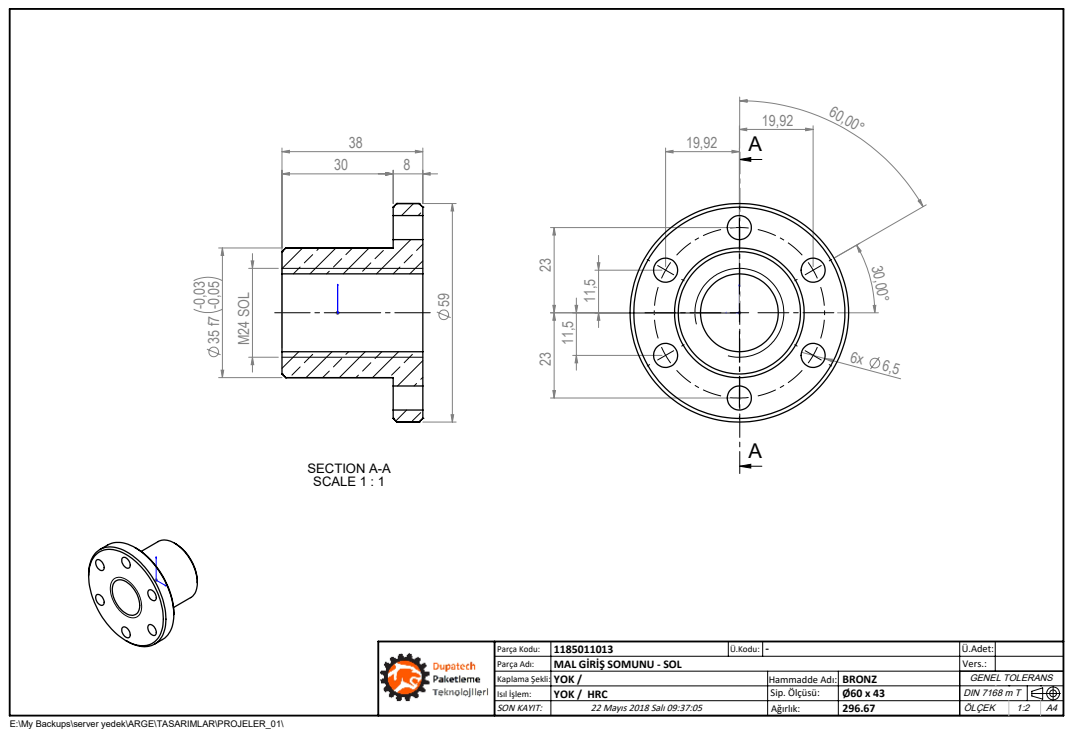
[picture p76: page 1]
M24 SOL; SECTION A-A SCALE 1 : 1; Parça Kodu:; Parça Adı:; MAL GİRİŞ SOMUNU - SOL; SON KAYIT:; 22 Mayıs 2018 Salı 09:37:05; Kaplama Şekli: YOK /; Hammadde Adı: BRONZ; Sip. Ölçüsü:; GENEL TOLERANS; DIN 7168 m T; Ü.Kodu: -; Isıl İşlem:; YOK / HRC

E:\My Backups\server yedek\ARGE\TASARIMLAR\PROJELER_01\
