smtzcn81/muhasebe/assets/urunler/pdf/1185013003.pdf

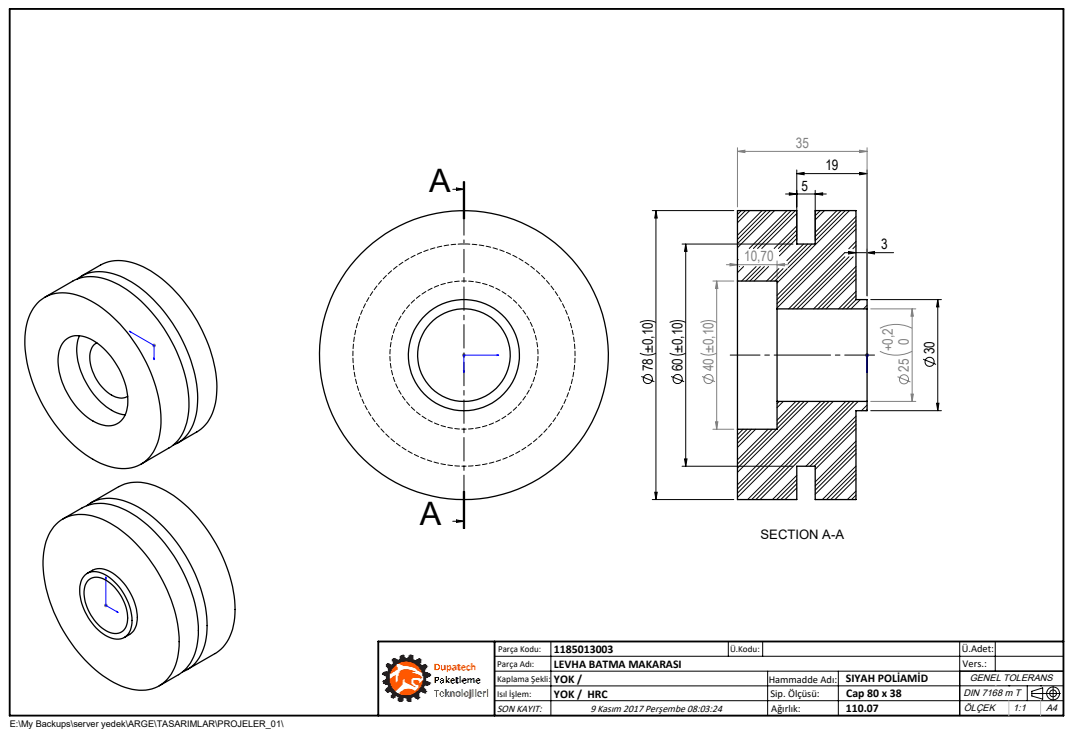
[picture p77: page 1]
SECTION A-A

Parça Kodu: | 1185013003 | Ü.Kodu: | | Ü.Adet:
Parça Adı: | LEVHA BATMA MAKARASI | | | Vers.:
Kaplama Şekli: YOK / | | Hammadde Adı: | SIYAH POLİAMİD | GENEL TOLERANS
Isıl İşlem: | YOK / HRC | Sip. Ölçüsü: | Cap 80 x 38 | DIN 7168 m T
SON KAYIT: | 9 Kasım 2017 Perşembe 08:03:24 | Ağırlık: | 110.07 A4 | ÖLÇEK | 1:1

E:\My Backups\server yedek\ARGE\TASARIMLAR\PROJELER_01\
