smtzcn81/muhasebe/assets/urunler/pdf/1185013003_9SDS.pdf

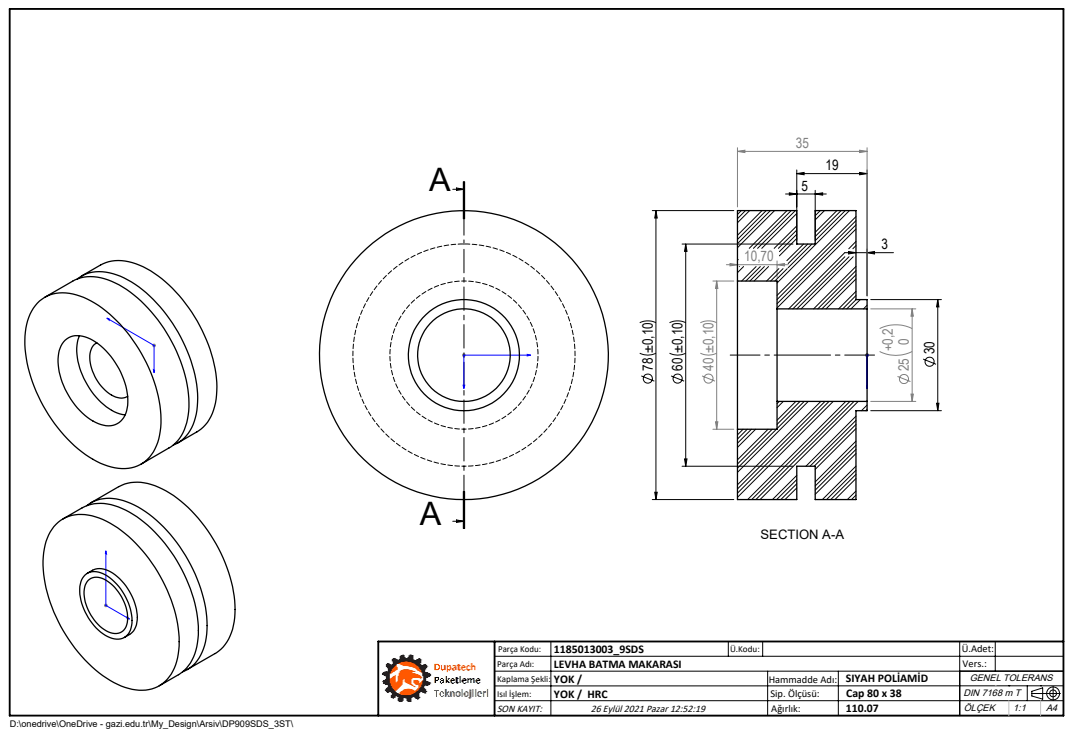
[picture p78: page 1]
SECTION A-A

Parça Kodu: | 1185013003_9SDS | Ü.Kodu: | | Ü.Adet:
Parça Adı: | LEVHA BATMA MAKARASI | | | Vers.:
Kaplama Şekli: YOK / | | Hammadde Adı: | SIYAH POLİAMİD | GENEL TOLERANS
Isıl İşlem: | YOK / HRC | Sip. Ölçüsü: | Cap 80 x 38 | DIN 7168 m T
SON KAYIT: | 26 Eylül 2021 Pazar 12:52:19 | Ağırlık: | 110.07 A4 | ÖLÇEK | 1:1

D:\onedrive\OneDrive - gazi.edu.tr\My_Design\Arsiv\DP909SDS_3ST\
