smtzcn81/muhasebe/assets/urunler/pdf/1185013004.pdf

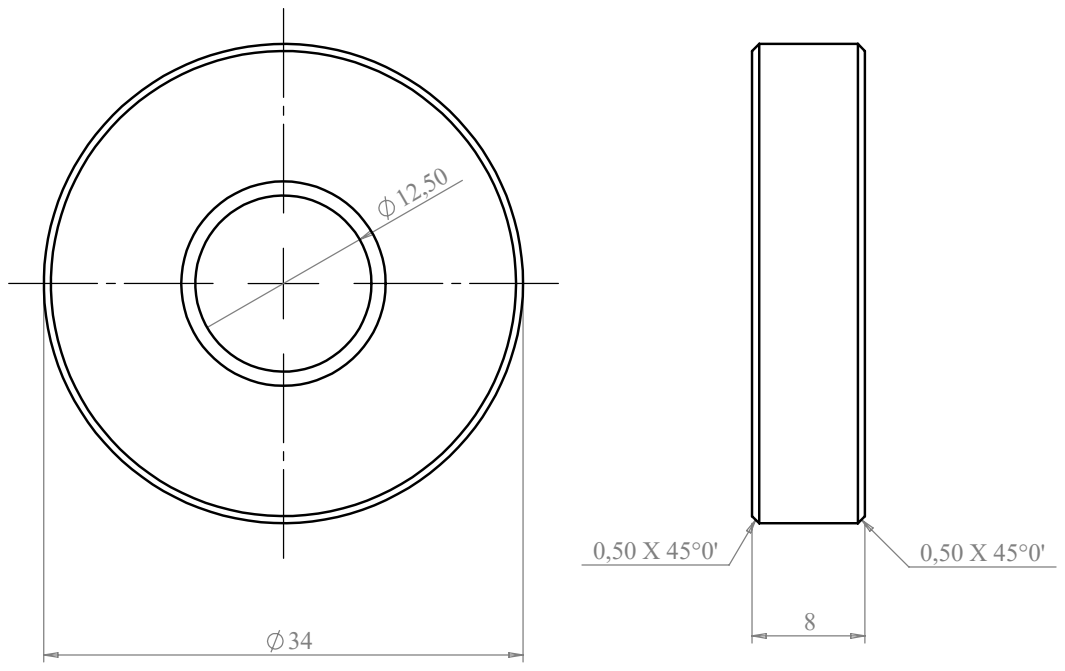
[picture p79: page 1]

Parça Kodu: | 1185013004 | Ü.Kodu: | | Ü.Adet:
Parça Adı: | LEVHA BATMA MAKARA PULU | | | Vers.: | 0
Kaplama Şekli: FOSFAT / | | Hammadde Adı: | OTOMAT ÇELİĞİ | GENEL TOLERANS
Isıl İşlem: | YOK / HRC | Sip. Ölçüsü: | Ø35 x 13 | DIN 7168 m T
SON KAYIT: | 4 Temmuz 2018 Çarşamba 08:58:42 | Ağırlık: | 48.78 A4 | ÖLÇEK | 1:1

E:\My Backups\server yedek\ARGE\TASARIMLAR\PROJELER_01\
