smtzcn81/muhasebe/assets/urunler/pdf/1185013005.pdf

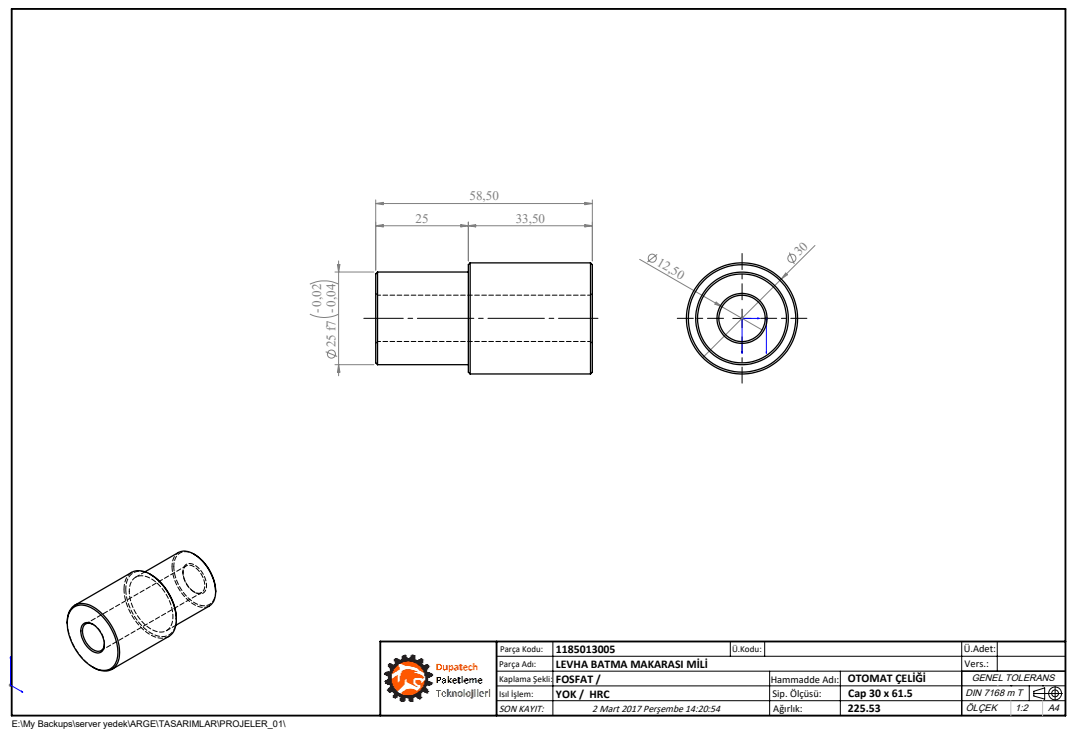
[picture p80: page 1]

Parça Kodu: | 1185013005 | Ü.Kodu: | | Ü.Adet:
Parça Adı: | LEVHA BATMA MAKARASI MİLİ | | | Vers.:
Kaplama Şekli: FOSFAT / | | Hammadde Adı: | OTOMAT ÇELİĞİ | GENEL TOLERANS
Isıl İşlem: | YOK / HRC | Sip. Ölçüsü: | Cap 30 x 61.5 | DIN 7168 m T
SON KAYIT: | 2 Mart 2017 Perşembe 14:20:54 | Ağırlık: | 225.53 A4 | ÖLÇEK | 1:2

E:\My Backups\server yedek\ARGE\TASARIMLAR\PROJELER_01\
