smtzcn81/muhasebe/assets/urunler/pdf/1185013008.pdf

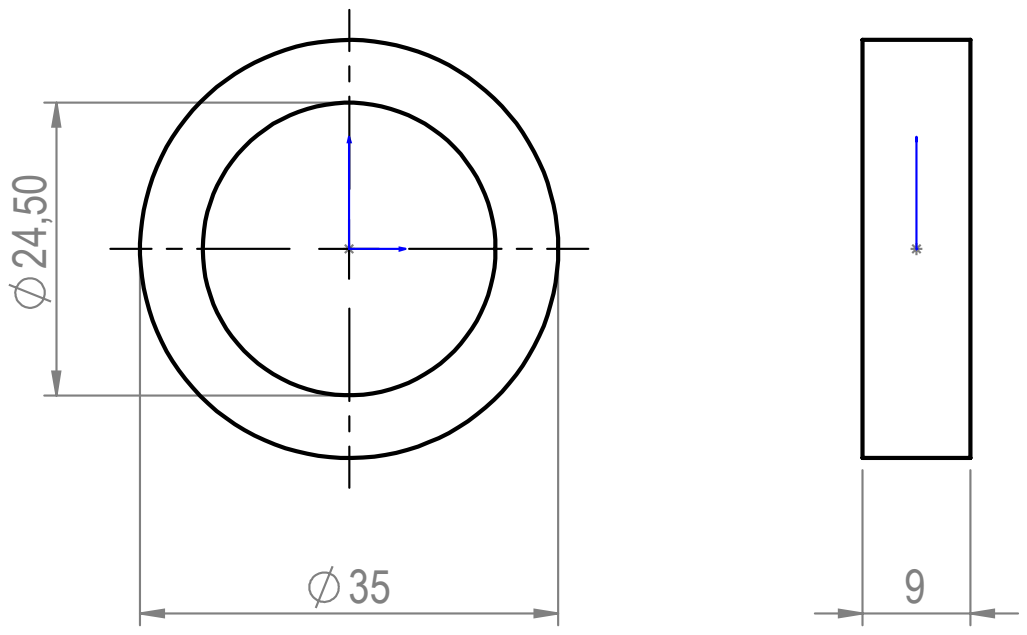
[picture p81: page 1]

Parça Kodu: | 1185013008 | Ü.Kodu: | - | Ü.Adet:
Parça Adı: | GİRİŞ GERGİ MAKARA PULU | | | Vers.: | 0
Kaplama Şekli: FOSFAT / | | Hammadde Adı: Ç-1040 | | GENEL TOLERANS
Isıl İşlem: | - / HRC | Sip. Ölçüsü: | Ø40 x 14 | DIN 7168 m T
SON KAYIT: | 15 Aralık 2017 Cuma 13:17:14 | Ağırlık: | 34.67 A4 | ÖLÇEK | 2:1

E:\My Backups\server yedek\ARGE\TASARIMLAR\PROJELER_01\
