smtzcn81/muhasebe/assets/urunler/pdf/1185013009.pdf

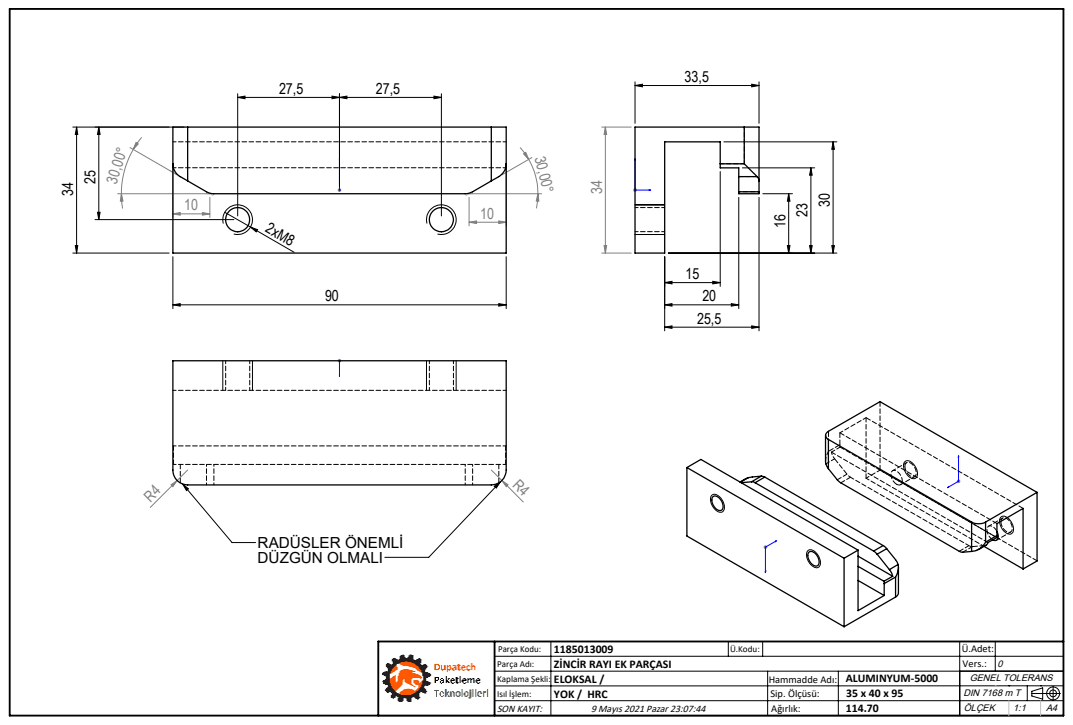
[picture p82: page 1]
RADÜSLER ÖNEMLİ DÜZGÜN OLMALI; Parça Kodu:; Parça Adı:; ZİNCİR RAYI EK PARÇASI; SON KAYIT:; 9 Mayıs 2021 Pazar 23:07:44; Kaplama Şekli: ELOKSAL /; Hammadde Adı: ALUMINYUM-5000; Sip. Ölçüsü:; GENEL TOLERANS; DIN 7168 m T; Vers.: 0; Isıl İşlem:; YOK / HRC
