smtzcn81/muhasebe/assets/urunler/pdf/1185013009_9SDS_Rev01.pdf

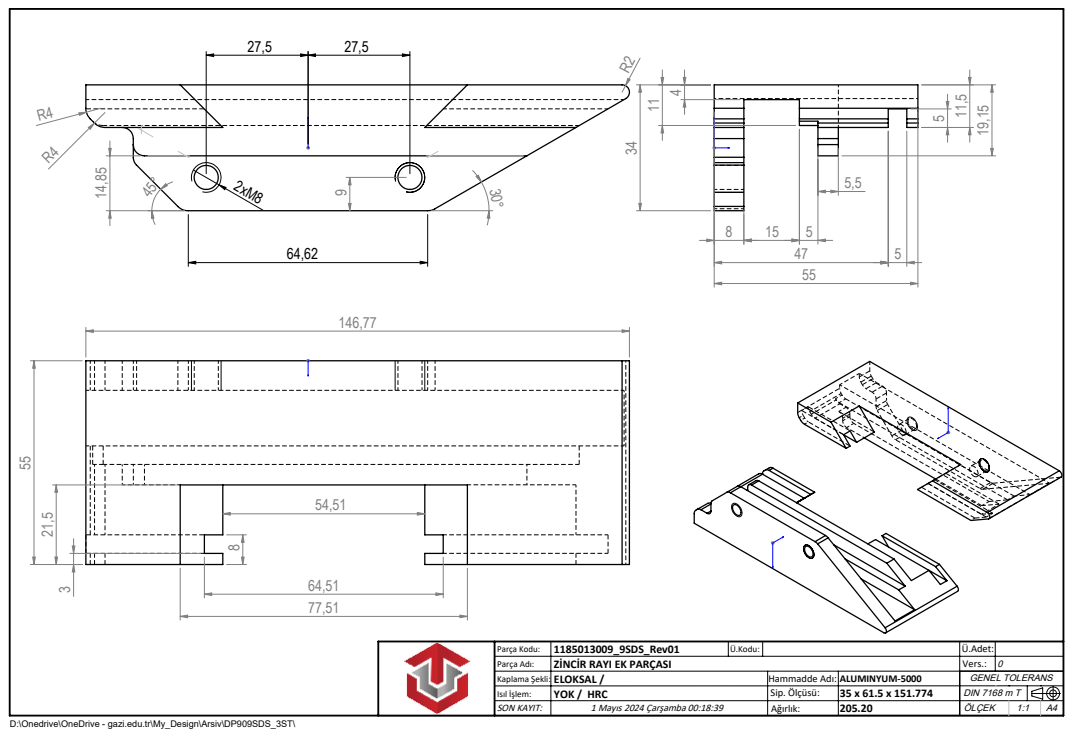
[picture p83: page 1]
Parça Kodu:; Parça Adı:; ZİNCİR RAYI EK PARÇASI; SON KAYIT:; 1 Mayıs 2024 Çarşamba 00:18:39; Kaplama Şekli: ELOKSAL /; Hammadde Adı: ALUMINYUM-5000; Sip. Ölçüsü:; GENEL TOLERANS; DIN 7168 m T; Vers.: 0; Isıl İşlem:; YOK / HRC

D:\Onedrive\OneDrive - gazi.edu.tr\My_Design\Arsiv\DP909SDS_3ST\
