smtzcn81/muhasebe/assets/urunler/pdf/1185013010.pdf

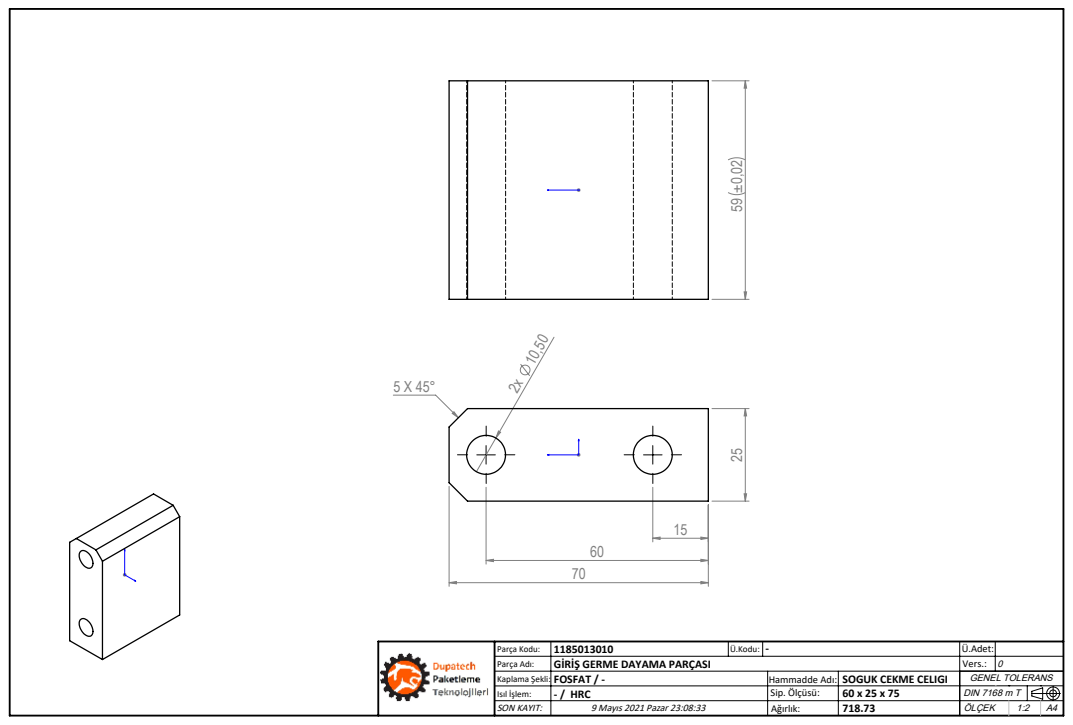
[picture p84: page 1]
Parça Kodu:; Parça Adı:; GİRİŞ GERME DAYAMA PARÇASI; SON KAYIT:; 9 Mayıs 2021 Pazar 23:08:33; Kaplama Şekli: FOSFAT / -; Hammadde Adı: SOGUK CEKME CELIGI; Sip. Ölçüsü:; GENEL TOLERANS; DIN 7168 m T; Ü.Kodu: -; Vers.: 0; Isıl İşlem:; - / HRC
