smtzcn81/muhasebe/assets/urunler/pdf/1185013011.pdf

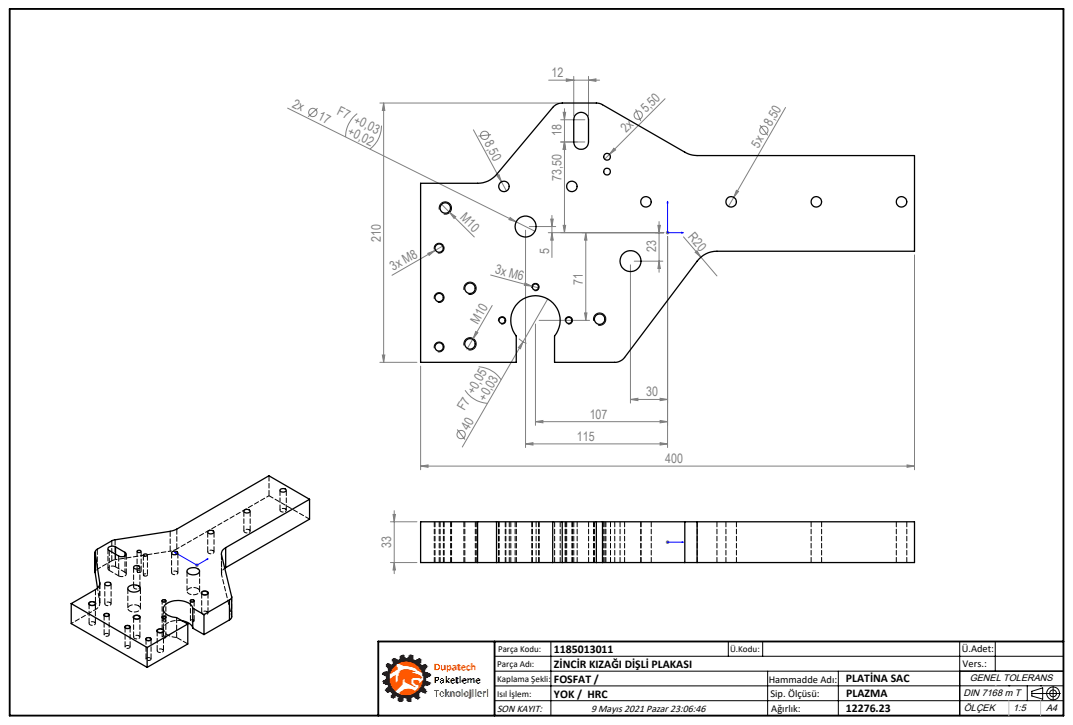
[picture p85: page 1]

Parça Kodu: | 1185013011 | Ü.Kodu: | | Ü.Adet:
Parça Adı: | ZİNCİR KIZAĞI DİŞLİ PLAKASI | | | Vers.:
Kaplama Şekli: FOSFAT / | | Hammadde Adı: | PLATİNA SAC | GENEL TOLERANS
Isıl İşlem: | YOK / HRC | Sip. Ölçüsü: | PLAZMA | DIN 7168 m T
SON KAYIT: | 9 Mayıs 2021 Pazar 23:06:46 | Ağırlık: | 12276.23 A4 | ÖLÇEK | 1:5
