smtzcn81/muhasebe/assets/urunler/pdf/1185013011_9SDS.pdf

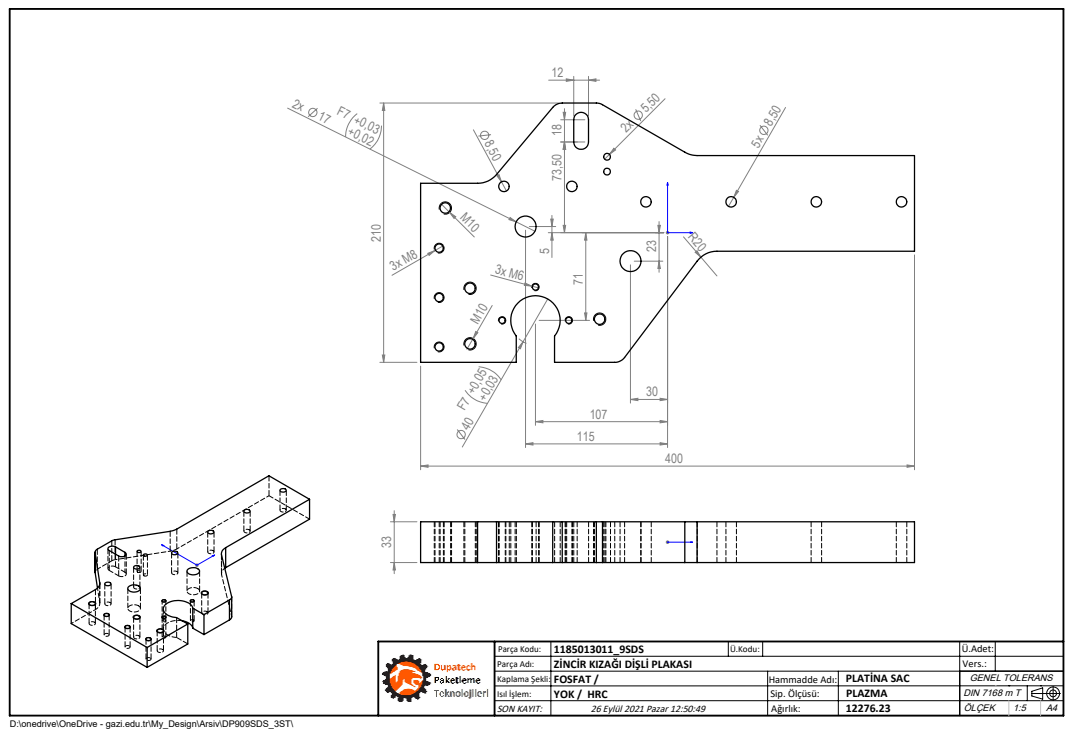
[picture p86: page 1]

Parça Kodu: | 1185013011_9SDS | Ü.Kodu: | | Ü.Adet:
Parça Adı: | ZİNCİR KIZAĞI DİŞLİ PLAKASI | | | Vers.:
Kaplama Şekli: FOSFAT / | | Hammadde Adı: | PLATİNA SAC | GENEL TOLERANS
Isıl İşlem: | YOK / HRC | Sip. Ölçüsü: | PLAZMA | DIN 7168 m T
SON KAYIT: | 26 Eylül 2021 Pazar 12:50:49 | Ağırlık: | 12276.23 A4 | ÖLÇEK | 1:5

D:\onedrive\OneDrive - gazi.edu.tr\My_Design\Arsiv\DP909SDS_3ST\
