smtzcn81/muhasebe/assets/urunler/pdf/1185013012.pdf

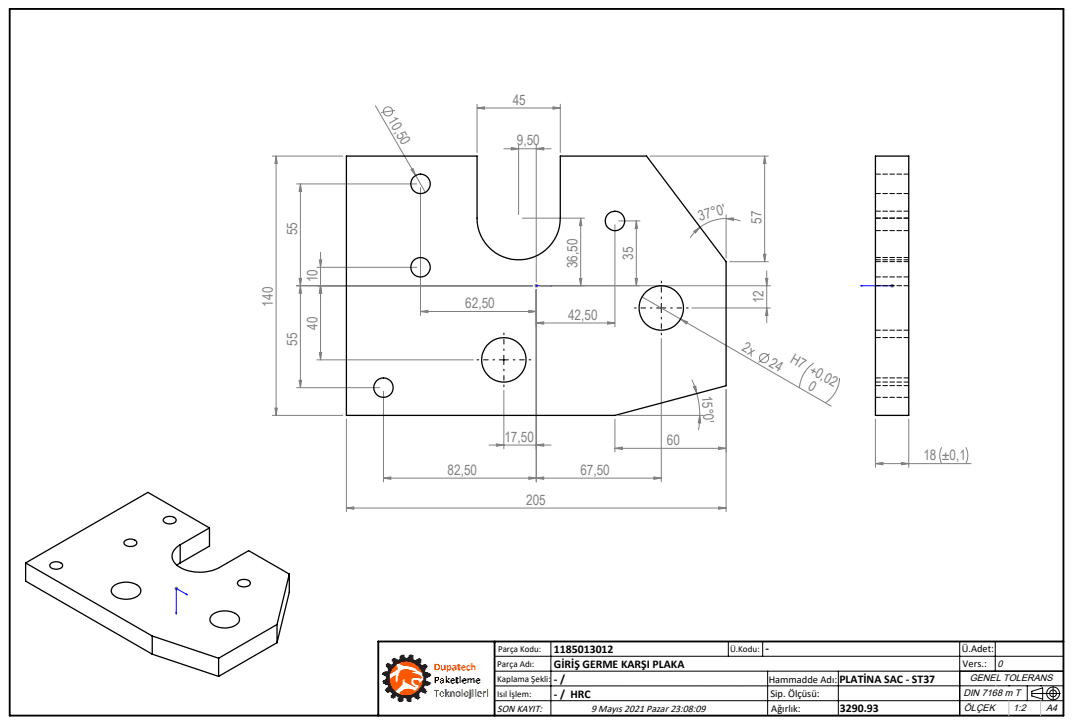
[picture p87: page 1]

Parça Kodu: | 1185013012 | Ü.Kodu: | - | Ü.Adet:
Parça Adı: | GİRİŞ GERME KARŞI PLAKA | | | Vers.: | 0
Kaplama Şekli: - / | | Hammadde Adı: PLATİNA SAC - ST37 | | GENEL TOLERANS
Isıl İşlem: | - / HRC | Sip. Ölçüsü: | | DIN 7168 m T
SON KAYIT: | 9 Mayıs 2021 Pazar 23:08:09 | Ağırlık: | 3290.93 | ÖLÇEK | 1:2 | A4
