smtzcn81/muhasebe/assets/urunler/pdf/1185013013.pdf

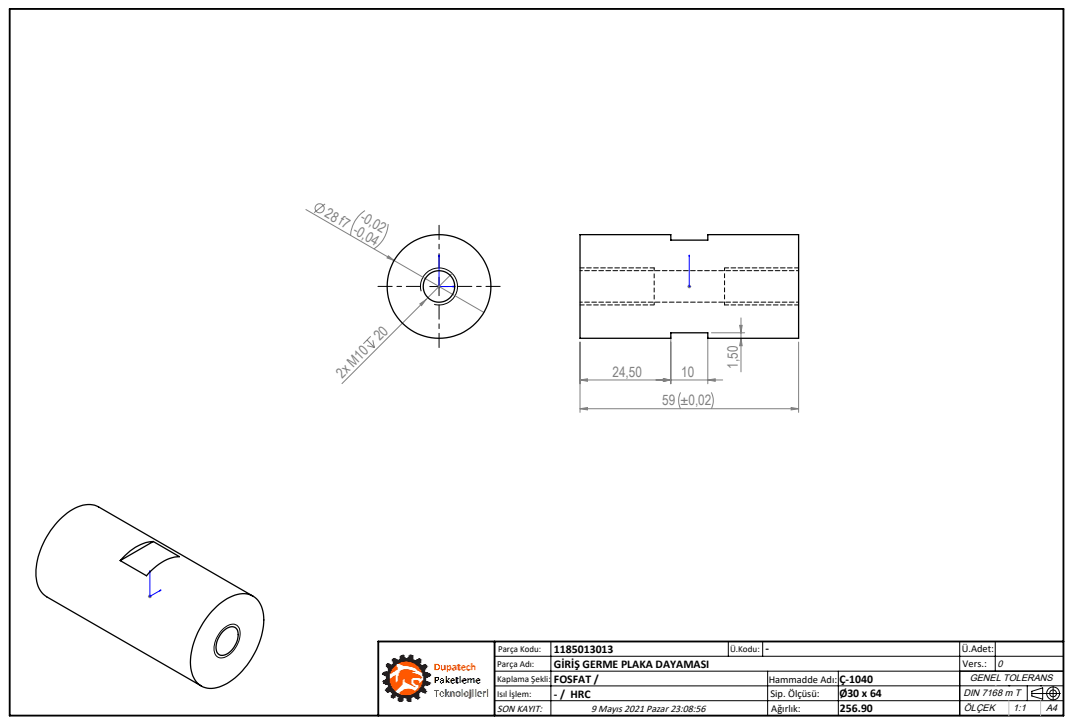
[picture p88: page 1]

Parça Kodu: | 1185013013 | Ü.Kodu: | - | Ü.Adet:
Parça Adı: | GİRİŞ GERME PLAKA DAYAMASI | | | Vers.: | 0
Kaplama Şekli: FOSFAT / | | Hammadde Adı: Ç-1040 | | GENEL TOLERANS
Isıl İşlem: | - / HRC | Sip. Ölçüsü: | Ø30 x 64 | DIN 7168 m T
SON KAYIT: | 9 Mayıs 2021 Pazar 23:08:56 | Ağırlık: | 256.90 A4 | ÖLÇEK | 1:1
