smtzcn81/muhasebe/assets/urunler/pdf/1185019006.pdf

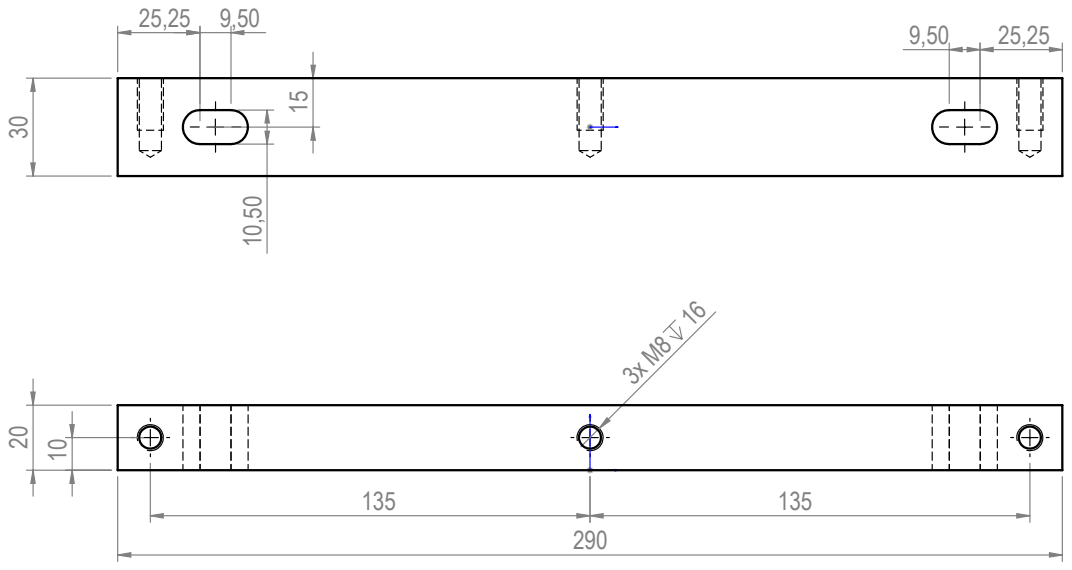
[picture p89: page 1]

Parça Kodu: | 1185019006 | Ü.Kodu: | - | Ü.Adet:
Parça Adı: | MAL GIRIS BAGLAMA LAMASI | | | Vers.: | 0
Kaplama Şekli: FOSFAT / | | Hammadde Adı: | SOGUK CEKME CELIGI | GENEL TOLERANS
Isıl İşlem: | - / HRC | Sip. Ölçüsü: | 30 x 20 x 295 | DIN 7168 m T
SON KAYIT: | 10 Mayıs 2021 Pazartesi 13:22:44 | Ağırlık: | 1287.78 A4 | ÖLÇEK | 1:2

F:\My Backups\server yedek\ARGE\TASARIMLAR\PROJELER_01\
