smtzcn81/muhasebe/assets/urunler/pdf/1185019009.pdf

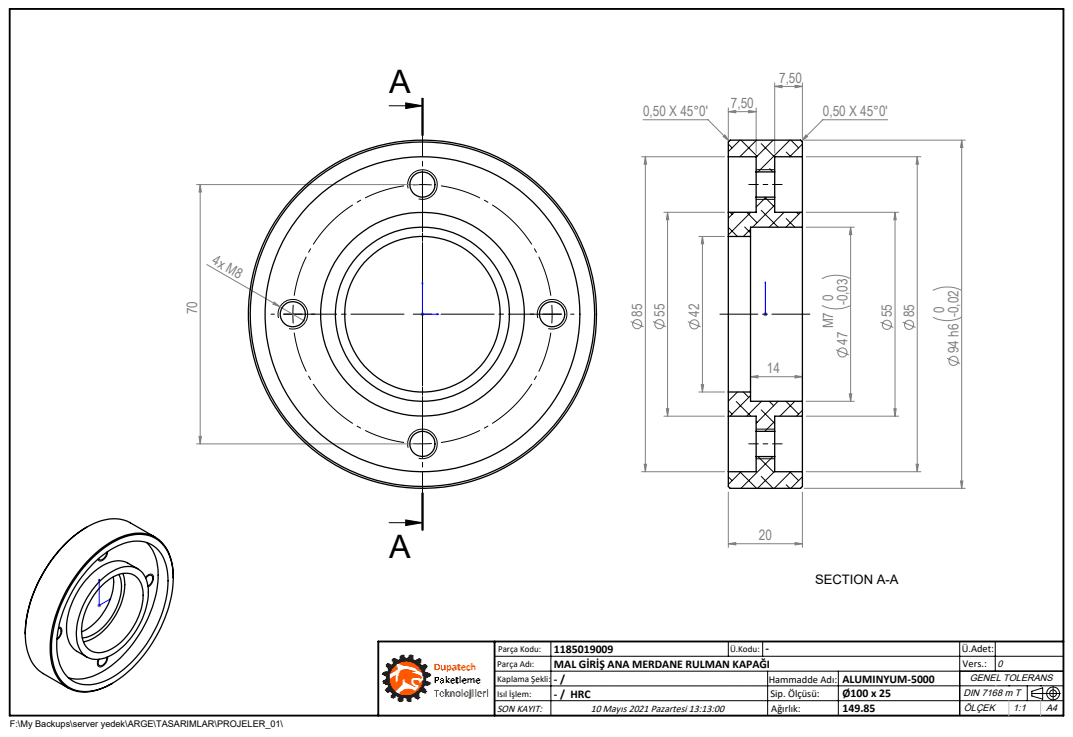
[picture p90: page 1]
SECTION A-A

Parça Kodu: | 1185019009 | Ü.Kodu: | - | Ü.Adet:
Parça Adı: | MAL GİRİŞ ANA MERDANE RULMAN KAPAĞI | | | Vers.: | 0
Kaplama Şekli: - / | | Hammadde Adı: | ALUMINYUM-5000 | GENEL TOLERANS
Isıl İşlem: | - / HRC | Sip. Ölçüsü: | Ø100 x 25 | DIN 7168 m T
SON KAYIT: | 10 Mayıs 2021 Pazartesi 13:13:00 | Ağırlık: | 149.85 A4 | ÖLÇEK | 1:1

F:\My Backups\server yedek\ARGE\TASARIMLAR\PROJELER_01\
