smtzcn81/muhasebe/assets/urunler/pdf/1185020004.pdf

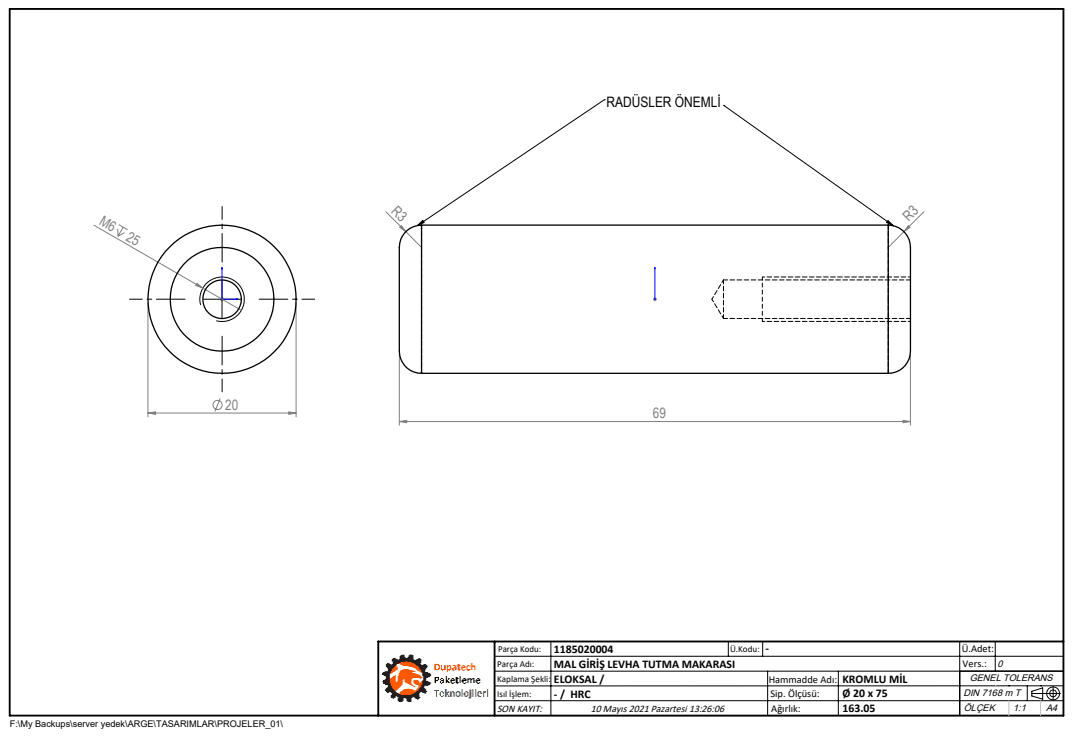
[picture p91: page 1]
RADÜSLER ÖNEMLİ

Parça Kodu: | 1185020004 | Ü.Kodu: | - | Ü.Adet:
Parça Adı: | MAL GİRİŞ LEVHA TUTMA MAKARASI | | | Vers.: | 0
Kaplama Şekli: ELOKSAL / | | Hammadde Adı: | KROMLU MİL | GENEL TOLERANS
Isıl İşlem: | - / HRC | Sip. Ölçüsü: | Ø 20 x 75 | DIN 7168 m T
SON KAYIT: | 10 Mayıs 2021 Pazartesi 13:26:06 | Ağırlık: | 163.05 A4 | ÖLÇEK | 1:1

F:\My Backups\server yedek\ARGE\TASARIMLAR\PROJELER_01\
