smtzcn81/muhasebe/assets/urunler/pdf/1185024008.pdf

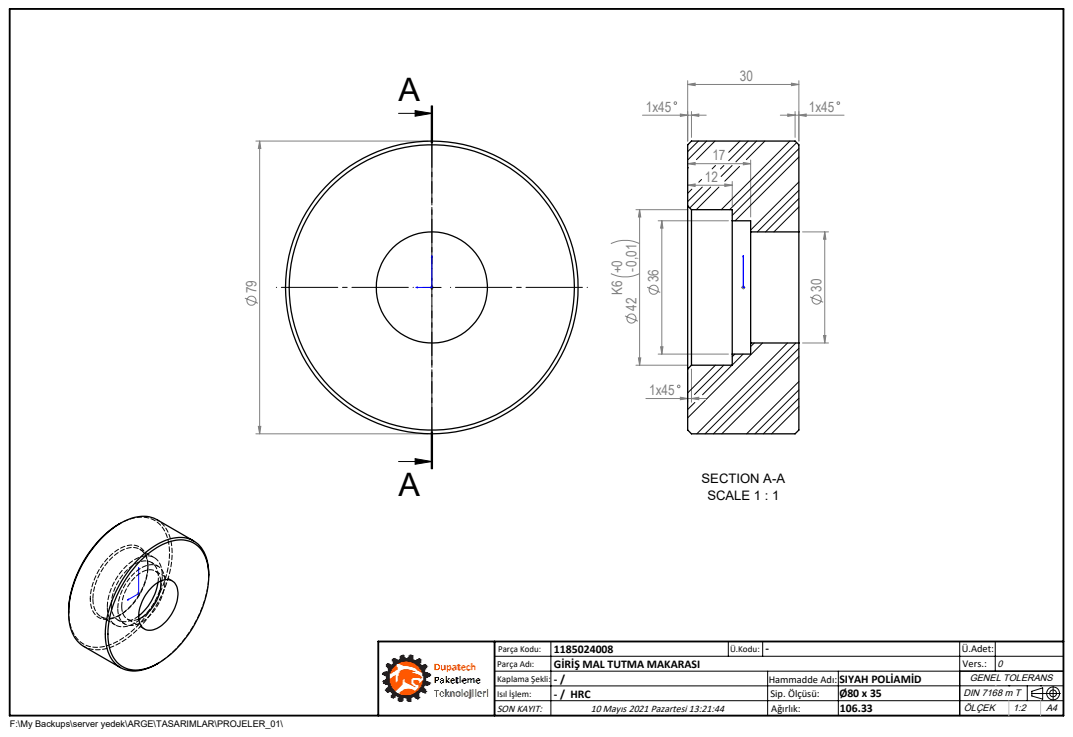
[picture p92: page 1]
SECTION A-A SCALE 1 : 1

Parça Kodu: | 1185024008 | Ü.Kodu: | - | Ü.Adet:
Parça Adı: | GİRİŞ MAL TUTMA MAKARASI | | | Vers.: | 0
Kaplama Şekli: - / | | Hammadde Adı: SIYAH POLİAMİD | | GENEL TOLERANS
Isıl İşlem: | - / HRC | Sip. Ölçüsü: | Ø80 x 35 | DIN 7168 m T
SON KAYIT: | 10 Mayıs 2021 Pazartesi 13:21:44 | Ağırlık: | 106.33 A4 | ÖLÇEK | 1:2

F:\My Backups\server yedek\ARGE\TASARIMLAR\PROJELER_01\
