smtzcn81/muhasebe/assets/urunler/pdf/1185024009.pdf

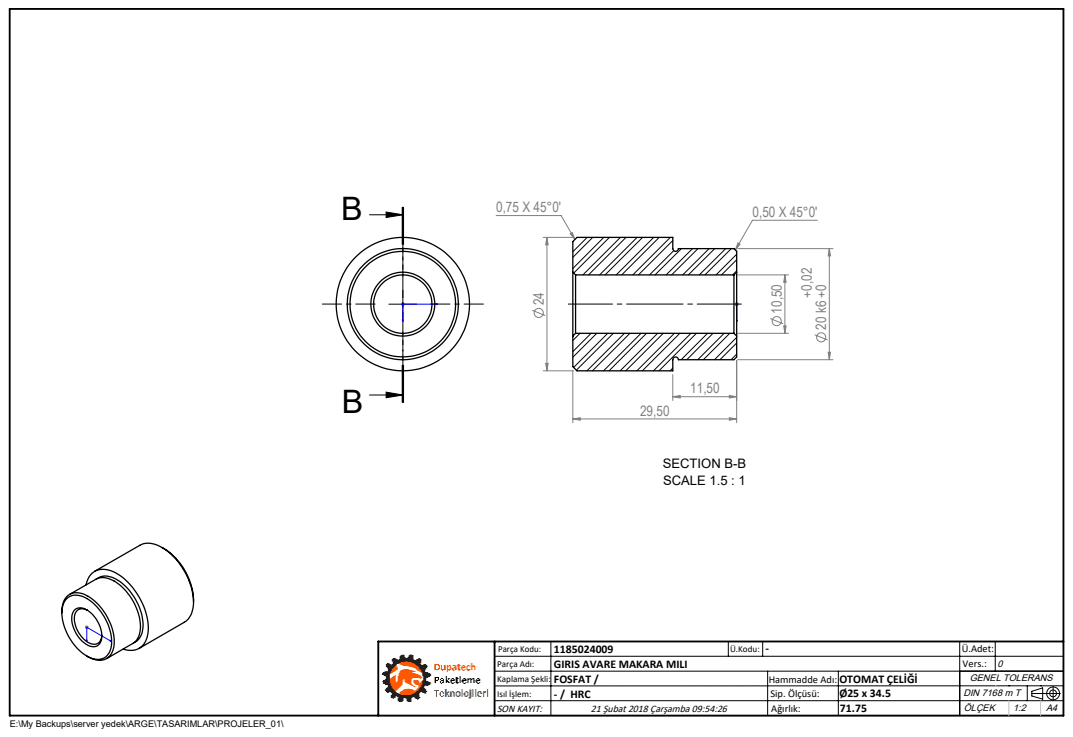
[picture p93: page 1]
SECTION B-B SCALE 1.5 : 1

Parça Kodu: | 1185024009 | Ü.Kodu: | - | Ü.Adet:
Parça Adı: | GIRIS AVARE MAKARA MILI | | | Vers.: | 0
Kaplama Şekli: FOSFAT / | | Hammadde Adı: OTOMAT ÇELİĞİ | | GENEL TOLERANS
Isıl İşlem: | - / HRC | Sip. Ölçüsü: | Ø25 x 34.5 | DIN 7168 m T
SON KAYIT: | 21 Şubat 2018 Çarşamba 09:54:26 | Ağırlık: | 71.75 A4 | ÖLÇEK | 1:2

E:\My Backups\server yedek\ARGE\TASARIMLAR\PROJELER_01\
