smtzcn81/muhasebe/assets/urunler/pdf/1185024010.pdf

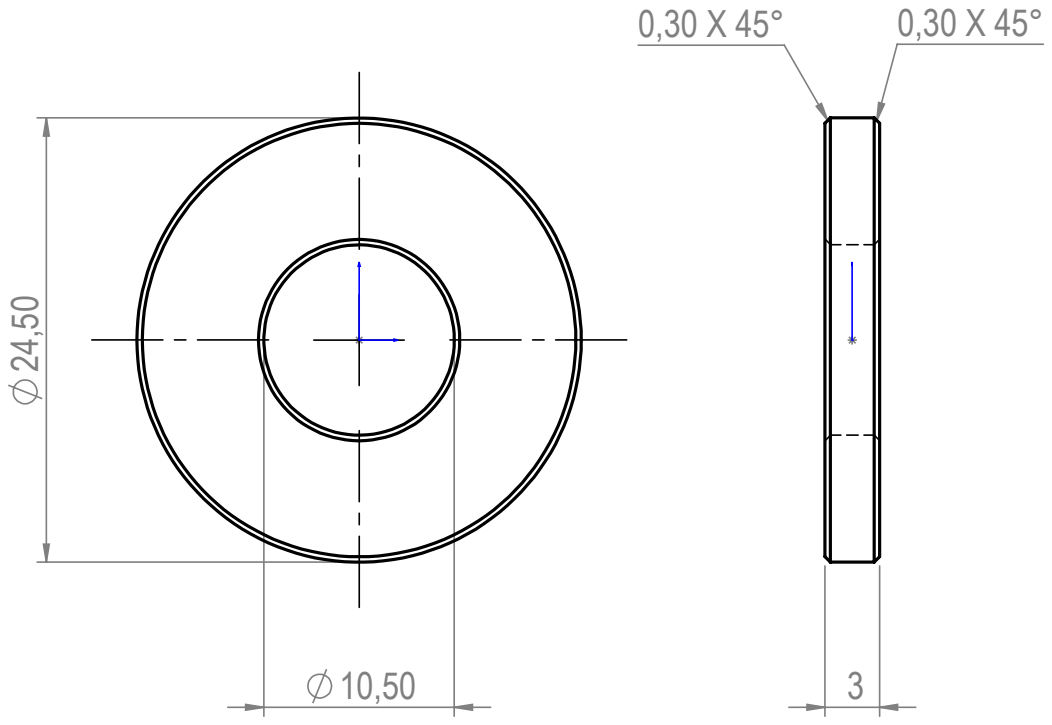
[picture p94: page 1]
Parça Kodu:; Parça Adı:; MAL GİRİŞ CIVATA PULU; SON KAYIT:; 10 Mayıs 2021 Pazartesi 13:22:01; Kaplama Şekli: FOSFAT / -; Hammadde Adı: OTOMAT ÇELİĞİ; Sip. Ölçüsü:; GENEL TOLERANS; DIN 7168 m T; Ü.Kodu: -; Vers.: 0; Isıl İşlem:; - / HRC

F:\My Backups\server yedek\ARGE\TASARIMLAR\PROJELER_01\
