smtzcn81/muhasebe/assets/urunler/pdf/1185025001.pdf

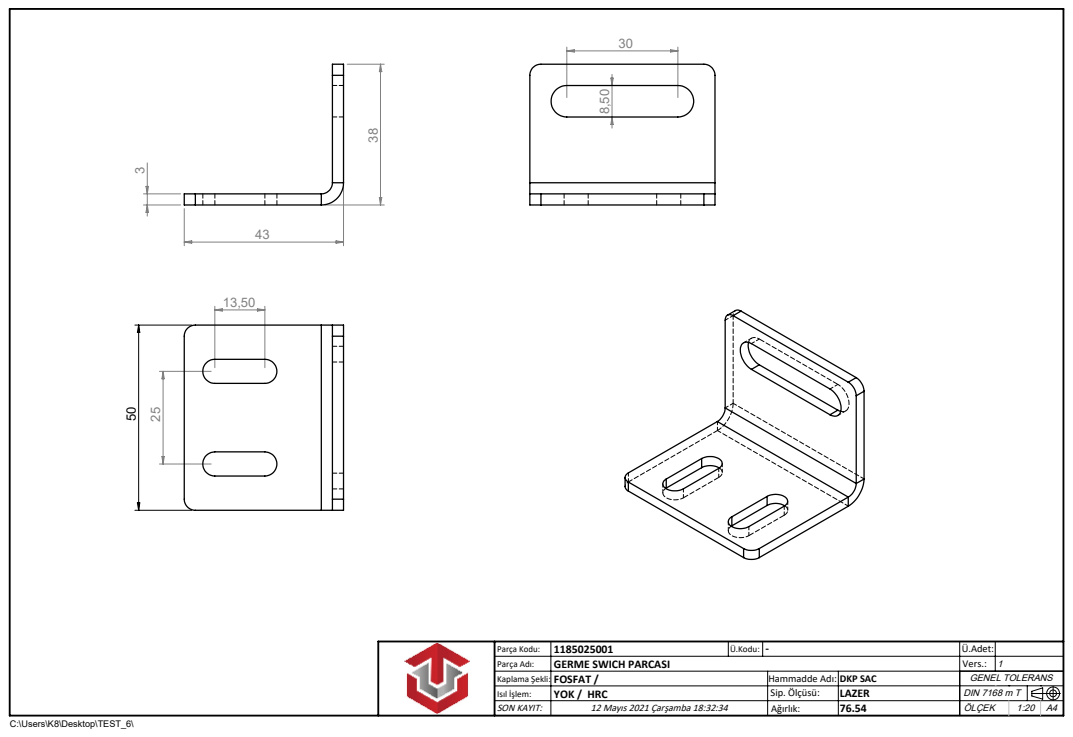
[picture p95: page 1]

Parça Kodu: | 1185025001 | Ü.Kodu: | - | Ü.Adet:
Parça Adı: | GERME SWICH PARCASI | | | Vers.: | 1
Kaplama Şekli: FOSFAT / | | Hammadde Adı: DKP SAC | | GENEL TOLERANS
Isıl İşlem: | YOK / HRC | Sip. Ölçüsü: | LAZER | DIN 7168 m T
SON KAYIT: | 12 Mayıs 2021 Çarşamba 18:32:34 | Ağırlık: | 76.54 A4 | ÖLÇEK | 1:20
