smtzcn81/muhasebe/assets/urunler/pdf/1185025002.pdf

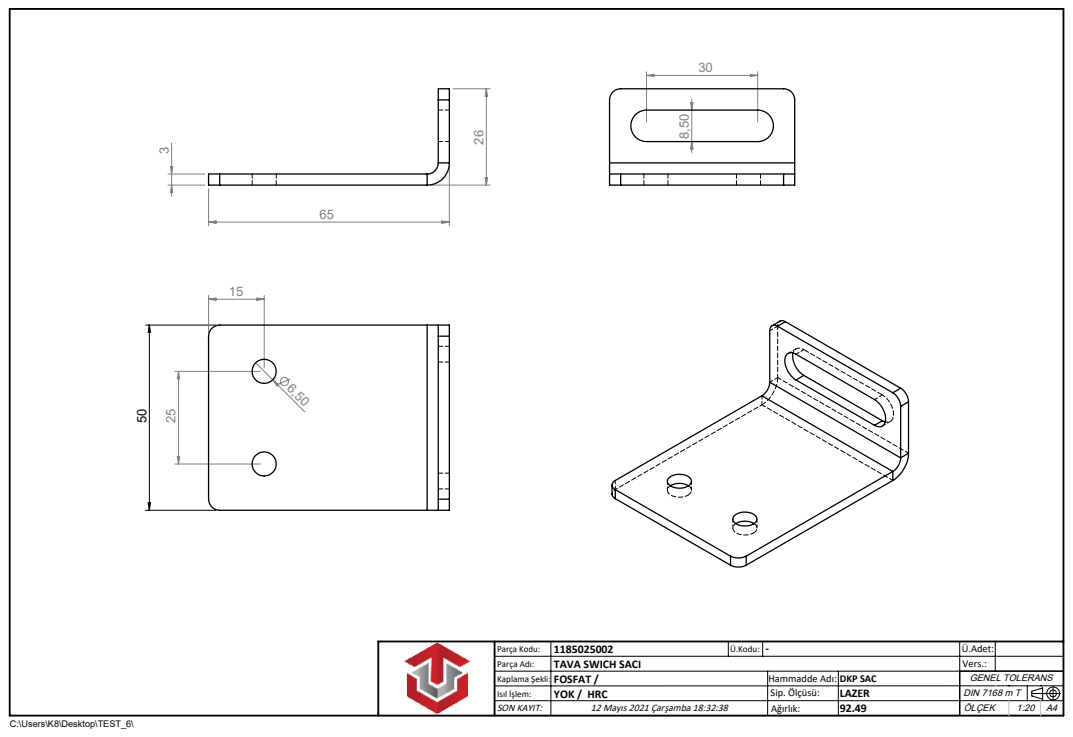
[picture p96: page 1]

Parça Kodu: | 1185025002 | Ü.Kodu: | - | Ü.Adet:
Parça Adı: | TAVA SWICH SACI | | | Vers.:
Kaplama Şekli: FOSFAT / | | Hammadde Adı: DKP SAC | | GENEL TOLERANS
Isıl İşlem: | YOK / HRC | Sip. Ölçüsü: | LAZER | DIN 7168 m T
SON KAYIT: | 12 Mayıs 2021 Çarşamba 18:32:38 | Ağırlık: | 92.49 A4 | ÖLÇEK | 1:20
