smtzcn81/muhasebe/assets/urunler/pdf/1185027001.pdf

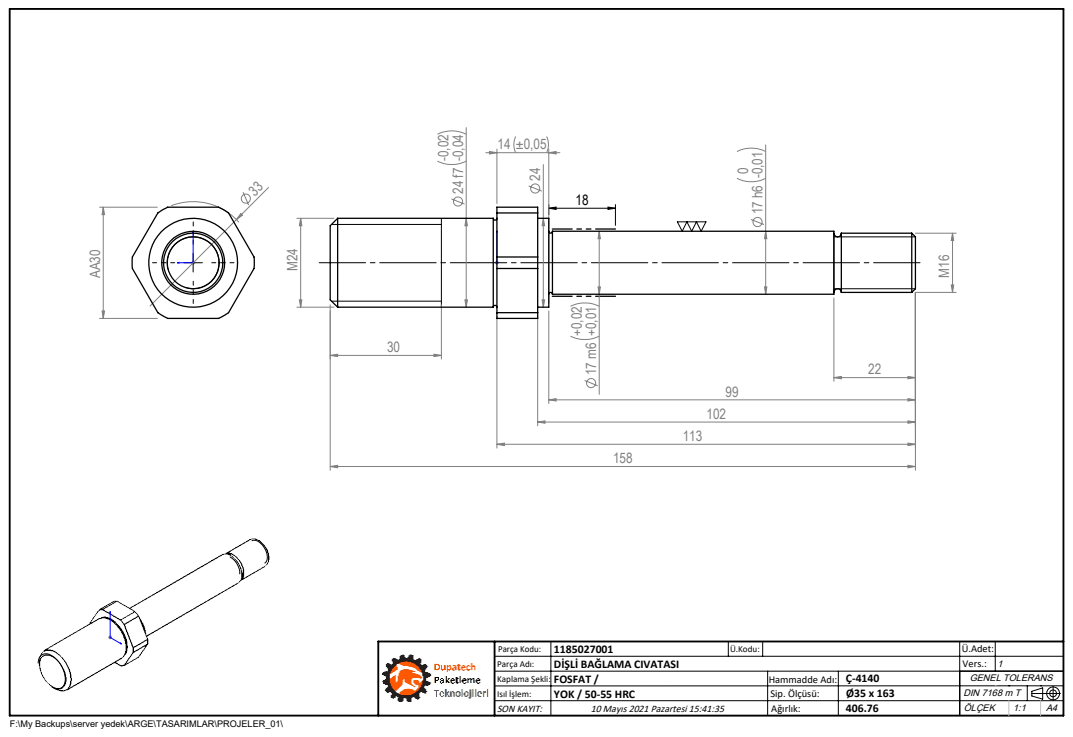
[picture p97: page 1]

Parça Kodu: | 1185027001 | Ü.Kodu: | | Ü.Adet:
Parça Adı: | DİŞLİ BAĞLAMA CIVATASI | | | Vers.: | 1
Kaplama Şekli: FOSFAT / | | Hammadde Adı: | Ç-4140 | GENEL TOLERANS
Isıl İşlem: | YOK / 50-55 HRC | Sip. Ölçüsü: | Ø35 x 163 | DIN 7168 m T
SON KAYIT: | 10 Mayıs 2021 Pazartesi 15:41:35 | Ağırlık: | 406.76 A4 | ÖLÇEK | 1:1

F:\My Backups\server yedek\ARGE\TASARIMLAR\PROJELER_01\
