smtzcn81/muhasebe/assets/urunler/pdf/1185030001.pdf

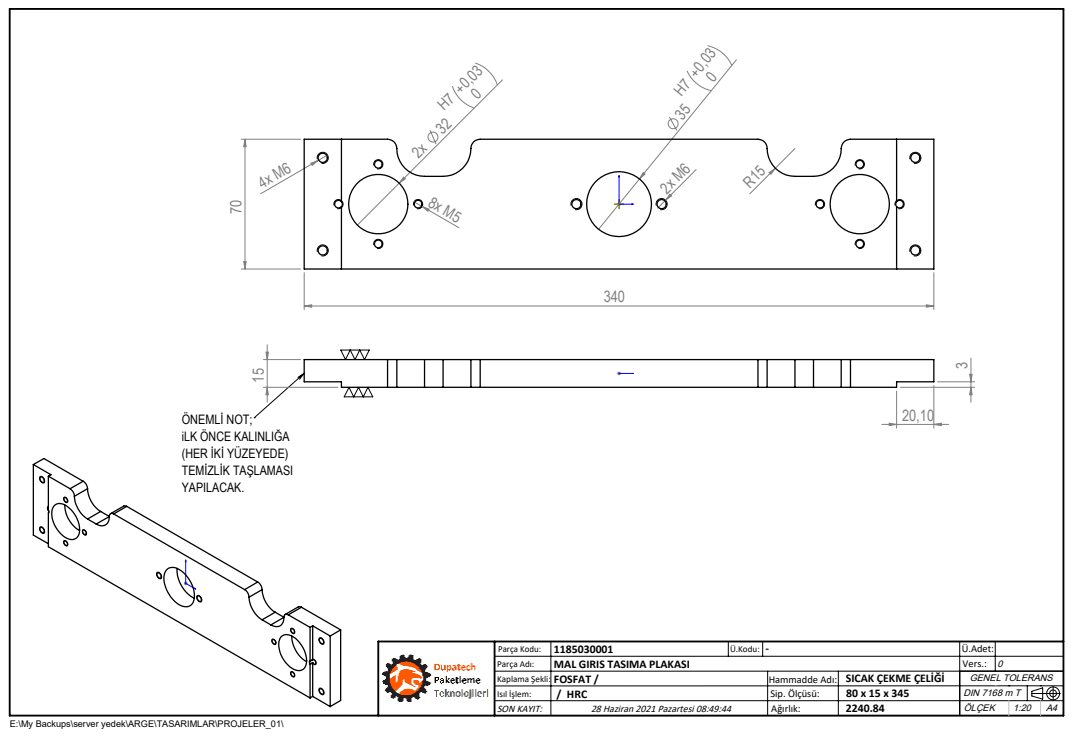
[picture p98: page 1]

ÖNEMLİ NOT;
iLK ÖNCE KALINLIĞA
(HER İKİ YÜZEYEDE)
TEMİZLİK TAŞLAMASI
YAPILACAK.

Parça Kodu: | 1185030001 | Ü.Kodu: | - | Ü.Adet:
Parça Adı: | MAL GIRIS TASIMA PLAKASI | | | Vers.: | 0
Kaplama Şekli: FOSFAT / | | Hammadde Adı: | SICAK ÇEKME ÇELİĞİ | GENEL TOLERANS
Isıl İşlem: | / HRC | Sip. Ölçüsü: | 80 x 15 x 345 | DIN 7168 m T
SON KAYIT: | 28 Haziran 2021 Pazartesi 08:49:44 | Ağırlık: | 2240.84 A4 | ÖLÇEK | 1:20

E:\My Backups\server yedek\ARGE\TASARIMLAR\PROJELER_01\
