smtzcn81/muhasebe/assets/urunler/pdf/1185030002_9SDS.pdf

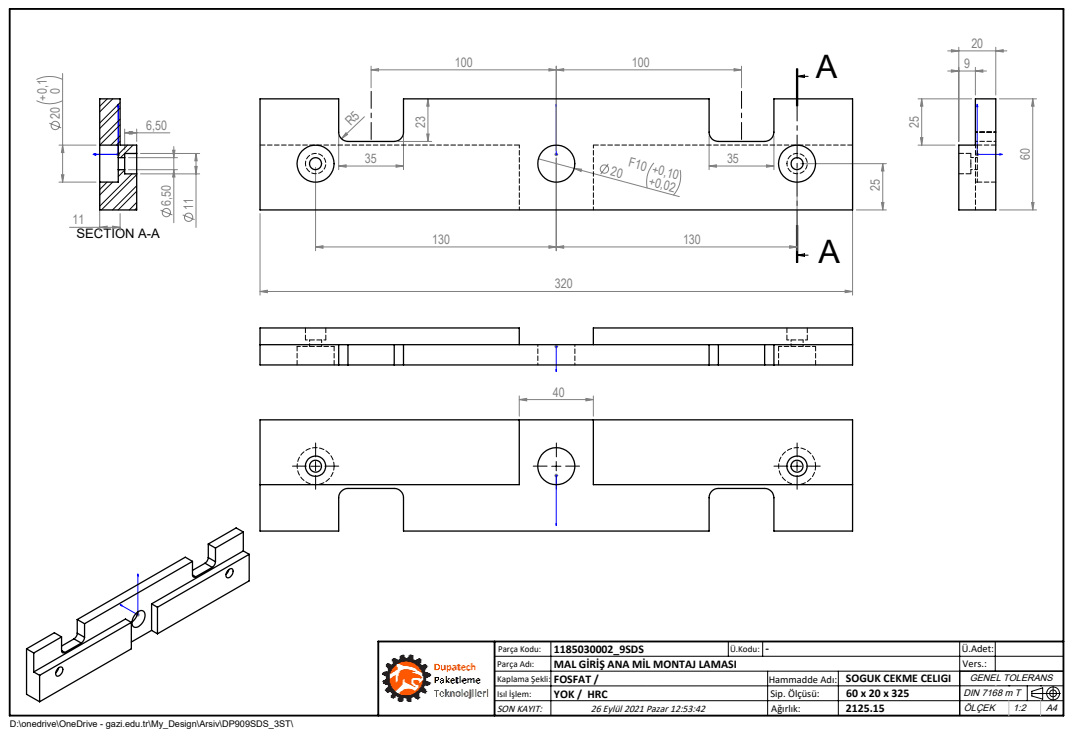
[picture p99: page 1]
SECTION A-A

Parça Kodu: | 1185030002_9SDS | Ü.Kodu: | - | Ü.Adet:
Parça Adı: | MAL GİRİŞ ANA MİL MONTAJ LAMASI | | | Vers.:
Kaplama Şekli: FOSFAT / | | Hammadde Adı: | SOGUK CEKME CELIGI | GENEL TOLERANS
Isıl İşlem: | YOK / HRC | Sip. Ölçüsü: | 60 x 20 x 325 | DIN 7168 m T
SON KAYIT: | 26 Eylül 2021 Pazar 12:53:42 | Ağırlık: | 2125.15 A4 | ÖLÇEK | 1:2

D:\onedrive\OneDrive - gazi.edu.tr\My_Design\Arsiv\DP909SDS_3ST\
