smtzcn81/muhasebe/assets/urunler/pdf/1186000009.pdf

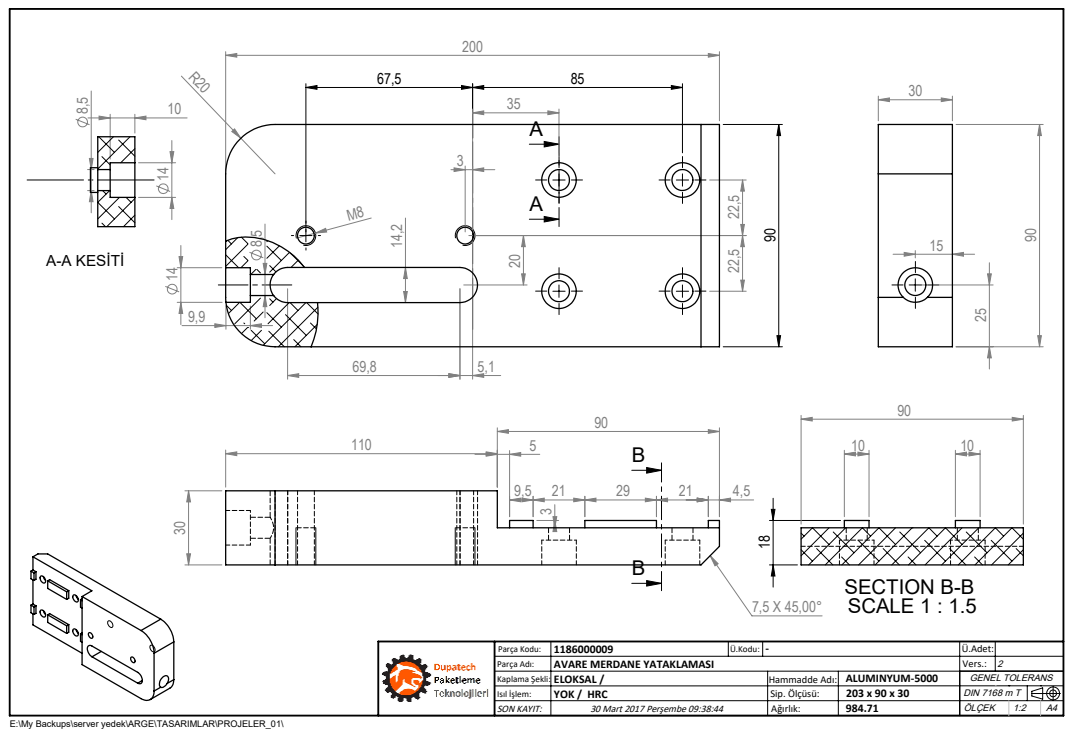
[picture p100: page 1]
SECTION B-B SCALE 1 : 1.5; A-A KESİTİ; Parça Kodu:; Parça Adı:; AVARE MERDANE YATAKLAMASI; SON KAYIT:; 30 Mart 2017 Perşembe 09:38:44; Kaplama Şekli: ELOKSAL /; Hammadde Adı: ALUMINYUM-5000; Sip. Ölçüsü:; GENEL TOLERANS; DIN 7168 m T; Ü.Kodu: -; Vers.: 2; Isıl İşlem:; YOK / HRC

E:\My Backups\server yedek\ARGE\TASARIMLAR\PROJELER_01\
