smtzcn81/muhasebe/assets/urunler/pdf/1186000009_6545A.pdf

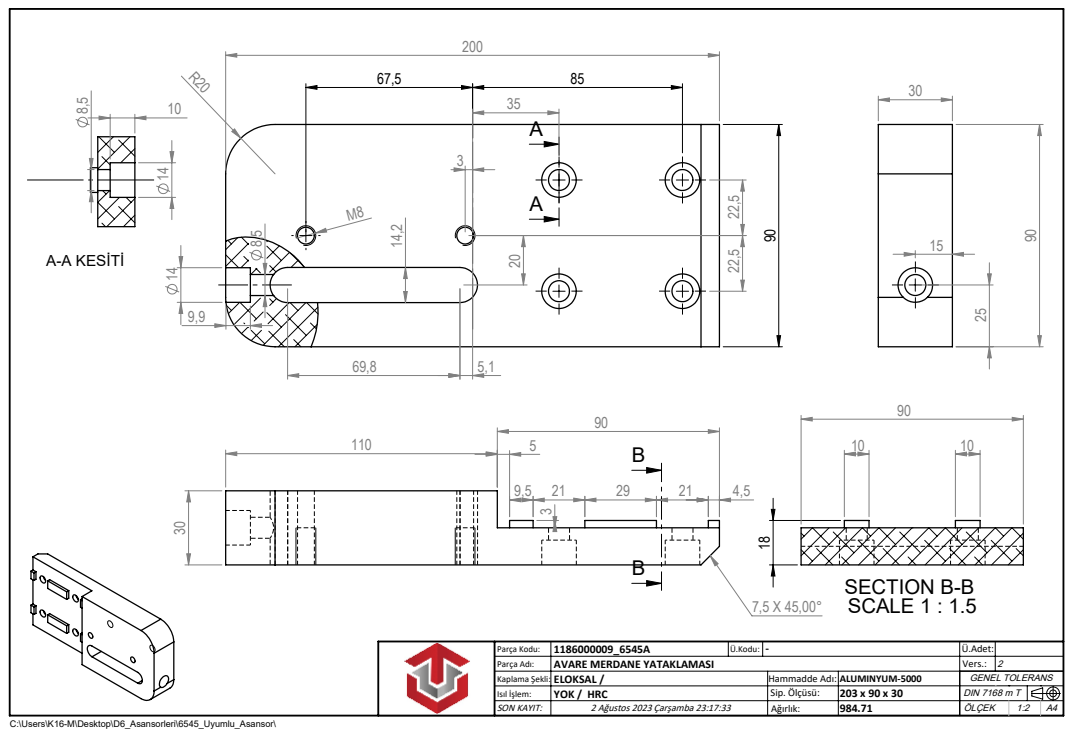
[picture p101: page 1]
SECTION B-B SCALE 1 : 1.5; A-A KESİTİ; Parça Kodu:; Parça Adı:; AVARE MERDANE YATAKLAMASI; SON KAYIT:; 2 Ağustos 2023 Çarşamba 23:17:33; Kaplama Şekli: ELOKSAL /; Hammadde Adı: ALUMINYUM-5000; Sip. Ölçüsü:; GENEL TOLERANS; DIN 7168 m T; Ü.Kodu: -; Vers.: 2; Isıl İşlem:; YOK / HRC
