smtzcn81/muhasebe/assets/urunler/pdf/1186000009_7XLD.pdf

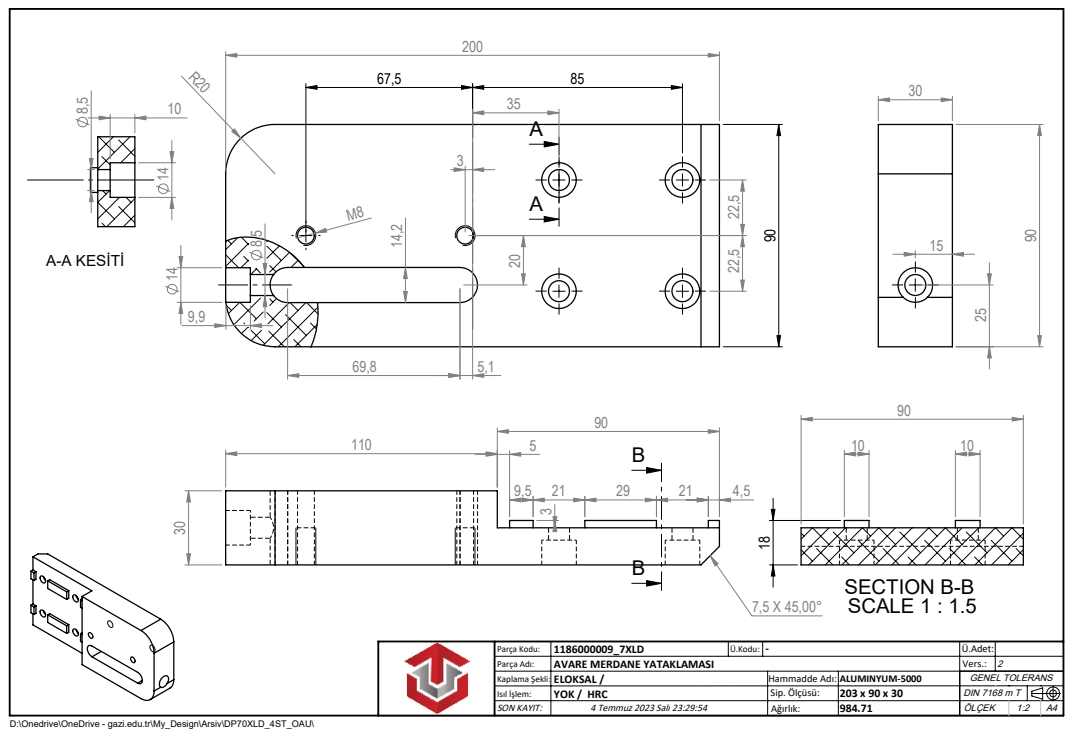
[picture p102: page 1]
SECTION B-B SCALE 1 : 1.5; A-A KESİTİ; Parça Kodu:; Parça Adı:; AVARE MERDANE YATAKLAMASI; SON KAYIT:; 4 Temmuz 2023 Salı 23:29:54; Kaplama Şekli: ELOKSAL /; Hammadde Adı: ALUMINYUM-5000; Sip. Ölçüsü:; GENEL TOLERANS; DIN 7168 m T; 1186000009_7XLD; Ü.Kodu: -; Vers.: 2; Isıl İşlem:; YOK / HRC

D:\Onedrive\OneDrive - gazi.edu.tr\My_Design\Arsiv\DP70XLD_4ST_OAU\
