smtzcn81/muhasebe/assets/urunler/pdf/1186000010.pdf

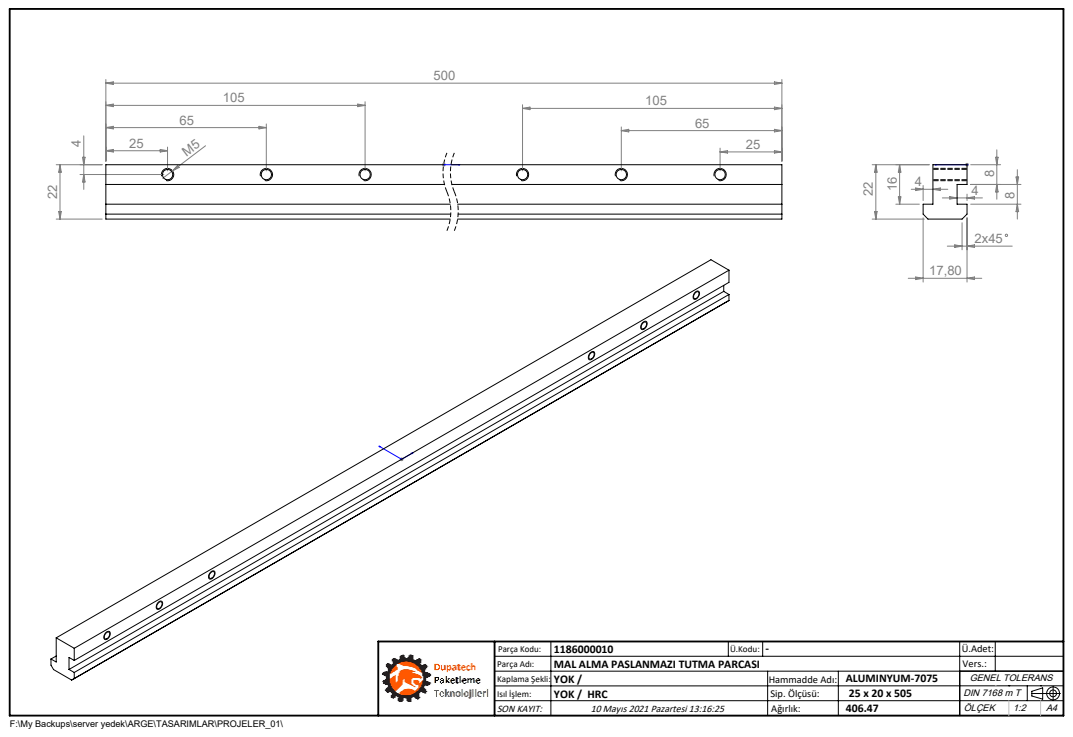
[picture p103: page 1]
Parça Kodu:; Parça Adı:; MAL ALMA PASLANMAZI TUTMA PARCASI; SON KAYIT:; 10 Mayıs 2021 Pazartesi 13:16:25; Kaplama Şekli: YOK /; Hammadde Adı: ALUMINYUM-7075; Sip. Ölçüsü:; GENEL TOLERANS; DIN 7168 m T; Ü.Kodu: -; Isıl İşlem:; YOK / HRC

F:\My Backups\server yedek\ARGE\TASARIMLAR\PROJELER_01\
