smtzcn81/muhasebe/assets/urunler/pdf/1186000010_6545A.pdf

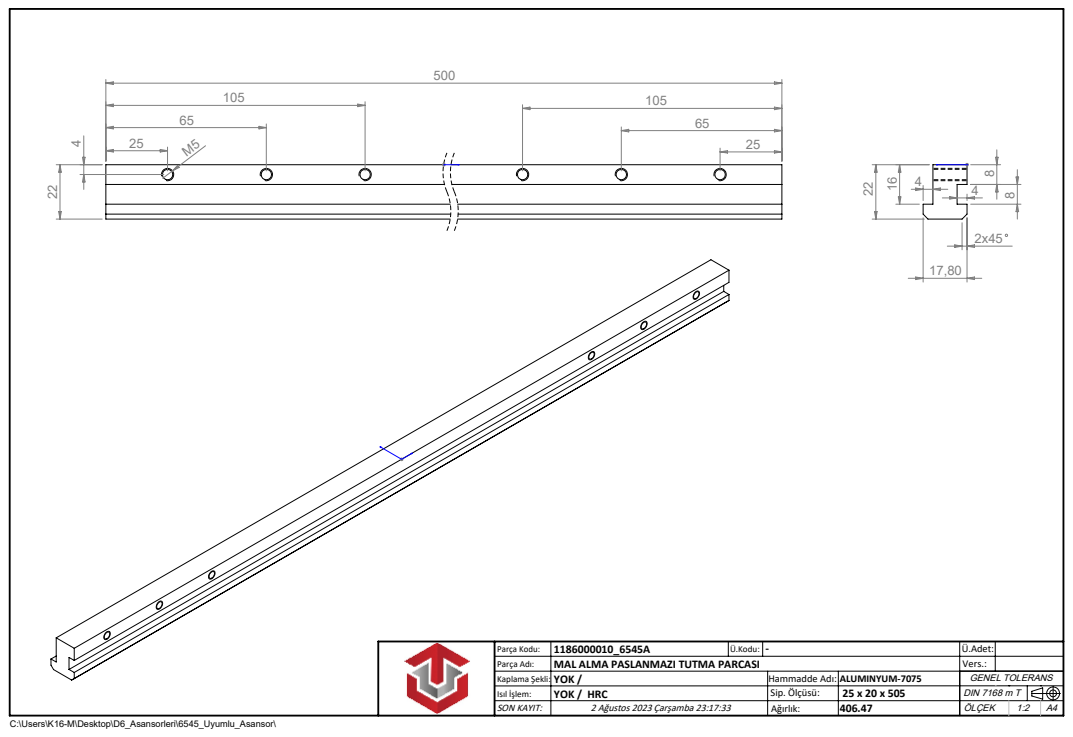
[picture p104: page 1]
Parça Kodu:; Parça Adı:; MAL ALMA PASLANMAZI TUTMA PARCASI; SON KAYIT:; 2 Ağustos 2023 Çarşamba 23:17:33; Kaplama Şekli: YOK /; Hammadde Adı: ALUMINYUM-7075; Sip. Ölçüsü:; GENEL TOLERANS; DIN 7168 m T; Ü.Kodu: -; Isıl İşlem:; YOK / HRC
