smtzcn81/muhasebe/assets/urunler/pdf/1186000010_7XLD.pdf

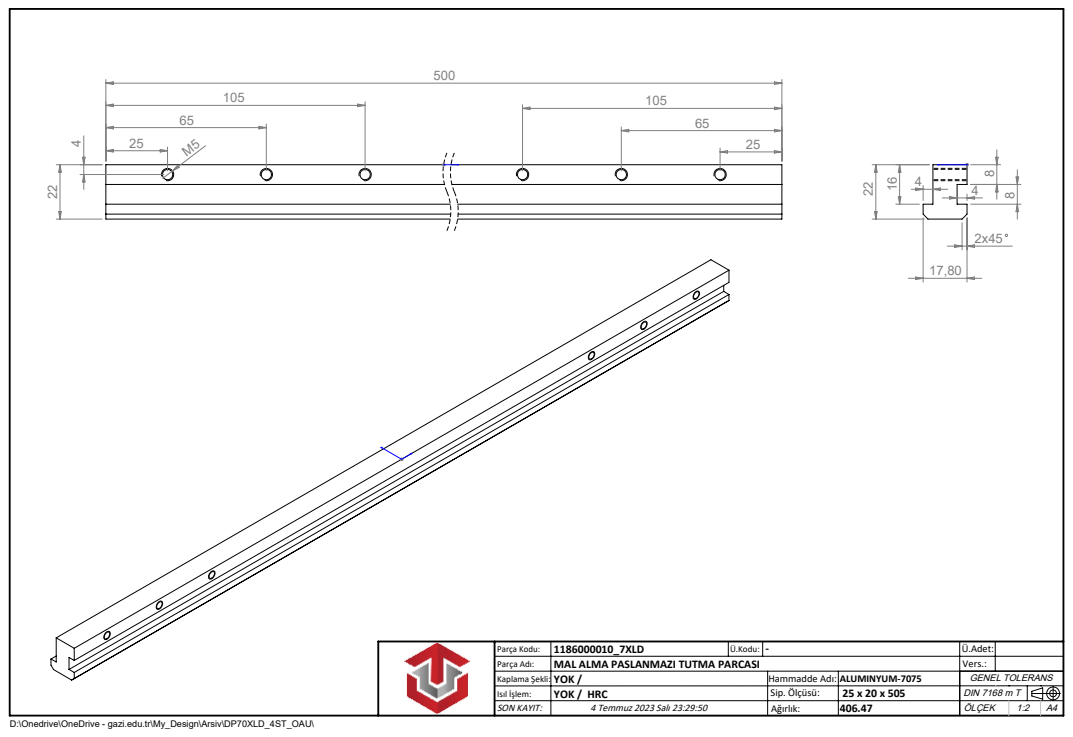
[picture p105: page 1]
Parça Kodu:; Parça Adı:; MAL ALMA PASLANMAZI TUTMA PARCASI; SON KAYIT:; 4 Temmuz 2023 Salı 23:29:50; Kaplama Şekli: YOK /; Hammadde Adı: ALUMINYUM-7075; Sip. Ölçüsü:; GENEL TOLERANS; DIN 7168 m T; 1186000010_7XLD; Ü.Kodu: -; Isıl İşlem:; YOK / HRC

D:\Onedrive\OneDrive - gazi.edu.tr\My_Design\Arsiv\DP70XLD_4ST_OAU\
